lbalucos/Wi4B_WiSN_5.0/projectwisn_v5_0_0productbookpart1/WiSN_v5.0.0_JN5169_MoB - Product Book (from WiSN_v4.3.0) v20220928.pdf

## WiSN_v5.0.0 – Product Book (Part 1) (starting from WiSN_v4.3.0 project)

Description: WiSN with JN5169 Chip (Module-on-PCB)

Starting from WiSN v4.3.0, make the following changes:

- Assign new version v5.0.0 to project
- Change JN5168-M06 module with JN5169 Chip (use the JN5169 block of WiCL_v1.0)
- Maintain AC side components
- Maintain the same PCB position for the main components
- Maintain the same position for Prog Header and Debug Header (for existing JIG test)
- If necessary make some PCB placement optimization

The changes are detailed in the following pages

Wi4B Doc.rev.20220928

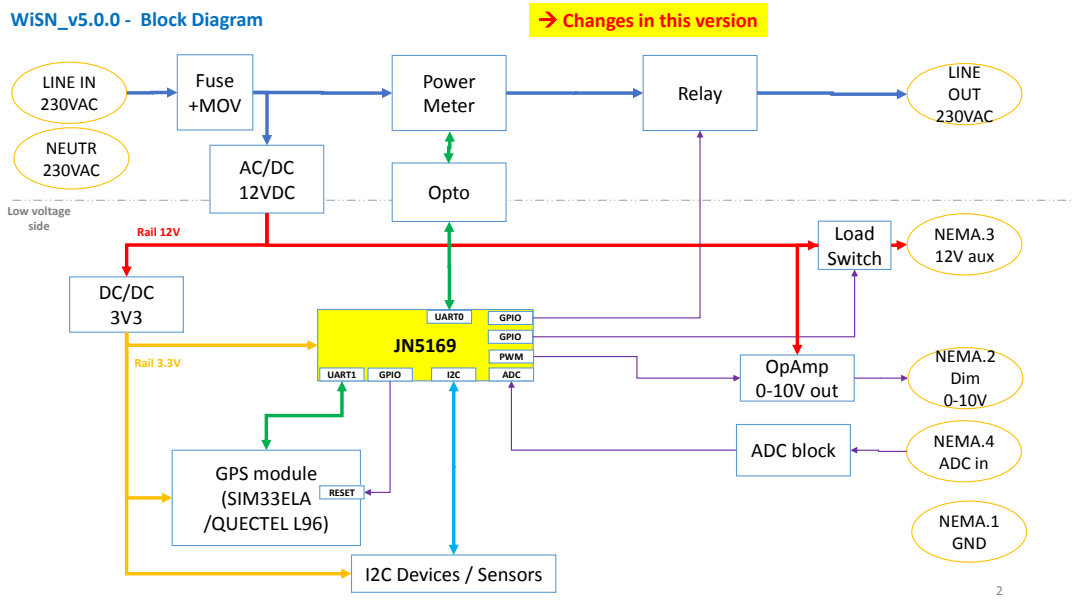
[picture p1: page 2]
Power Meter; AC/DC 12VDC; LINE OUT 230VAC; Opto; OpAmp 0-10V out; ADC block; NEMA.2; Dim 0-10V; NEMA.3 12V aux; NEMA.4; I2C Devices / Sensors; WiSN_v5.0.0 - Block Diagram; Fuse +MOV; UART1; UART0; ADC; PWM; GPIO; Load Switch; RESET; NEMA.1 GND; NEUTR 230VAC; Rail 12V; Rail 3.3V; Low voltage side

→ Changes in this version

Relay LINE IN
230VAC

ADC in GPS module
(SIM33ELA
/QUECTEL L96)

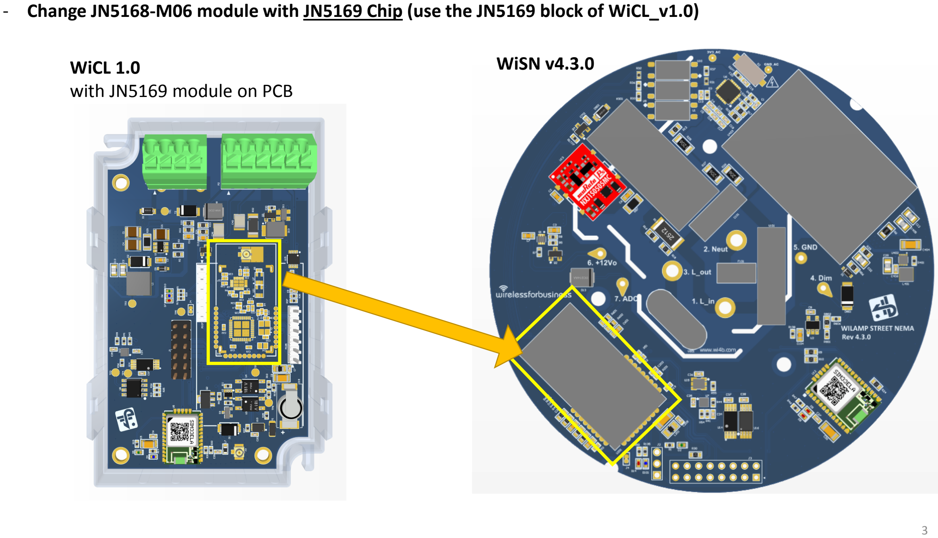
[picture p2: page 3]

WiCL 1.0 | WiSN v4.3.0
with JN5169 module on PCB
- Change JN5168-M06 module with JN5169 Chip (use the JN5169 block of WiCL_v1.0)

JN5169 – Pinout connections
See the ‘WiSN_v5.0.0 - JN5169-MoB Pin assignment.xlsx’ for Jennic connections

J2 – DEBUG Header Pinout

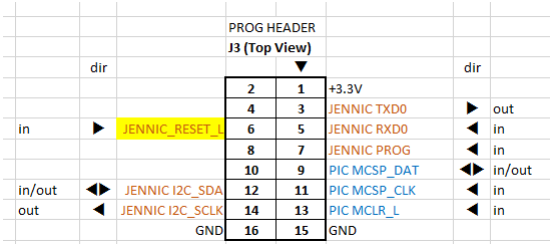
[picture p3: figure]

J3 – PROG Header Pinout

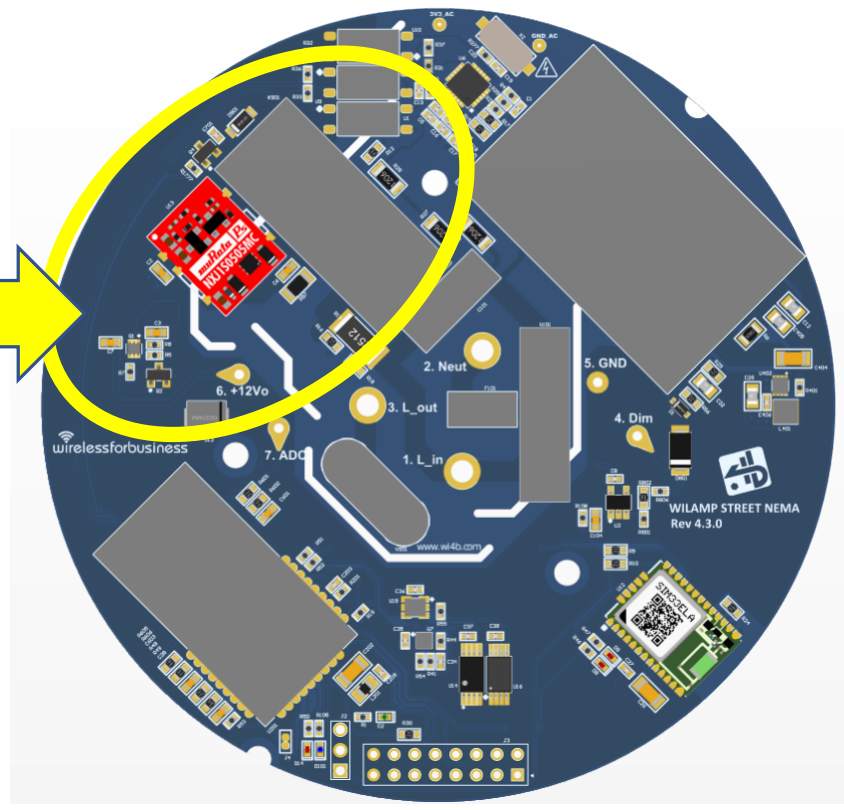
[picture p4: figure]

AC part / Isolation Slot - considerations

Some modifications to this part of the PCB will be required to increase the mechanical strength.

In current versions it occasionally happens that the welds of the Murata DC / DC break / crack.
We have noticed that as a result of external stresses, the two parts of the PCB, separated by the too long slot, undergo deformations at that point that cause the weld to break.

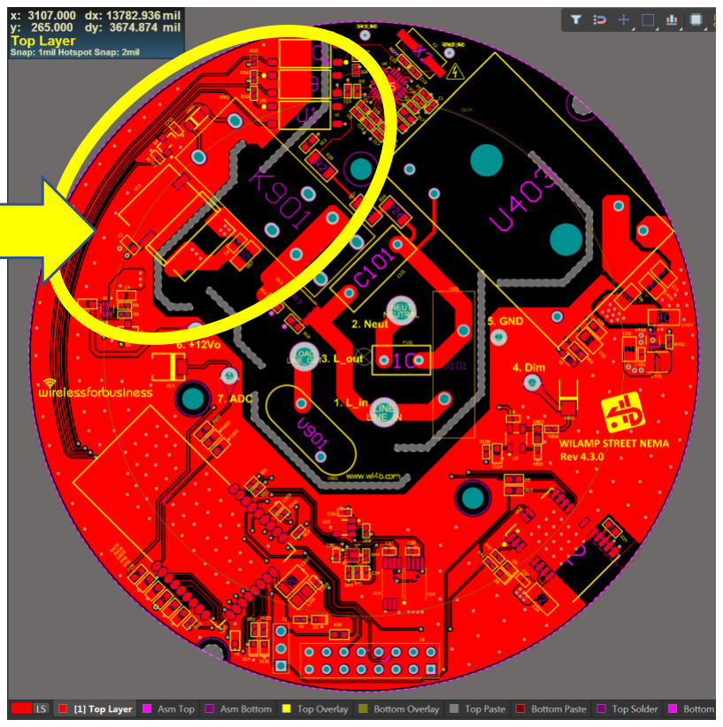
[picture p5: figure]

A solution could be to distance the Murata from the Relay in order to have more space in between and space for a slot with a different layout and possibly shorter under the Murata.

We are considering this point, we will give you more details later on how to proceed with the placement of the components
