lbalucos/Wi4B_WiSN_5.0/WiCL v1.0_rls_20201028/WiCL v1.0/mft/pcb/Impedance Control (50 ohms)/top_50.PNG

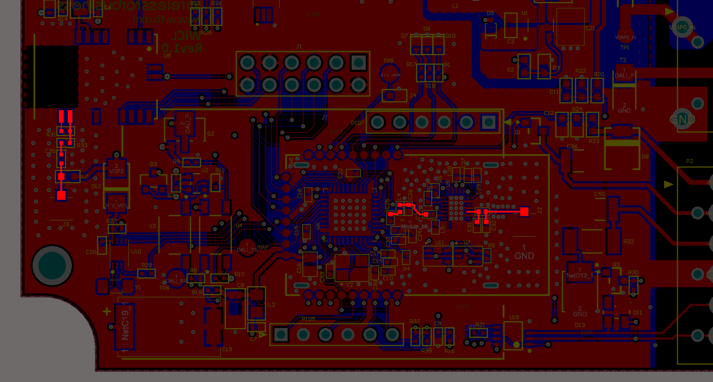
WiCL v1.0_rls_20201028/WiCL v1.0/mft/pcb/Impedance Control (50 ohms)/top_50.PNG
