lbalucos/Wi4B_WiSN_5.0/WiSN v5.0.0/docs/U13 DC-DC converter/Mornsun F0303XT-1WR2 footprint compared to MURATA NXE1S0303MC.png

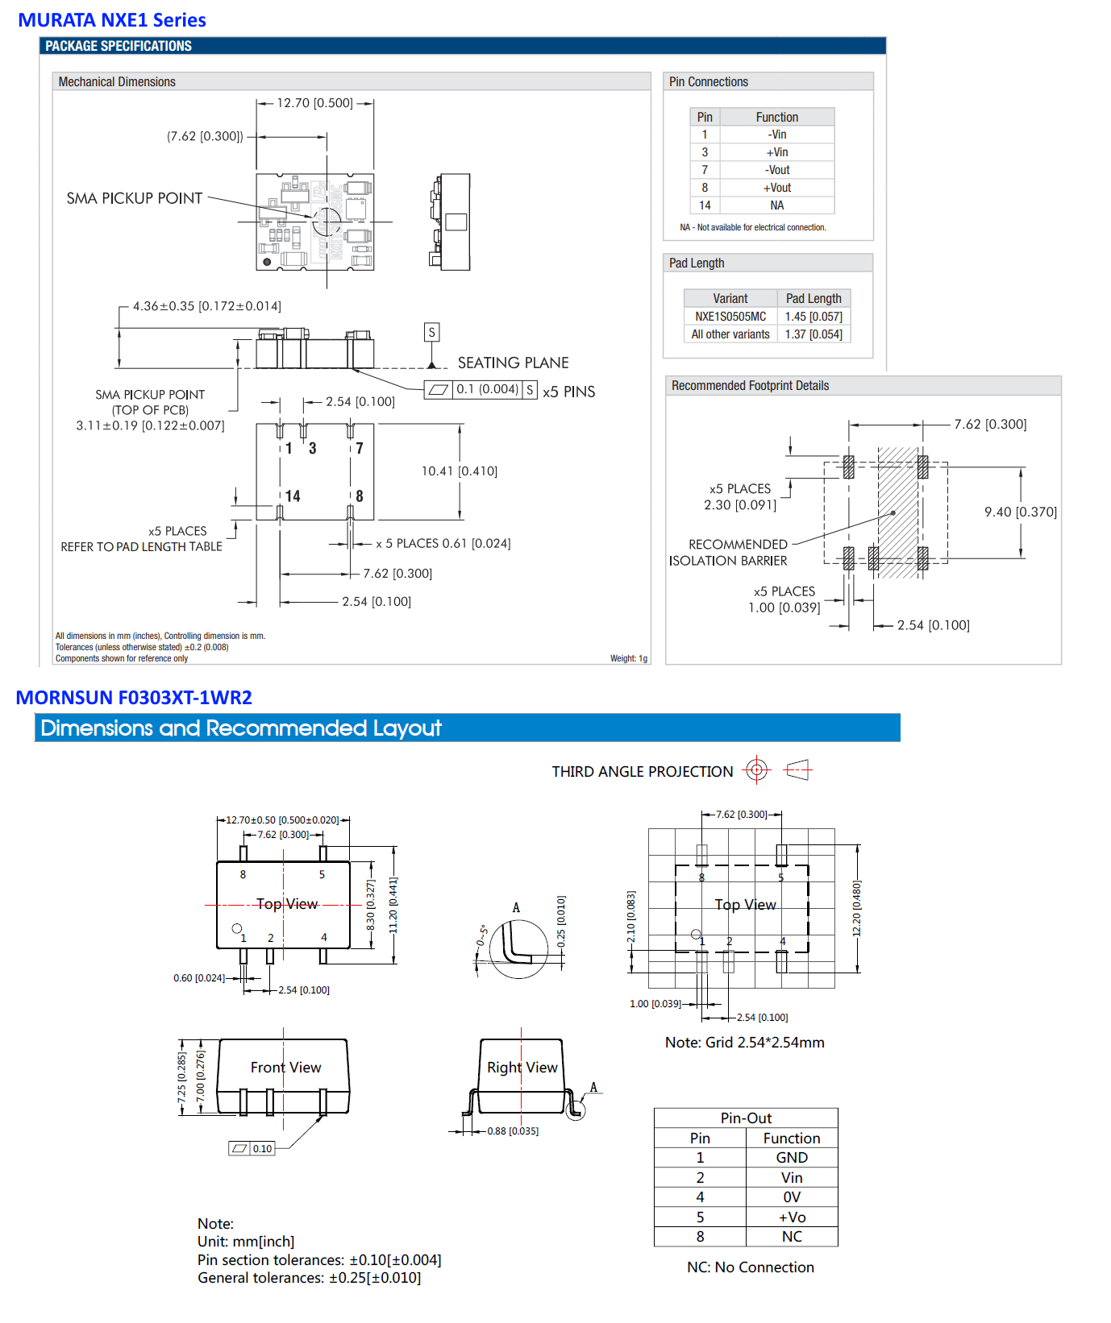
WiSN v5.0.0/docs/U13 DC-DC converter/Mornsun F0303XT-1WR2 footprint compared to MURATA NXE1S0303MC.png
