lbalucos/Wi4B_WiSN_5.0/WiCL v1.0_rls_20201028/WiCL v1.0/mft/pca/bom/wi4b_wicl_bom.xlsx

 |  |  | Project: WiCL
 |  |  | Document: BILL OF MATERIALS (BOM)
 |  |  | Revision: V1.0
 |  |  | Prepared By: AMTI
 |  |  | Release Date: 10/28/2020
 |  |  |  |  |  |  |  |  |  | PRICING
QTY | REFDES | DESC | VALUE | MFT | MPN | PACKAGE | RATING | TYPE | LOAD | Manufacturer 1 | Manufacturer Part Number 1 | Manufacturer Lifecycle 1 | Supplier 1 | Supplier Part Number 1 | Supplier Unit Price 1 | Supplier Subtotal 1
3 | C1, C4, C21 | CAP CER 4.7UF 50V X7R 1210 | 4.7µF | Taiyo Yuden | UMK325B7475KM-T | C1210 | 50V | SMD |  | KEMET | C1210C475K5RACTU | Volume Production | Newark | 29M4627 | 0.128 | 0.384
2 | C2, C13 | CAP CER 10UF 6.3V X7R 0805 | 10µF | Taiyo Yuden | JMK212B7106KG-T | C0805 | 6.3V | SMD |  | KEMET | C0805C106M9RACAUTO | Unknown | Newark | 33AC0561 | 0.065 | 0.325
1 | C3 | CAP CER 0.1UF 25V X7R 0603 | 0.1uF | Kyocera AVX | 06033C104JAT2A | C0603 | 25V | SMD |  | KEMET | C0603C104M3RACTU | Volume Production | Newark | 03M7460 | 0.005 | 0.005
2 | C5, C8 | CAP CER 10UF 16V X7R 1206 | 10µF | Murata Electronics North America | GRM31CR71C106KAC7L | C1206 | 16V | SMD |  | TDK | C3216X7R1C106M160AC | Volume Production | Newark | 87R4266 | 0.034 | 0.068
7 | C6, C7, C9, C20, C34, C35, C37 | CAP CER 0.1UF 50V X7R 0402 | 0.10µF | Murata Electronics North America | GRM155R71H104ME14D | C0402 | 50V | SMD |  | Murata | GCM155R71H104KE02D | Volume Production | Arrow Electronics | GCM155R71H104KE02D | 0.0533 | 0.3731
6 | C10, C15, C17, C18, C23, C27 | CAP CER 0.1UF 10V 10% X5R 0402 | 0.1µF | Murata Electronics North America | GRM155R61A104KA01D | C0402 | 10V | SMD |  | Kyocera AVX | 0402ZD104KAT2A | Volume Production | Newark | 34M9179 | 0.002 | 0.012
1 | C11 | CAP CER 0.22UF 50V X7R 0603 | 0.22µF | Murata Electronics North America | GCM188R71H224KA64D | C0603 | 50V | SMD |  | TDK | C1608X7R1H224K080AB | Volume Production | Newark | 87R3734 | 0.033 | 0.033
1 | C12 | CAP CER 0.22UF 50V X7R 0603 | 0.22µF | Murata Electronics North America | GCM188R71H224KA64D | C0603 | 50V | SMD |  | Murata | GCM188R71H224KA64D | Volume Production | Arrow Electronics | GCM188R71H224KA64D | 0.0269 | 0.0269
1 | C14 | CAP CER 10000PF 25V X7R 0402 | 10000pF | Murata Electronics North America | GRM155R71E103KA01D | C0402 | 25V | SMD |  | Vishay Vitramon | VJ0402Y103KXXCW1BC | Volume Production | Newark | 62AC8249 | 0.002 | 0.002
1 | C16 | CAP CER 10UF 10V X5R 0805 | 10µF | Murata | GRT21BR61A106KE01L | CAPC2012X135N | 10V | SMD |  | Samsung | CL21A106KPCLQNC | Volume Production | Newark | 82AC9392 | 0.011 | 0.011
1 | C19 | CAP 330MF -20% +80% 3.3V SMD | 330mF | Elna | DSK-3R3H334T-HL | ELNA_DSK-3R3H334T-HL | 3.3V | SMD |  | Elna | DSK-3R3H334T-HL | Volume Production | Digi-Key | 604-1160-6-ND | 2.09 | 2.09
1 | C22 | CAP CER 0.1UF 10V 10% X5R 0402 | 0.1µF | Murata Electronics North America | GRM155R61A104KA01D | C0402 | 10V | SMD | DNP | Kyocera AVX | 0402ZD104KAT2A | Volume Production | Newark | 34M9179 | 0.002 | 0.002
1 | C24 | CAP CER 47PF 50V C0G/NP0 0402 | 47pF | Murata | GRM1555C1H470JA01D | CAPC1005X55N | 50V | SMD |  | KEMET | C0402C470J5GACTU | Volume Production | Newark | 03C3054 | 0.002 | 0.002
1 | C25 | CAP CER 1.8PF 50V C0G/NP0 0402 | 1.8pF | Murata | GRM1555C1H1R8CA01D | CAPC1005X55N | 50V | SMD |  | KEMET | C0402C189C5GACTU | Volume Production | Newark | 11AC2872 | 0.011 | 0.011
1 | C26 | CAP CER 1PF 50V C0G/NP0 0402 | 1pF | Murata | GRM1555C1H1R0CA01D | CAPC1005X55N | 50V | SMD |  | TDK | C1005C0G1H010B050BA | Volume Production | Newark | 90R7555 | 0.003 | 0.003
2 | C28, C29 | CAP CER 10PF 50V 5% NP0 0402 | 10pF | Murata Electronics North America | GRM1555C1H100JA01D | C0402 | 50V | SMD |  | Yageo | CC0402JRNPO9BN100 | Volume Production | Newark | 65R7554 | 0.005 | 0.01
3 | C30, C31, C32 | CAP CER 1.2PF 50V C0G/NP0 0402 | 1.2pF | Murata | GRM1555C1H1R2CA01D | CAPC1005X55N | 50V | SMD |  | KEMET | C0402C129C5GACTU | Volume Production | Newark | 01J3923 | 0.003 | 0.009
2 | C33, C38 | CAP CER 12PF 50V C0G/NP0 0402 | 12pF | Murata | GRM1555C1H120JA01D | CAPC1005X55N | 50V | SMD |  | Kyocera AVX | 04025A120JAT2A | Volume Production | Newark | 34M9190 | 0.002 | 0.004
2 | C36, C40 | CAP 22nF 500V ±10% 1210 (3225 Metric) Thickness 1.9mm SMD | 22nF |  | 12107C223KAT2A | CAPC1210(3225)190_N |  | SMD |  | Kyocera AVX | 12107C223KAT2A | Volume Production | Newark | 30H1157 | 0.07 | 0.14
1 | C39 | CAP CER 22PF 50V NP0 0402 | 22pF | Murata Electronics North America | GRM1555C1H220JA01J | C0402 | 50V | SMD |  | KEMET | C0402C220K5GACTU | Volume Production | Newark | 07X0698 | 0.002 | 0.002
1 | D1 | DIODE SCHOTTKY 20V 0.5A SOD123 |  |  | MBR0520L | SOD123 |  | SMD |  | Vishay | MBR0520L | Unknown | Digi-Key | MBR0520LCT-ND | 0.34 | 0.34
2 | D2, D12 | DIODE SCHOTTKY 40V 1A SMA | B140-13-F | Diodes | B140-13-F | DO-214AC, SMA | 40V | SMD |  | Diodes | B140-13-F | Volume Production | Digi-Key | B140-FDICT-ND | 0.37 | 0.74
1 | D3 | DIODE ZENER 3V 250MW TO236AB |  |  | BZX84-C3V0,215 | SOT-23(TO-236AB) |  | SMD |  | Nexperia | BZX84-C3V0,215 | Unknown | Digi-Key | 1727-5032-6-ND | 0.13 | 0.13
1 | D4 | LED BLUE 0402 SMD | Blue | Vishay Semiconductor Opto Division | VLMB1500-GS08 | LED0402(BLUE) |  | SMD | DNP | Vishay | VLMB1500-GS08 | Not Recommended for New Design | Future Electronics | 4101061 | 0.188 | 0.188
1 | D5 | LED GREEN CLEAR CHIP SMD | green | SunLED | XZVG68W-2 | LED0402(GREEN) |  | SMD | DNP | SunLED | XZVG68W-2 | Volume Production | Digi-Key | 1497-1219-1-ND | 0.5 | 0.5
1 | D6 | LED BLUE 0402 SMD | Blue | Vishay Semiconductor Opto Division | VLMB1500-GS08 | LED0402(BLUE) |  | SMD |  | Vishay | VLMB1500-GS08 | Not Recommended for New Design | Future Electronics | 4101061 | 0.188 | 0.188
1 | D7 | LED RED 0402 SMD | Red | Vishay Semiconductor Opto Division | VLMS1500-GS08 | LED0402(RED) |  | SMD |  | Vishay | VLMS1500-GS08 | Volume Production | Arrow Electronics | VLMS1500-GS08 | 0.2977 | 0.2977
1 | D8 | TVS DIODE 33VWM 53.3VC SMB | SMBJ33A-TP | Micro Commercial Co | SMBJ33A-TP | DO-214AA, SMB | 33V | SMD |  | MCC | SMBJ33A-TP | Volume Production | Digi-Key | SMBJ33A-TPMSDKR-ND | 0.45 | 0.45
1 | D9 | DIODE GEN PURP 75V 250MA SOD323 | 1N4448WS-7-F | Diodes | 1N4448WS-7-F | SOD-323 | 75V | SMD |  | Diodes | 1N4448WS-7-F | Volume Production | Newark | 96AC5303 | 0.02 | 0.02
1 | D10 | LED GREEN CLEAR CHIP SMD | green | SunLED | XZVG68W-2 | LED0402(GREEN) |  | SMD |  | SunLED | XZVG68W-2 | Volume Production | Digi-Key | 1497-1219-6-ND | 0.5 | 0.5
1 | D11 | TVS Diode Array, 30 pF, 30 KV, -40 to 85 degC, 4-Pin SOT143, RoHS, Tape and Reel |  |  | SP0503BAHTG | LFUS-SOT143-4_V |  | SMD |  | Littelfuse | SP0503BAHTG | Volume Production | Newark | 06X3961 | 0.373 | 0.373
1 | D13 | 3 W Zener Voltage Regulator, 2-Pin SMB, Pb-Free, Tape and Reel |  |  | SZ1SMB5925BT3G | ONSC-SMB-2-403A-03_H_V |  | SMD |  | ON Semiconductor | SZ1SMB5925BT3G | Volume Production | Mouser | 863-SZ1SMB5925BT3G | 0.62 | 0.62
1 | J1 | CONN HEADER VERT 12POS 2.54MM | 61301221121 | Wurth Electronics | 61301221121 | 61301221121 |  | TH |  | Wurth Electronics | 61301221121 | Volume Production | Digi-Key | 732-5297-ND | 0.78 | 0.78
1 | J2 | RF Connectors / Coaxial Connectors SMT MALE RECEPT AU | U.FL-R-SMT-1(80) | Hirose | U.FL-R-SMT-1(80) | HIROSE_U.FL-R-SMT |  | SMD |  | Hirose | U.FL-R-SMT-1(80) | Volume Production | Future Electronics | 7097379 | 1.12 | 1.12
1 | J3 | CONN UMC JACK STR 50 OHM SMD | U.FL-R-SMT-1(10) | Hirose Electric Co Ltd | U.FL-R-SMT-1(10) | U.FL-R-SMT-1(10) |  | SMD |  | Hirose | U.FL-R-SMT-1(10) | Volume Production | Mouser | 798-U.FL-R-SMT-110 | 1.22 | 1.22
1 | J4 |  |  |  |  | 0603 Jumper
1 | Jennic pinout |  |  |  |  | JN516X PINOUT
1 | L1 | Fixed Inductors MSS6132 AEC-Q200 15 uH 20 % 2.2 A | 15uH | Coilcraft | MSS6132-153MLC | MSS6132-153MLC |  | SMD |  | Coilcraft | MSS6132-153MLC | Volume Production | Mouser | 994-MSS6132-153MLC | 1.38 | 1.38
1 | L2 | FERRITE CHIP 120 OHM 0805 | 120 Ohm | Murata Electronics North America | BLM21PG121SN1D | 0805 INDUCTOR | 3A | SMD |  | Murata | BLM21PG121SN1D | Volume Production | Arrow Electronics | BLM21PG121SN1D | 0.0918 | 0.0918
1 | L3 | FIXED IND 3NH 190MA 400 MOHM SMD | 3nH | Murata | LQP15MN3N0B02D | INDC1005X45N |  | SMD |  | Murata | LQP15MN3N0B02D | Volume Production | Arrow Electronics | LQP15MN3N0B02D | 0.079 | 0.079
1 | L4 | FIXED IND 4.3NH 160MA 600 MOHM | 4.3nH | Murata | LQP15MN4N3B02D | INDC1005X45N |  | SMD |  | Murata | LQP15MN4N3B02D | Volume Production | Arrow Electronics | LQP15MN4N3B02D | 0.0876 | 0.0876
1 | L5 | Inductor RF Chip ThFIXED IND 5.1NH 140MA 700 MOHM | 5.1nH | Murata | LQP15MN5N1B02D | INDC1005X45N |  | SMD |  | Murata | LQP15MN5N1B02D | Volume Production | Arrow Electronics | LQP15MN5N1B02D | 0.1271 | 0.1271
1 | L6 | FIXED IND 2.7NH 220MA 300 MOHM | 2.7nH | Murata | LQP15MN2N7B02D | INDC1005X45N |  | SMD |  | Murata | LQP15MN2N7B02D | Volume Production | Arrow Electronics | LQP15MN2N7B02D | 0.1516 | 0.1516
1 | L7 | FIXED IND 33NH 100MA 2.8 OHM SMD | 33nH | Murata Electronics North America | LQP18MN33NG02D | 0603 INDUCTOR | 100MA 2.8 OHM | SMD |  | Murata | LQP18MN33NG02D | Volume Production | Arrow Electronics | LQP18MN33NG02D | 0.167 | 0.167
1 | P1 | Fixed Terminal Blocks PTSA 1.5/4-3.5-Z | 1985218 | Phoenix Contact | 1985218 | 1985218 (4pin) |  | TH |  | Phoenix Contact | 1985218 | Volume Production | Allied Electronics | 70055071 | 0.51 | 0.51
1 | P2 | TERM BLOCK PCB 6POS 3.5MM GREEN | 1985234 | Phoenix Contact | 1985234 | 1985234 (6 PIN) |  | TH |  | Phoenix Contact | 1985234 | Volume Production | Farnell | 1792773 | 0.79955 | 0.79955
2 | P105, P107 | CONN HEADER 6POS .100 VERT TIN | 22284060 | Molex Inc | 22284060 | HDR1X6 |  | TH |  | Molex | 22-28-4060 | Volume Production | Newark | 94C4038 | 0.105 | 0.21
2 | Q1, Q3 | IC INDCT LOAD DRVR AUTO SOT23 | NUD3124LT1G | ON Semiconductor | NUD3124LT1G | SOT-23-3 |  | SMD |  | ON Semiconductor | NUD3124LT1G | Volume Production | Newark | 04R7856 | 0.134 | 0.268
1 | Q2 | TRANS NPN MED 1A 80V SOT89 |  |  | BCX56-16,115 | SOT 89-3 |  | SMD |  | Nexperia | BCX56-16,115 | Unknown | Digi-Key | 1727-2930-6-ND | 0.39 | 0.39
9 | R1, R11, R17, R18, R30, R36, R37, R38, R39 | RES SMD 1K OHM 1% 1/10W 0402 | 1k | Vishay Beyschlag | MCS04020C1001FE000 | R0402 | 1/10W | SMD |  | Vishay Beyschlag | MCS04020C1001FE000 | Volume Production | Newark | 65AC3521 | 0.234 | 2.11
1 | R2 | RES SMD 31.6K OHM 1% 1/10W 0603 | 31.6k | Panasonic | ERJ-3EKF3162V | R0603 | 1/10W | SMD |  | KOA Speer | RK73H1JTTDD3162F | Volume Production | Arrow Electronics | RK73H1JTTDD3162F | 0.002 | 0.002
1 | R3 | RES SMD 10K OHM 1% 1/10W 0603 | 10k | Panasonic Electronic Components | ERJ-3EKF1002V | R0603 | 0.1W, 1/10W | SMD |  | Vishay | CRCW0603-10K0FKEA | Volume Production | Newark | 61M5335 | 0.003 | 0.003
1 | R4 | RES SMD 43K OHM 1% 1/16W 0402 | 43k | Yageo | RC0402FR-0743KL | RESC1005X40N | 1/16W | SMD |  | Vishay | CRCW040243K0FKED | Volume Production | Newark | 26W9119 | 0.003 | 0.03
2 | R5, R19 | RES SMD 47K OHM 1% 1/16W 0402 | 47k | Yageo | RC0402FR-0747KL | R0402 | 1/16W | SMD |  | Bourns | CR0402-FX-4702GLF | Volume Production | Newark | 87W5956 | 0.003 | 0.006
1 | R6 | RES SMD 1.5K OHM 1% 1/16W 0402 | 1.5k | Yageo | RC0402FR-071K5L | RESC1005X40N | 1% 1/16W | SMD |  | Vishay | CRCW0402-1K50FKED | Volume Production | Newark | 42K3374 | 0.003 | 0.003
1 | R7 | RES SMD 422 OHM 1% 1/10W 0402 | 422 | Panasonic Electronic Components | ERJ-2RKF4220X | R0402 | 1/10W | SMD |  | Samsung | RC1005F4220CS | Volume Production | Arrow Electronics | RC1005F4220CS | 0.036 | 0.036
1 | R8 | RES SMD 4.7K OHM 1% 1/16W 0402 | 4.7k | Yageo | RT0402FRE074K7L | R0402 | 1/16W | SMD |  | Yageo | RC0402FR-074K7L | Volume Production | Newark | 75X0133 | 0.004 | 0.004
5 | R9, R10, R28, R40, R41 | RES SMD 330 OHM 1% 1/16W 0402 | 330 | Vishay Dale | CRCW0402330RFKED | R0402 | 1/16W | SMD |  | TE Connectivity | CRG0402F330R | Volume Production | Arrow Electronics | CRG0402F330R | 0.0019 | 0.0095
1 | R12 | RES SMD 1.2K OHM 1% 1/16W 0402 | 1.2k | Yageo | RC0402FR-071K2L | RESC1005X40N | 1/16W | SMD |  | Vishay | CRCW04021K20FKED | Volume Production | Newark | 89M6589 | 0.005 | 0.005
3 | R13, R25, R26 | RES SMD 1K OHM 1% 1/10W 0402 | 1k | Vishay Beyschlag | MCS04020C1001FE000 | R0402 | 1/10W | SMD | DNP | Panasonic | ERJ-2RKF1001X | Volume Production | Newark | 38AH8221 | 0.006 | 0.018
2 | R14, R15 | RES SMD 330 OHM 1% 1/16W 0402 | 330 | Vishay Dale | CRCW0402330RFKED | R0402 | 1/16W | SMD | DNP | TE Connectivity | CRG0402F330R | Volume Production | Arrow Electronics | CRG0402F330R | 0.0019 | 0.0038
1 | R16 | RES SMD 4.7K OHM 1% 1/10W 0402 | 4.7k | Vishay Beyschlag | MCS04020C4701FE000 | R0402 | 1/10W | SMD |  | Panasonic | ERJ-2RKF4701X | Volume Production | Newark | 64R5288 | 0.003 | 0.003
2 | R20, R23 | RES SMD 68K OHM 0.1% 1/10W 0603 | 68k | Panasonic Electronic Components | ERA-3AEB683V | R0603 | 1/10W | SMD |  | Susumu | RG1608P-683-B-T5 | Volume Production | Arrow Electronics | RG1608P-683-B-T5 | 0.0939 | 0.1878
2 | R21, R27 | RES SMD 0.0OHM JUMPER 1/16W 0402 | 0 | Vishay Dale | CRCW04020000Z0ED | R0402 | 63mW | SMD |  | Vishay | CRCW04020000Z0ED | Volume Production | Newark | 24W1849 | 0.004 | 0.008
2 | R22, R24 | RES SMD 5.6K OHM 0.1% 1/10W 0603 | 5.6k | Panasonic Electronic Components | ERA-3AEB562V | R0603 | 1/10W | SMD |  | Panasonic | ERA-3AEB562V | Volume Production | Newark | 01X1328 | 0.015 | 0.03
1 | R29 | RES 1K OHM 1% 1/2W 1206 | 1k | Stackpole Electronics | RNCP1206FTD1K00 | R1206 | 1/2W | SMD |  | Vishay Dale | CRCW12061K00FKEAHP | Volume Production | Newark | 68R3002 | 0.039 | 0.039
1 | R31 | RES SMD 0.0OHM JUMPER 1/10W 0402 | 0 | Vishay Beyschlag | MCS04020Z0000ZE000 | R0402 | 0.1W | SMD | DNP
1 | R32 | RES Thick Film, 470O, 5%, 0.75W, 200ppm/°C, 2010 | 470 |  |  | FP-CRCW2010-e3-MFG |  | SMD |  | Panasonic | ERJ-12ZYJ471U | Volume Production | Newark | 53W4089 | 0.027 | 0.027
1 | R33 | RES SMD 0.0OHM JUMPER 1/10W 0402 | 0 | Vishay Beyschlag | MCS04020Z0000ZE000 | R0402 | 0.1W | SMD
1 | SH1 | Shield | 42-100017-01 | TSC | 42-100017-01 | 42-100017-01(Shield) |  | SMD
1 | T2 | TVS Diodes - Transient Voltage Suppressors 22Vr 400W 11.3A 5% BiDirectional | SMAJ22CA | Littelfuse | SMAJ22CA | DO-214AC | 22 V | SMD |  | Littelfuse | SMAJ22CA | Volume Production | Newark | 71J1991 | 0.086 | 0.086
7 | TP1, TP2, TP3, TP4, TP5, TP6, TP7 | Test Point 2mm |  |  |  | Test Point 2mm |  | SMD
7 | TP8, TP9, TP10, TP11, TP12, TP13, TP14 | Test Point 3mm |  |  |  | Test Point 3mm |  | SMD
1 | U1 | IC REG BUCK ADJ 0.6A SOT23-6 | MCP16301T-I/CHY | Microchip | MCP16301T-I/CHY | SOT-23-6 | 0.6A | SMD |  | Microchip | MCP16301T-I/CHY | Volume Production | Newark | 58T3650 | 0.847 | 0.847
1 | U2 | NXP - PSSI2021SAY,115 - IC, CURRENT REGULATOR, 75V, 50MA, 5-SOT-353, FULL REEL | PSSI2021SAY,115 |  | PSSI2021SAY,115 | SOT353 |  | SMD |  | Nexperia | PSSI2021SAY,115 | Unknown | Newark | 70R7980 | 0.084 | 0.084
2 | U3, U4 | OPTOISOLATOR 3.75KV TRANS 4-SOP | LTV-357T | Lite-On Inc. | LTV-357T | 4SMD(gull wing) | 3.75KV | SMD |  | Vishay Lite-On | LTV-356T | Volume Production | Mouser | 859-LTV-356T | 0.25 | 0.5
1 | U5 | A-GPS receiver, with built-in Antenna | SIM33ELA | SIMCom | SIM33ELA | SIM33ELA |  | SMD
1 | U6 | IC RF TXRX+MCU 802.15.4 40-VFQFN | JN5169/001Z | NXP Semiconductors | JN5169/001Z | QFN50P600X600X100-41N |  | SMD |  | NXP Semiconductors | JN5169/001Z | Volume Production | Mouser | 771-JN5169/001Z | 5.62 | 5.62
2 | U7, U11 | IC GATE OR 1CH 2-INP 5TSSOP | 74AHC1G32GW,125 | Nexperia | 74AHC1G32GW,125 | SOT65P210X110-5N |  | SMD |  | Nexperia | 74AHC1G32GW,125 | Unknown | Digi-Key | 1727-3150-1-ND | 0.27 | 0.54
1 | U8 | IC EEPROM 32KBIT 400KHZ 8SO | M24C32-RMN6TP | STMicroelectronics | M24C32-RMN6TP | 8-SOIC |  | SMD |  | STMicroelectronics | M24C32-RMN6TP | Volume Production | Newark | 51AC9289 | 0.09 | 0.09
1 | U9 | IC RF FRONT END MOD 2.4GHZ 24QFN | SE2431L-R | Skyworks | SE2431L-R | QFN40P300X400X90-25N-D |  | SMD |  | Skyworks Solutions | SE2431L-R | Volume Production | Digi-Key | 863-1347-6-ND | 3.28 | 3.28
1 | U10 | Real Time Clock Serial 8-Pin HWSON EP | PCF85063TP/1Z | NXP Semiconductors | PCF85063TP/1Z | SON9P50_200X300X80L40X24T150N |  | SMD |  | NXP Semiconductors | PCF85063TP/1Z | Volume Production | Newark | 68X3135 | 0.405 | 0.405
1 | U12 | ACCELEROMETER 2-8G I2C/SPI 12LGA | KX122-1037 | Kionix Inc. | KX122-1037 | KX122-1037 |  | SMD |  | Kionix Inc. | KX122-1037 | Manual Solution
1 | U14 | IC CRYPTO 4.5KB I2C | ATSHA204A-XHDA-T | Microchip Technology | ATSHA204A-XHDA-T | TSSOP-8 (wide Body) |  | SMD |  | Microchip / Atmel | ATSHA204A-XHDA-T | Volume Production | Digi-Key | ATSHA204A-XHDA-TDKR-ND | 0.66 | 0.66
1 | U15 | Dual Buffer/Driver With 3-State Outputs, DCT0008A, LARGE T&R | SN74LVC2G241DCTR |  | SN74LVC2G241DCTR | DCT0008A_L |  | SMD |  | Texas Instruments | SN74LVC2G241DCTR | Volume Production | Newark | 76C4209 | 0.145 | 0.145
1 | Y1 | CRYSTAL 32.7680 KHZ 7.0PF SMD | 32.768kHz | Epson | FC-13532.7680KA-AG5 | XTAL320X150X80L75X150N |  | SMD |  | Epson | FC-135 32.7680KA-AG5 | Not Recommended for New Design | Digi-Key | SER4271DKR-ND | 0.38 | 0.38
1 | Y2 | CRYSTAL 32.0000MHZ 9PF SMD | 32MHz | Abracon | ABM8-32.000MHZ-9-D1G-T | OSCCC320X250X80L75X100N |  | SMD |  | Abracon | ABM8-32.000MHZ-9-D1G-T | Unknown | Newark | 01AH9081 | 0.236 | 0.236
