lbalucos/Wi4B_WiSN_5.0/projectwisn_v5_0_0productbookpart1/_DCDC_12V_3V3 - PN List.xlsx

Line #74: Main DC/DC converter
 | MFT | PN | DESCRIPTION | NOTE | ORDER PN | PRICE EUR @1000pcs | MOUSER STOCK | DIGIKEY STOCK | SETM supplier Stock
 | TEXAS INST | TPS62172 | IC REG BUCK 3.3V 500MA | CURRENT PN in BOM | TPS62172DSGT | 0.911 | OUT OF STOCK | OUT OF STOCK | LT 63 weeks
 | MPS | MP2459GJ-Z | Buck Switching Regulator IC Positive Adjustable 0.81V 1 Output 500mA SOT-23-6 Thin, TSOT-23-6 |  | MP2459GJ-Z | 0.652 | 69036 | 3000
 | MPS | MP2459GJ-P | IC REG BUCK ADJ 500MA TSOT23-6. Buck Switching Regulator IC Positive Adjustable 0.81V 1 Output 500mA SOT-23-6 Thin, TSOT-23-6 |  | MP2459GJ-P | 0.861 | 175385 | 10992
 | RENESAS | RAA2116054GP3#JA0 | 60V 0.5A DC/DC STEP-DOWN REGULAT. Buck Switching Regulator IC Positive Adjustable 0.8V 1 Output 500mA SOT-23-6 Thin, TSOT-23-6 |  | RAA2116054GP3#JA0 | 0.752 | 17951 | 0
 | ROHM | BD9G101G-TR | Buck Switching Regulator IC Positive Adjustable 1V 1 Output 500mA SOT-23-6 |  | BD9G101G-TR | 0.831 | 138009 | 22600
IGNORE --> | TOREX | XC9263B755MR-G | Buck Switching Regulator IC Positive Adjustable 1V 1 Output 500mA SC-74A, SOT-753 | XC9263/XC9264 Series is Not Recommended for New Designs. |  | 0.538
IGNORE --> | TOREX | XC9264B755MR-G |  | XC9263/XC9264 Series is Not Recommended for New Designs. |  | 0.538
