lbalucos/Wi4B_WiSN_5.0/projectwisn_v5_0_0productbookpart1/_DCDC_Isolated - PN List.xlsx

Line #70: DC/DC 3V3 isolated
 | MFT | PN | DESCRIPTION | NOTE | ORDER PN | PRICE EUR @1000pcs | MOUSER STOCK | DIGIKEY STOCK | SETM supplier Stock
Current PN --> | Murata Power Solutions | NXJ1S0303MC-R7 | Isolated DC/DC 3V3, 4.2KV | Chip on CERAMIC package. pay attention to the soldering of the pins |  | 3065 | 75 | 1011 | LT 42 WEEKS
Current PN --> | Murata Power Solutions | NXE1S0303MC-R7 | Isolated DC/DC 3V3, 3.0KV | Chip on CERAMIC package. pay attention to the soldering of the pins |  | 2562 | 0 | 0
 | Mornsun | F0303XT-1WR2 | Isolated DC/DC 3V3, 3.0KV | pin-to-pin compatible, plastic package with gull-wing lead, probably it support better the transverse stresses due to PCB deformation compared to Murata ceramic package |  |  | NOT AVAILABLE | NOT AVAILABLE
 | Recom | R1SX-3.33.3 | Isolated DC/DC 3V3, 3.0KV | pin-to-pin compatible, require to slightly widen the pads on the PCB. The package seem plastic |  | 3337 | 5200 | 710
IGNORE -->
