lbalucos/Wi4B_WiSN_5.0/projectwisn_v5_0_0productbookpart1/_EnergyMeter - PN List.xlsx

Line #67: Internal Energy Meter
 | MFT | PN | DESCRIPTION | NOTE | ORDER PN | PRICE EUR @1000pcs | MOUSER STOCK | DIGIKEY STOCK | SETM supplier Stock
 | MAXIM / SILERGY | 78M6610+PSU | Energy Measurement Processor (UART) | CURRENT PN in BOM | OBSOLETE |  | NOT PRESENT | DISCONTINUED | NO QUOTATION
 | SILERGY | SY7T609+S1 | Energy Measurement Processor with Integrated Oscillator & Relay Control | SPI, UART |  |  | NOT PRESENT | NOT PRESENT
 | Analog | ADE7953 | Single Phase Multifunction Metering IC with Neutral Current Measurement | SPI, I2C, or UART communication | ADE7953ACPZ-RL | 2.93 | 50083 | 12961
 | Microchip | MCP39F511 | Power-Monitoring IC with Calculation and Energy Accumulation | UART | MCP39F511-E/MQ | 2.81 | 3000 on order | 1188
 | Cirrus Logic | CS5490 | Two Channel Energy Measurement IC, On-chip measurements / calculations | UART | CS5490-ISZR | 3.22 | 7900 | 0
 | Cirrus Logic | CS5480 | Three Channel Energy Measurement IC, On-chip measurements / calculations | UART, SPI | CS5480-INZ | 2.95 | 500 on order | 0 | AVAILABLE
IGNORE --> | Microchip | MCP3918A1T-E/ML | IC ENERGY METER FRONT END 1CH | SPI, 1CH (non suitable for us: only 1 channel for current masure and SPI interface) | MCP3918A1T-E/ML |  |  |  | AVAILABLE
IGNORE --> | Analog | ADE7763 | Single-Phase Active and Apparent Energy Metering IC | SPI
IGNORE --> | Analog | ADE7761B | Energy Metering IC with On-Chip Fault and Missing Neutral Detection | FREQUENCY out |  | 1.91
IGNORE --> | Analog | ADE7755 | Energy Metering IC with Pulse Output | FREQUENCY out |  | 3.11
