lbalucos/Wi4B_WiSN_5.0/projectwisn_v5_0_0productbookpart1/_Varistor_output - PN List.xlsx

Line #77: Varistor output
 | MFT | PN | DESCRIPTION | NOTE | ORDER PN | PRICE EUR @1000pcs | MOUSER STOCK | DIGIKEY STOCK | SETM supplier Stock
Current PN --> | EPCOS (TDK) | S14K300E2K1 | VARISTOR 470V 6KA DISC 14MM |  | B72214P2301K101 |  | 0 |  | NO QUOTATION
Current PN --> | EPCOS (TDK) | B72214P2301K101 | VARISTOR 470V 6KA DISC 14MM |  | S14K300E2K1 | 0.279 | 3905 | 29735 | LT 20 WEEKS
 | EPCOS (TDK) | B72314P2301K101 | 14MM, 300VAC, 10%, ADVANCED MP C |  |  | 0.389 | 0 | 60359
 | Fenghua HiTech | SVR14D471KA78BH |  |  |  |  | NOT AVAILABLE | NOT AVAILABLE
 | Panasonic | ERZ-V14D471 |  |  |  | 0.281 | 43116 | 1468
IGNORE -->
 |  | VARISTOR SPECS
 |  |  | ELEMENT SIZE NOMINAL: | 14mm
 |  |  | Maximum allowable voltage: | 300 VAC rms
 |  |  | VARISTOR VOLTAGE @ 1mA: | 470 V (tollerance 10% = 423 to 517)
 |  |  | Clamping voltage max @ Ic: | 775 V
 |  |  | Clamping Current Ic: | 50 A
 |  |  | Wmax (2 mS): | 140 J
