lbalucos/Wi4B_WiSN_5.0/(threads)

Thread 7 (2022-10-17):

[HW CR07] AC part / Isolation Slot considerations

lbalucos, 2022-10-17:
From Customer:
Some modifications to this part of the PCB will be required to increase the mechanical strength.

In current versions it occasionally happens that the welds of
the Murata DC / DC break / crack.

We have noticed that as a result of external stresses, the two
parts of the PCB, separated by the too long slot, undergo deformations at that point that cause the weld to break.

A solution could be to distance the Murata from the Relay in
order to have more space in between and space for a slot with
a different layout and possibly shorter under the Murata.

We are considering this point, we will give you more details later
on how to proceed with the placement of the components

lbalucos, 2022-10-24:
**FROM**
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

board cut-outs modified to improve board strength
**TO**
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
