lbalucos/Wi4B_WiSN_5.0/WiCL v1.0_rls_20201028/WiCL v1.0/sch/schematic wicl v1.0.pdf

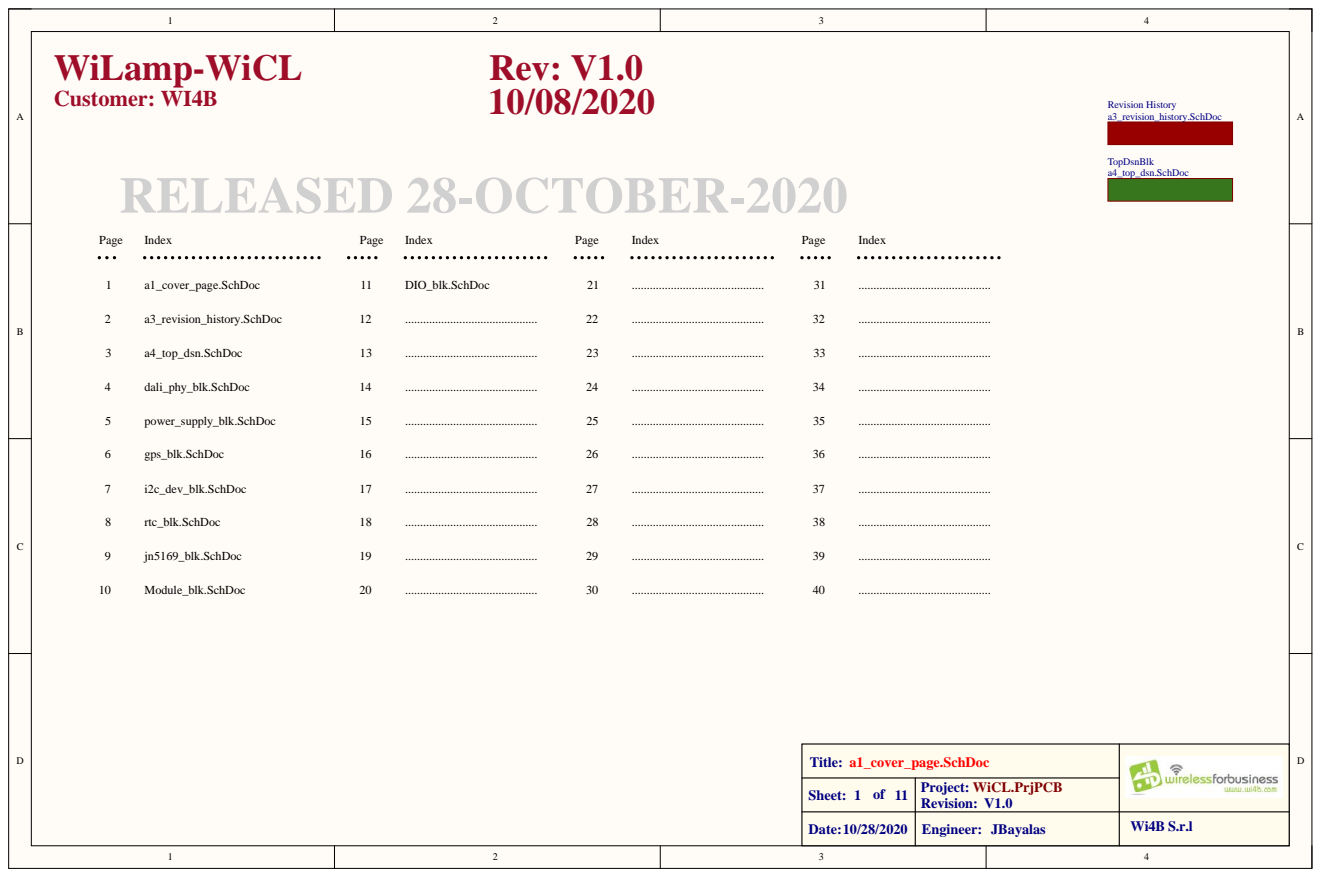
[picture p8: page 1]

Title: a1_cover_page.SchDoc

Sheet: 1 of 11 | Project: WiCL.PrjPCB Revision: V1.0

Date:10/28/2020 | Engineer: JBayalas | Wi4B S.r.l

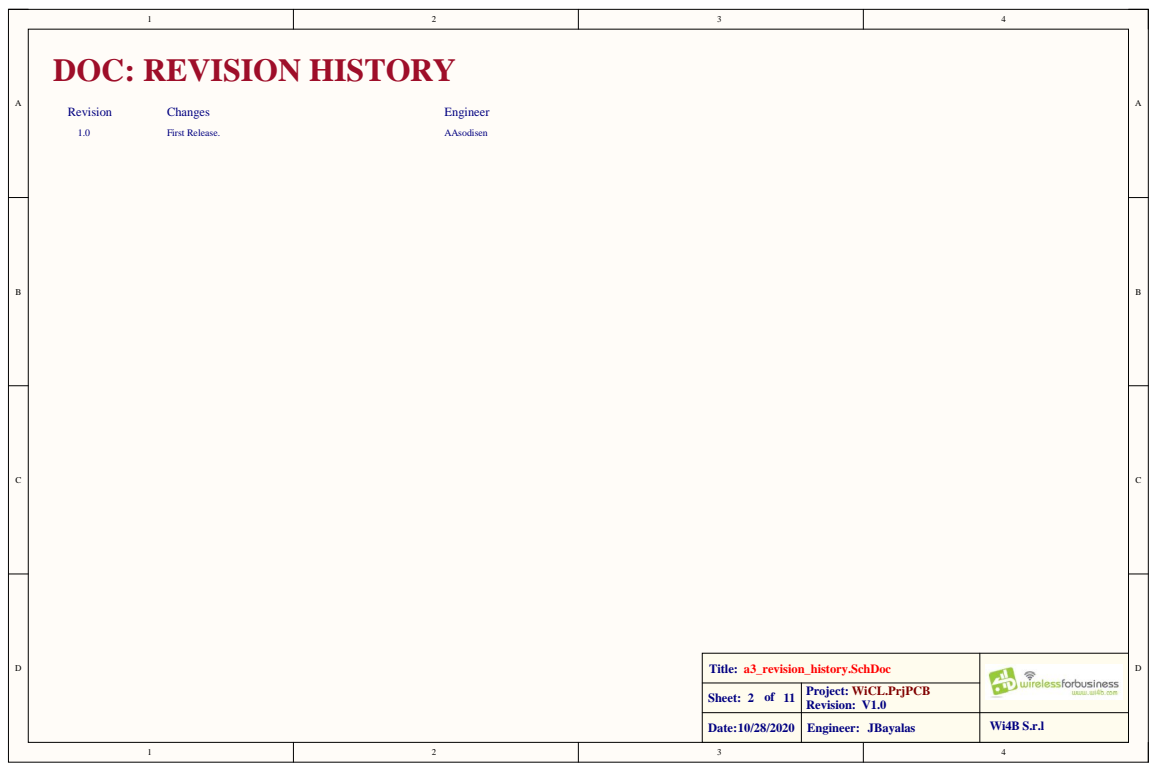
[picture p9: page 2]

Title: a3_revision_history.SchDoc

Sheet: 2 of 11 | Project: WiCL.PrjPCB Revision: V1.0

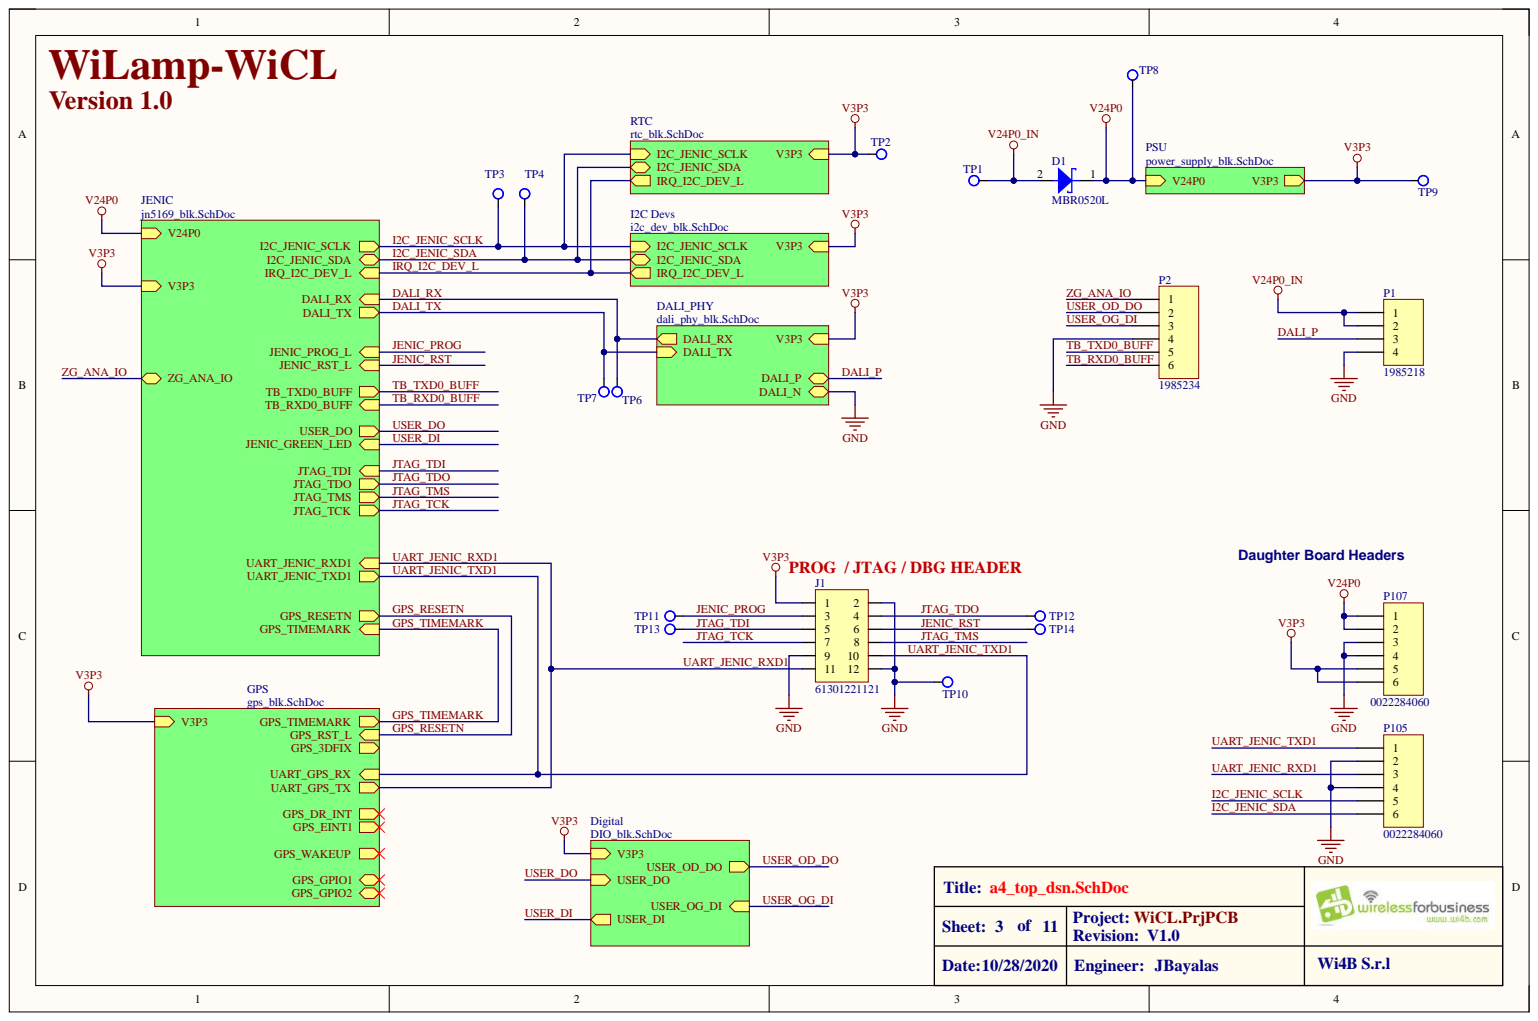
[picture p10: page 3]

I2C_JENIC_SDA
IRQ_I2C_DEV_L

UART_JENIC_TXD1

UART_JENIC_RXD1 | | 11 12

Sheet: 3 of 11 | Project: WiCL.PrjPCB Revision: V1.0

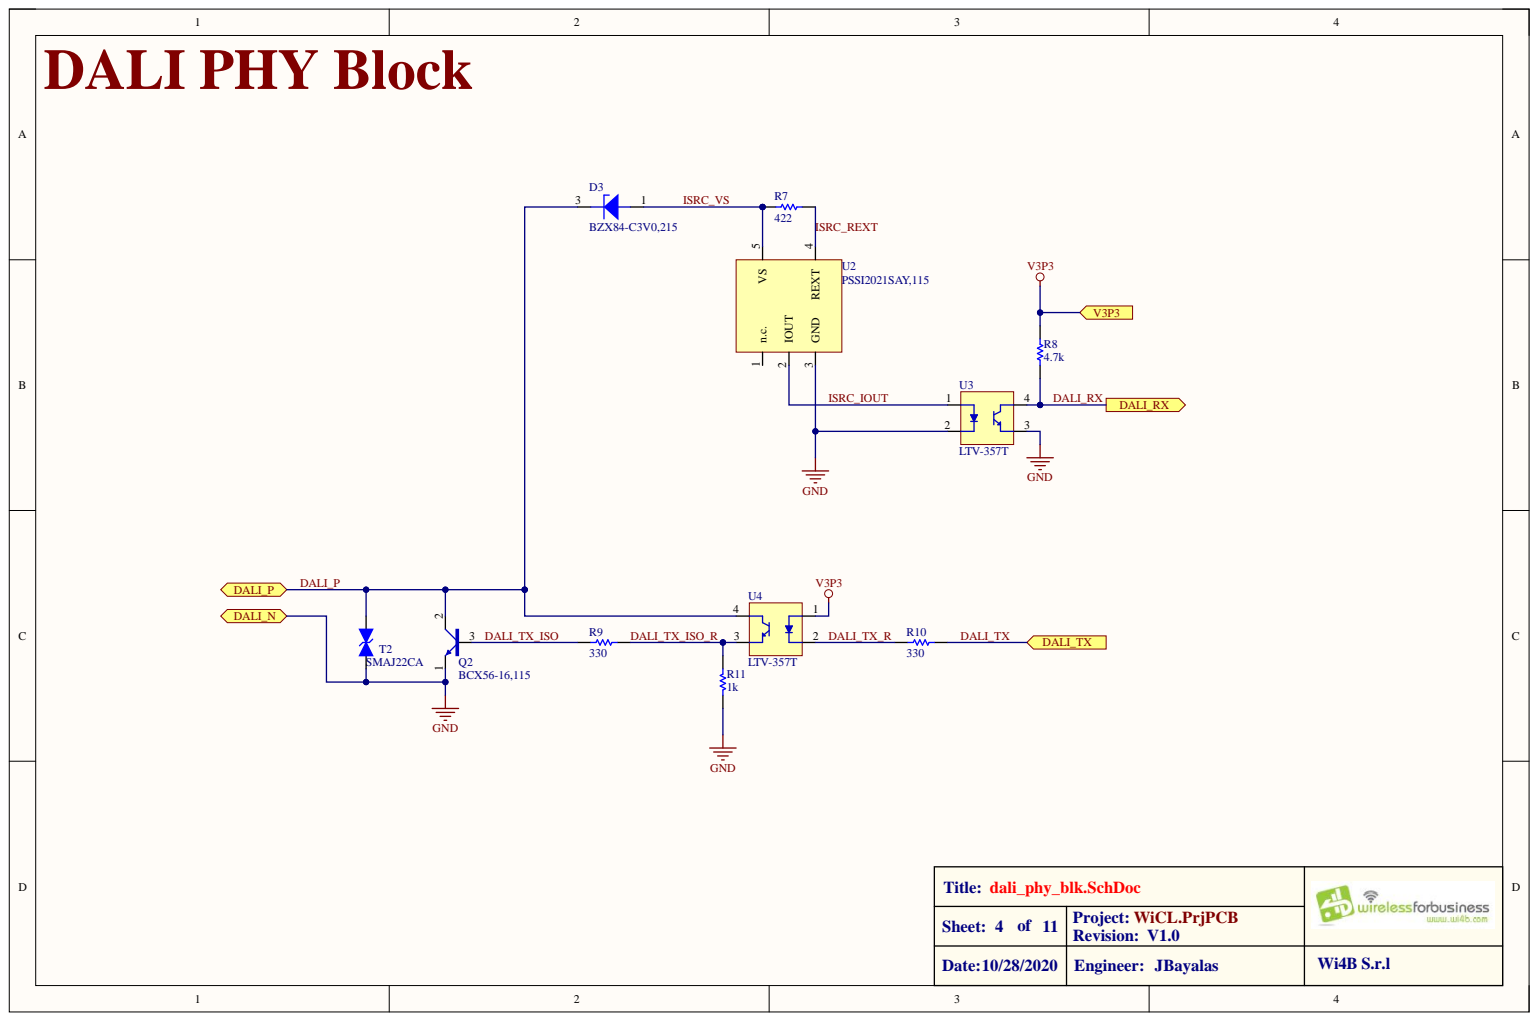
[picture p11: page 4]

Title: dali_phy_blk.SchDoc

Sheet: 4 of 11 | Project: WiCL.PrjPCB Revision: V1.0

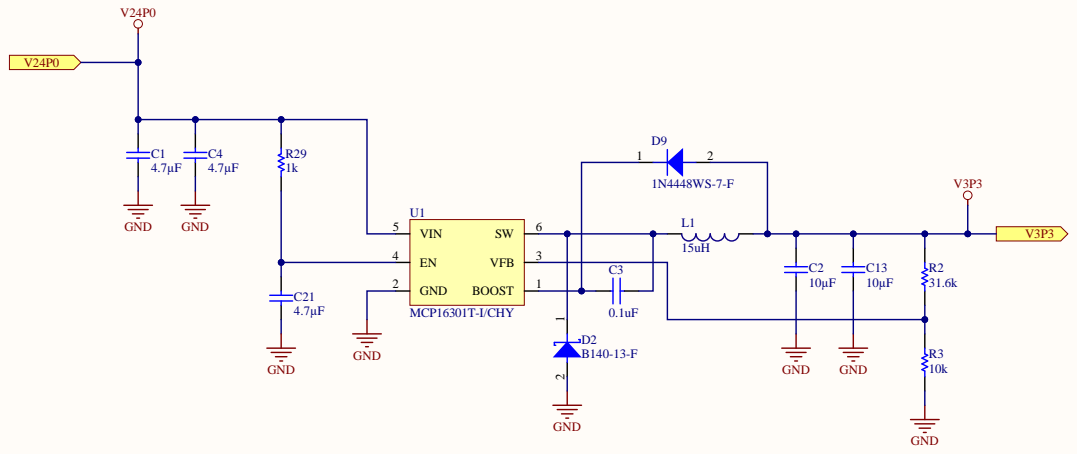
[picture p12: page 5]

Title: power_supply_blk.SchDo c

Sheet: 5 o f 1 1 | Project: WiCL.PrjPCB Revision: V1.0

JBayal a s | Wi4B S.r.l

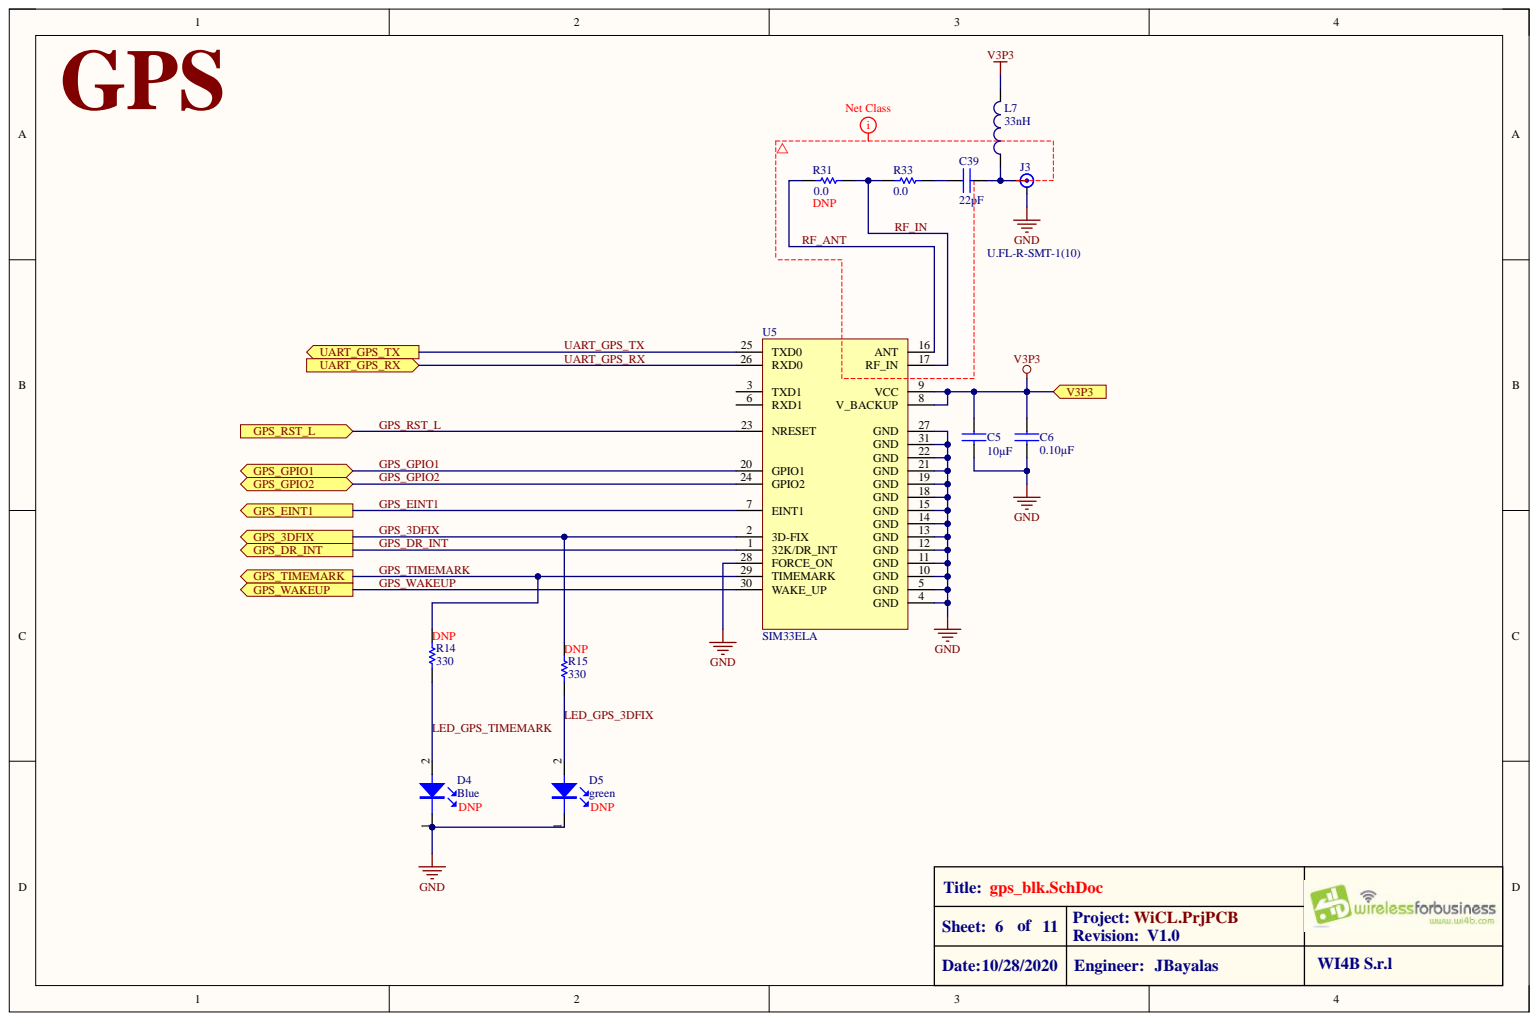
[picture p13: page 6]

Title: gps_blk.SchDoc

Sheet: 6 of 11 | Project: WiCL.PrjPCB Revision: V1.0

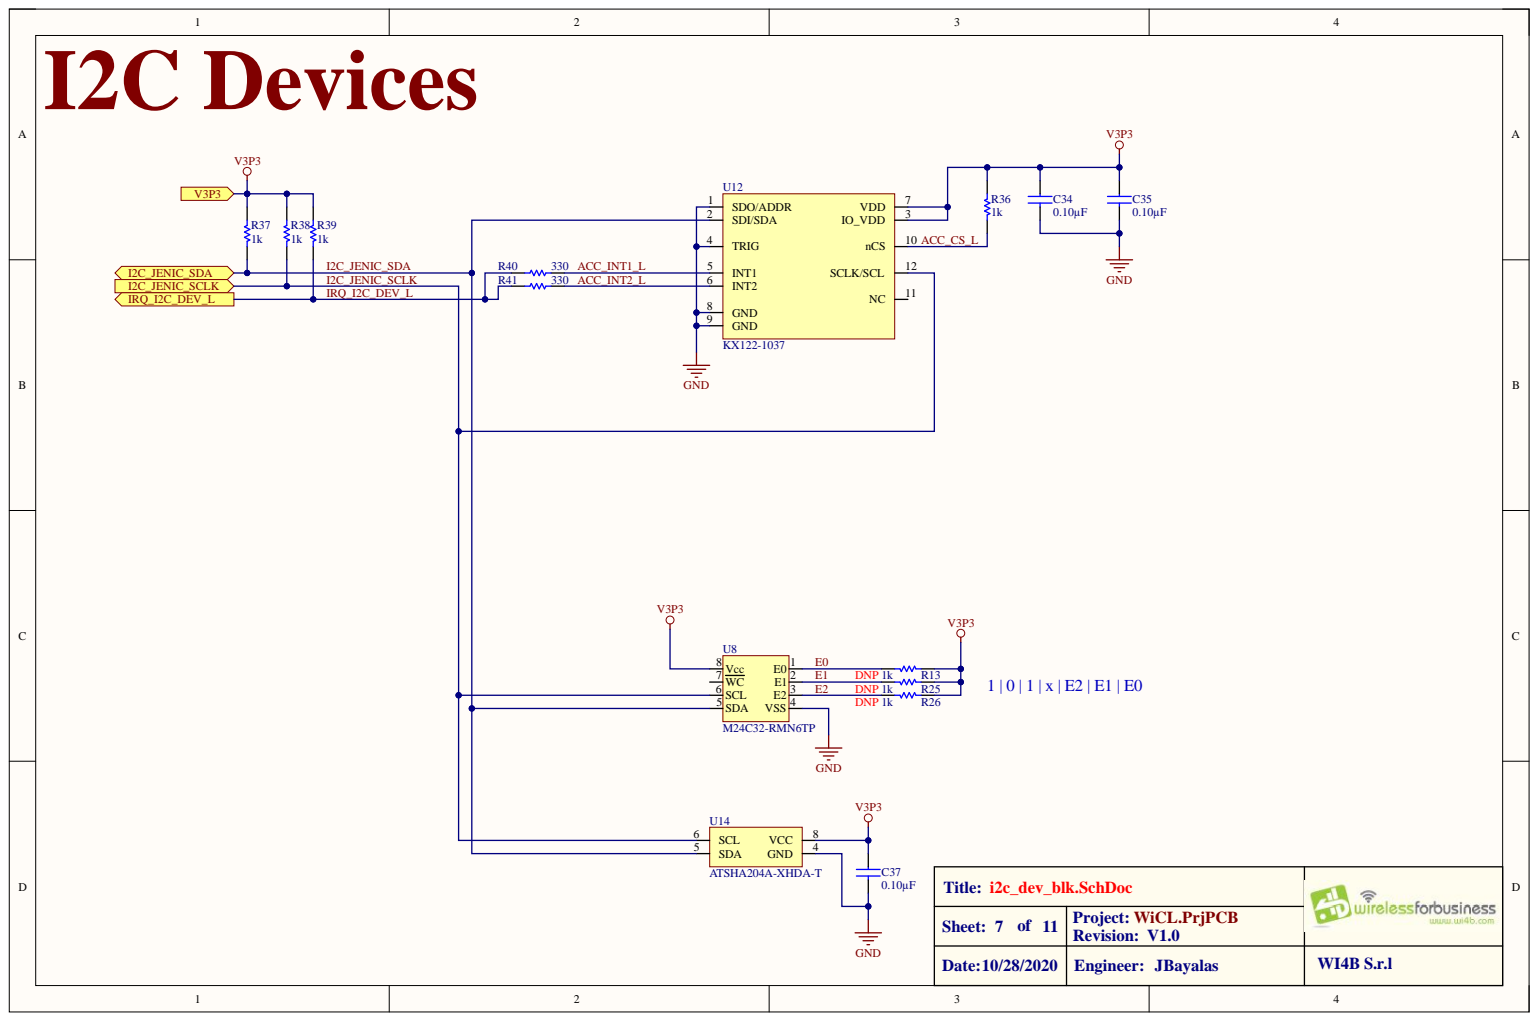
[picture p14: page 7]

R40 330 ACC_INT1_L | | TRIG 4

INT1 5

I2C_JENIC_SCLK | | INT2 6 GND 8

GND 9

Title: i2c_dev_blk.SchDoc

Sheet: 7 of 11 | Project: WiCL.PrjPCB Revision: V1.0

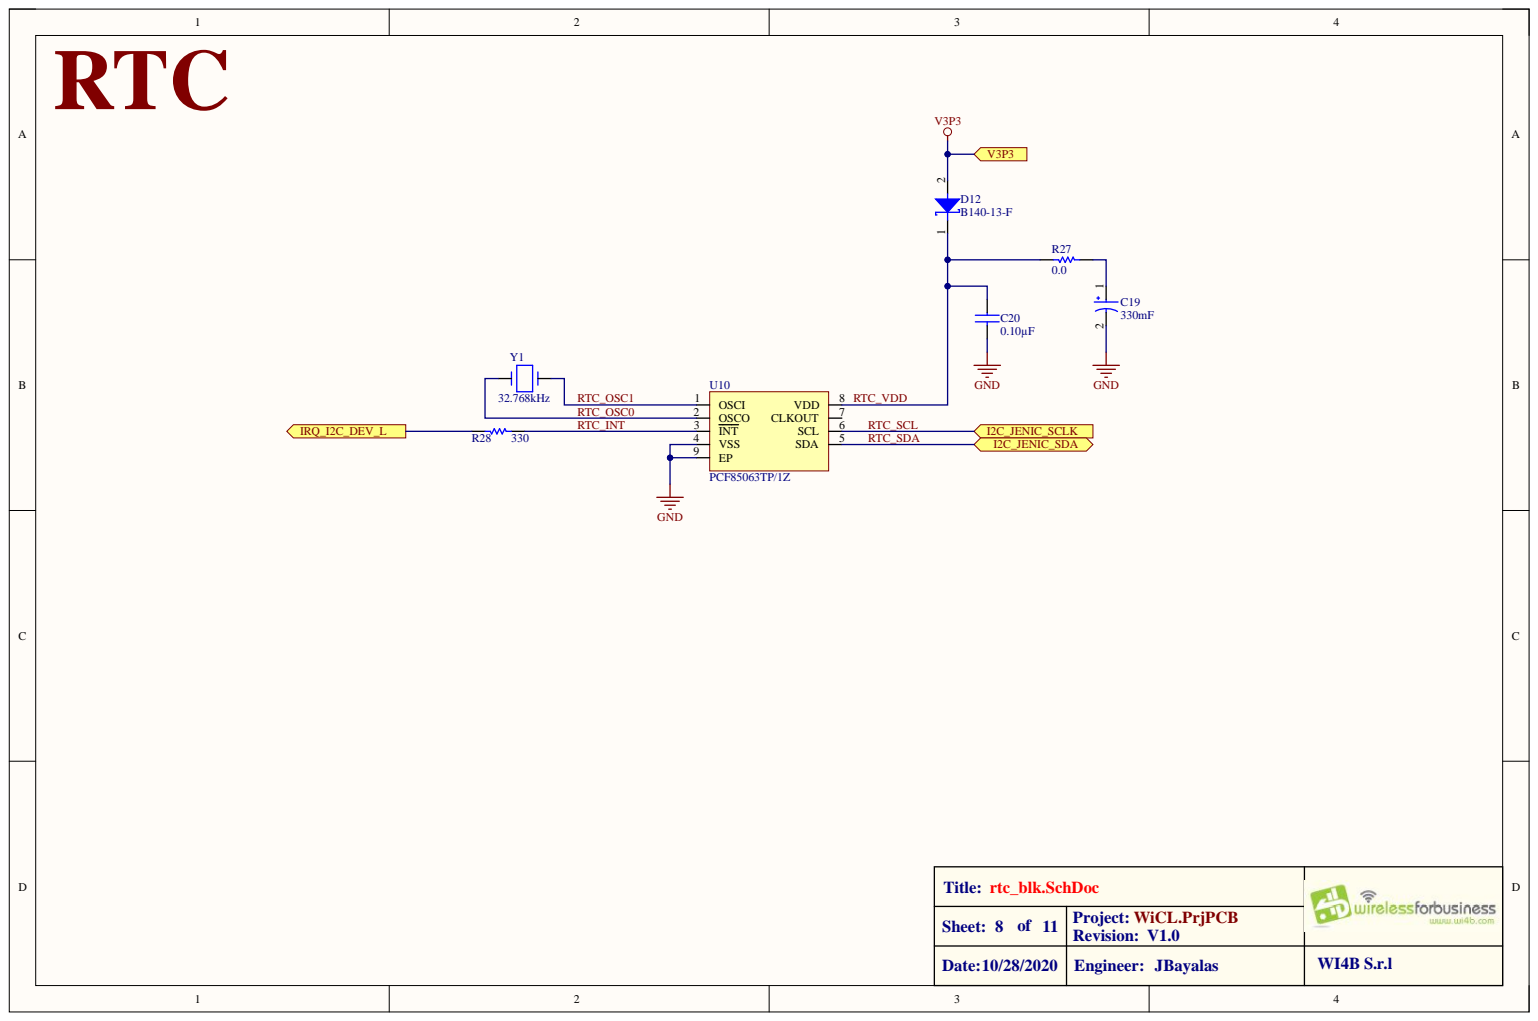
[picture p15: page 8]

Title: rtc_blk.SchDoc

Sheet: 8 o f 1 1 | Project: WiCL.PrjPCB Revision: V1.0

JBayal a s | WI4B S.r.l

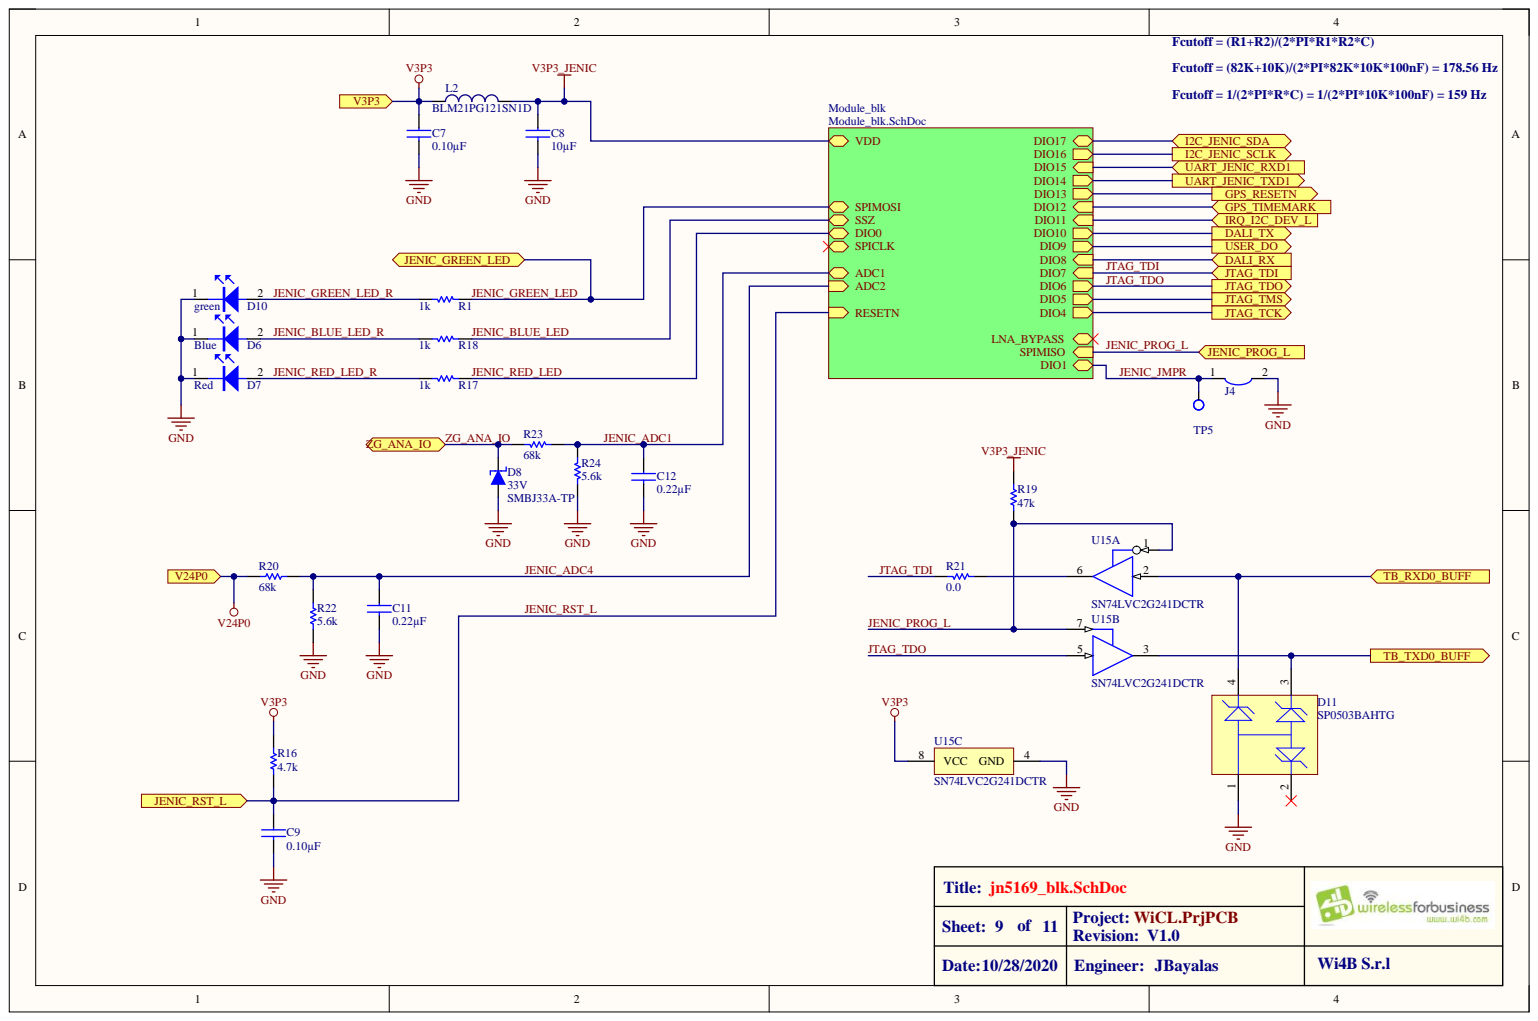
[picture p16: page 9]

Fcutoff = 1/(2*PI*R*C) = 1/(2*PI*10K*100nF) = 159 Hz

Title: jn5169_blk.SchDoc

Sheet: 9 of 11 | Project: WiCL.PrjPCB Revision: V1.0

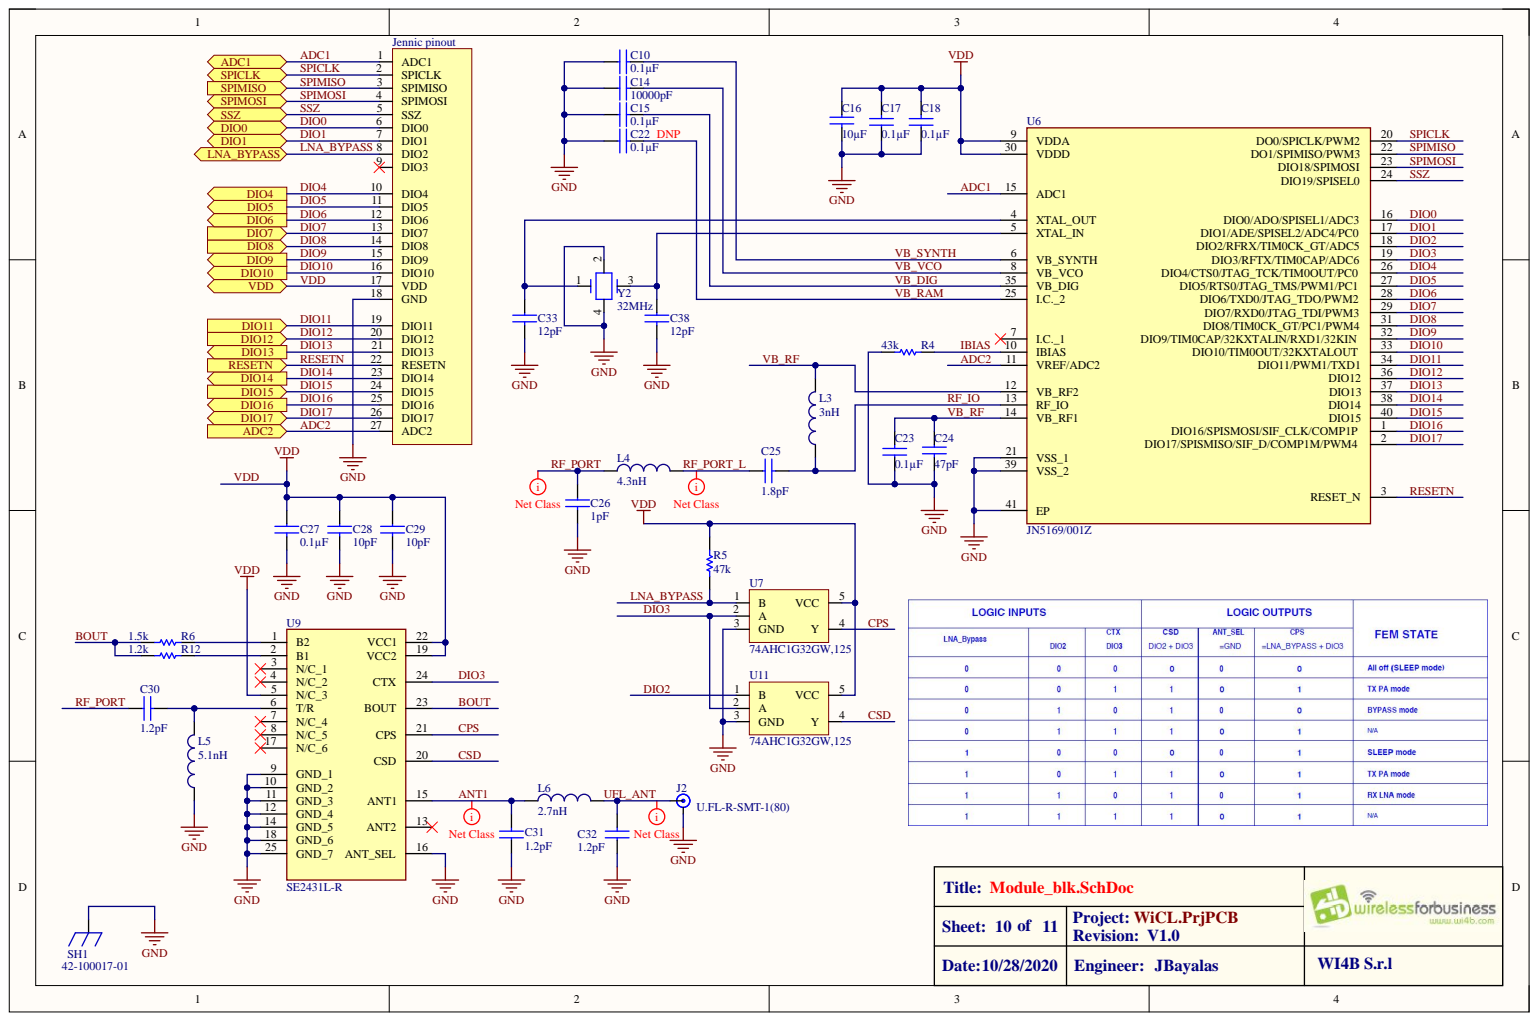
[picture p17: page 10]

10000pF C15 | | C16 | C17 | VDDADC1 C18
0.1 C14 | µ F

RESETN SPICLK SPIMISO SPIMOSI SSZ

DIO12 20
DIO13 21

DIO15 24

DIO17 26 ADC2 27

Module_blk.SchDoc Title:

Sheet: 10 o f 1 1 | Project: WiCL.PrjPCB Revision: V1.0

JBayal a s | WI4B S.r.l

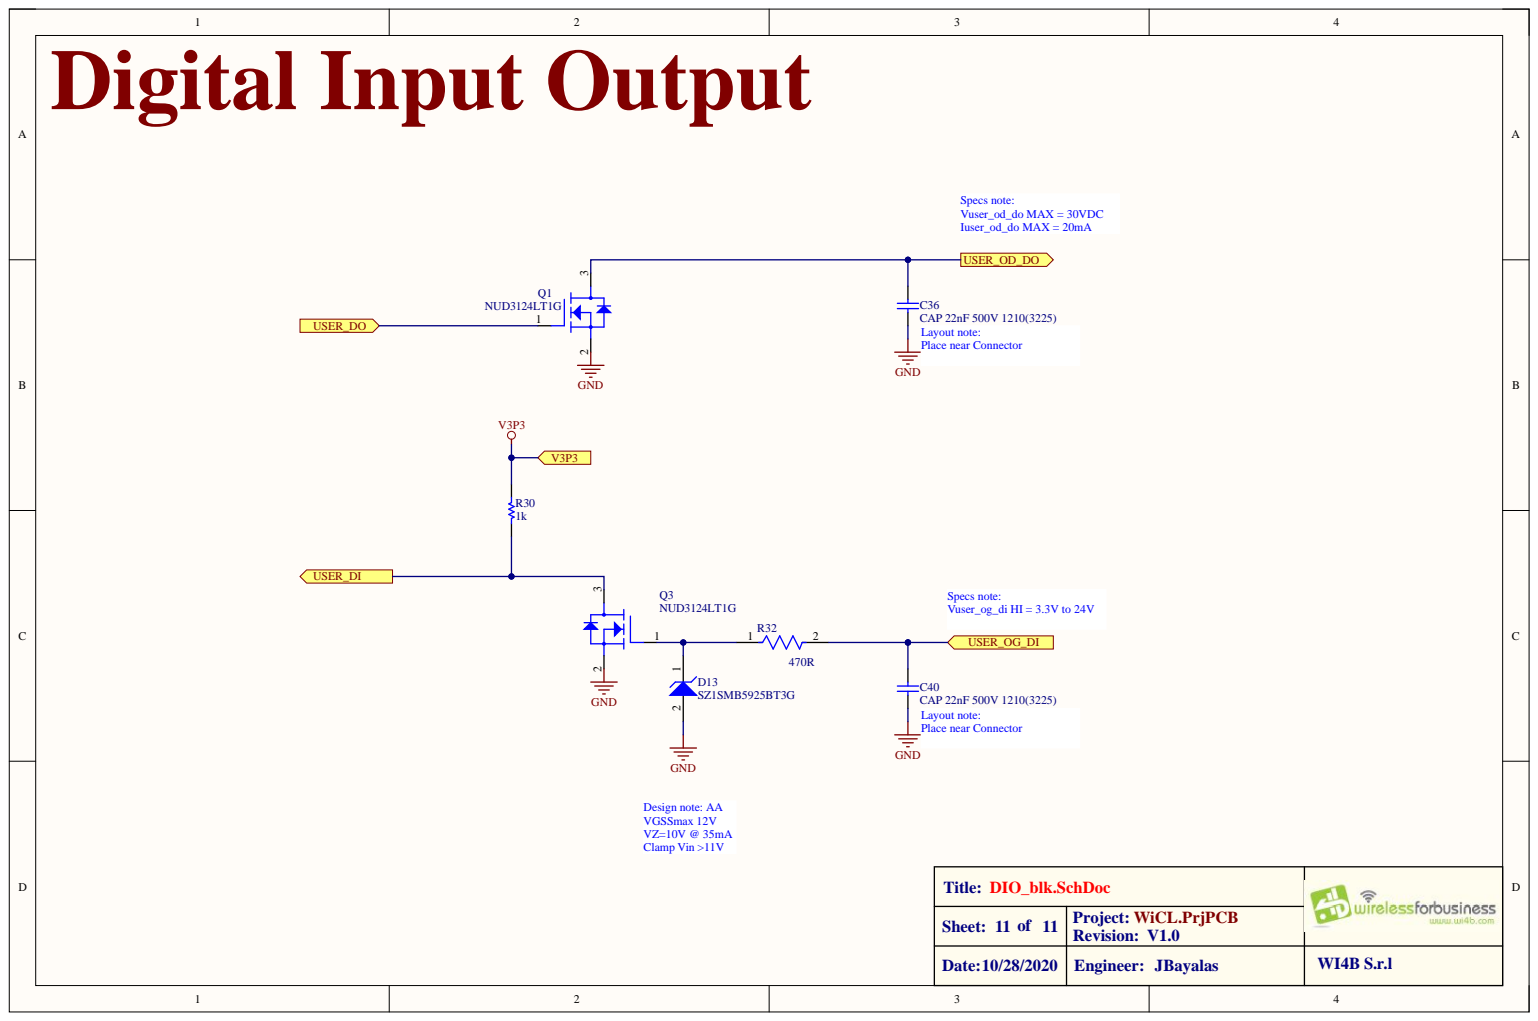
[picture p18: page 11]

Title: DIO_blk.SchDoc

Sheet: 11 of 11 | Project: WiCL.PrjPCB Revision: V1.0
