lbalucos/Wi4B_WiSN_5.0/WiSN v5.0.0/pdf/wisn_v4.3.0.pdf

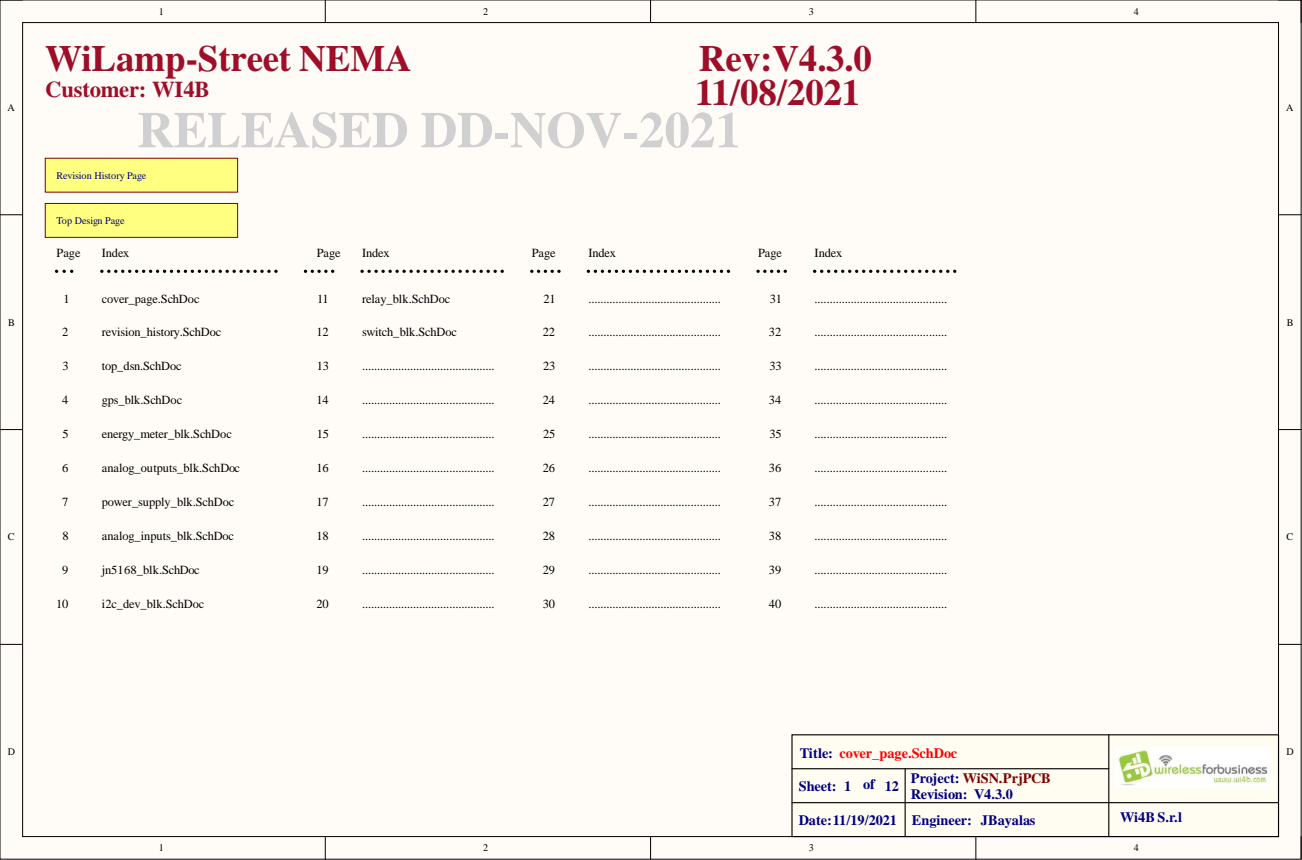
[picture p19: page 1]

Title: cover_page.SchDoc

Sheet: 1 of 12 | Project: WiSN.PrjPCB Revision: V4.3.0

Date:11/19/2021 | Engineer: JBayalas | Wi4BS.r.l

D | D
C | C
B | B
A | A

## Title: revision_history.SchDoc

Sheet: 2 of 12 | Project: WiSN.PrjPCB

## Date:11/15/2021

# DOC: REVISION HISTORY

Revision | Changes | Engineer
1.0 | First Release. | JBayalas
2.0 | added 3 holes on pcb | JBayalas
2.1 | BOM updated | JBayalas
3.0 | Power Supply Schematic updated | JBayalas
4.0 | Fix short circuit on U4 | JBayalas add DNP properties on GPS external antenna.
4.1 | J2, J3 Marked as DNP | JBayalas
4.01 | Added FUNCTION Parameter on C12,C32,D1, | JBayalas D402,D901,R29,R56,R802
| Partitioned DNP compnents in exporting Bom
4.1 | U15 pin 1 reference mark added | JBayalas equivalent parts for K901(relay) added
| R13 FUNCTION parameter changed J4 moved to top side added 0ohm resistor on JN5168 blk
4.1_1 | MFT requirements applied | JBayalas
4.1_1B | 0603 component pad expansion undo | JBayalas 0402 component pad expansion applied
4.3.0 | Remove PIC16LF1947 | JBayalas
| Remove all DALI components (LPC1343 and DALI PHY)

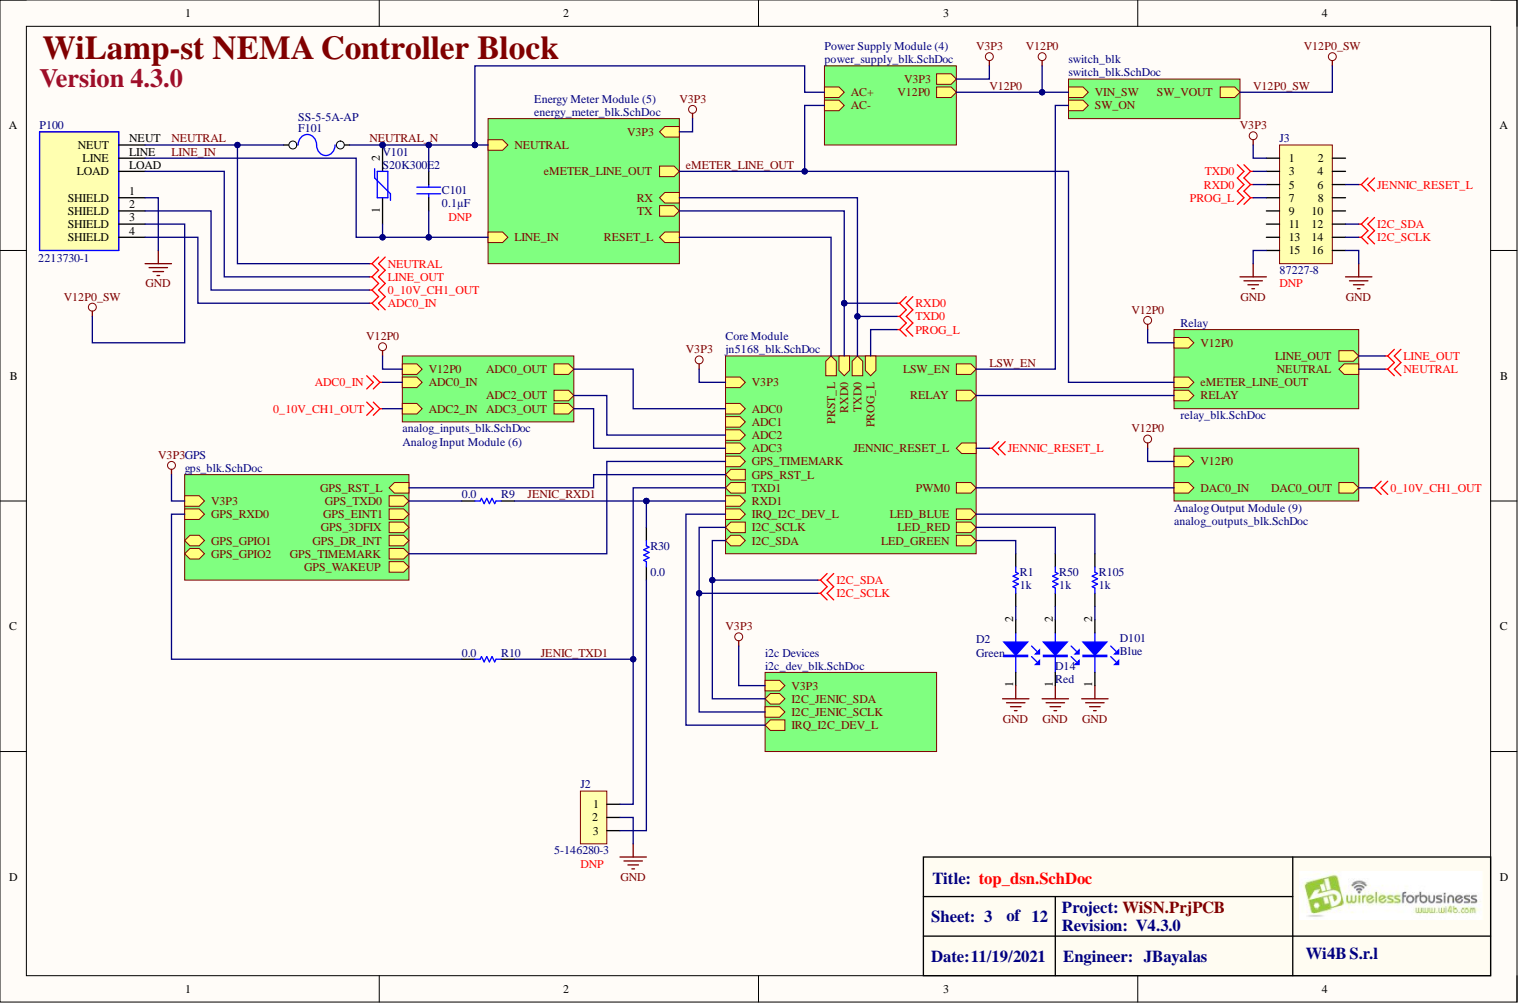
[picture p20: page 3]

RE L AY A DC0 A DC1 A DC2 A DC3 J E N N IC_RESE T_ L GPS_ T IMEMARK GPS_RST _ L T X D 1 PWM0 RX D 1

GPS_RST _ L V 3P3 GPS_ T X D 0

T itl e : top_dsn.SchD o c

o f 12 Sheet : 3 | P r oject : W iSN . PrjPC B Rev isi on: V4.3. 0

Date : 11/19/202 1 | Engineer JBayal a s | W i4BS. r. l

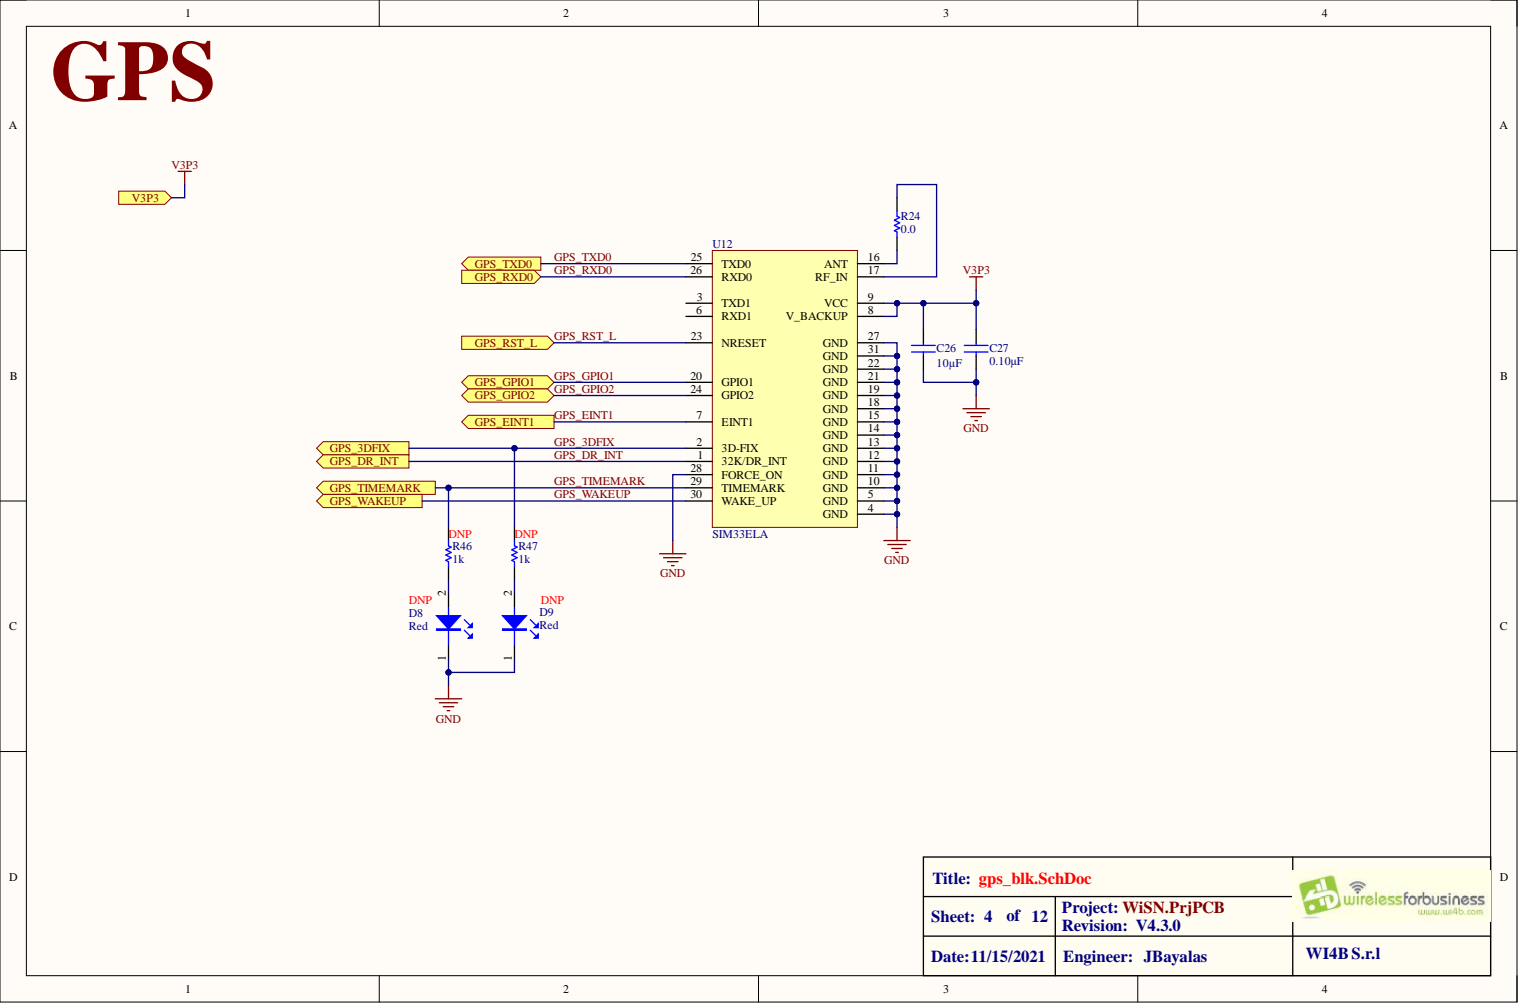
[picture p21: page 4]

T itl e : gps_bl k .SchD o c

o f 12 Sheet : 4 | P r oject : W iSN . PrjPC B V4.3. 0

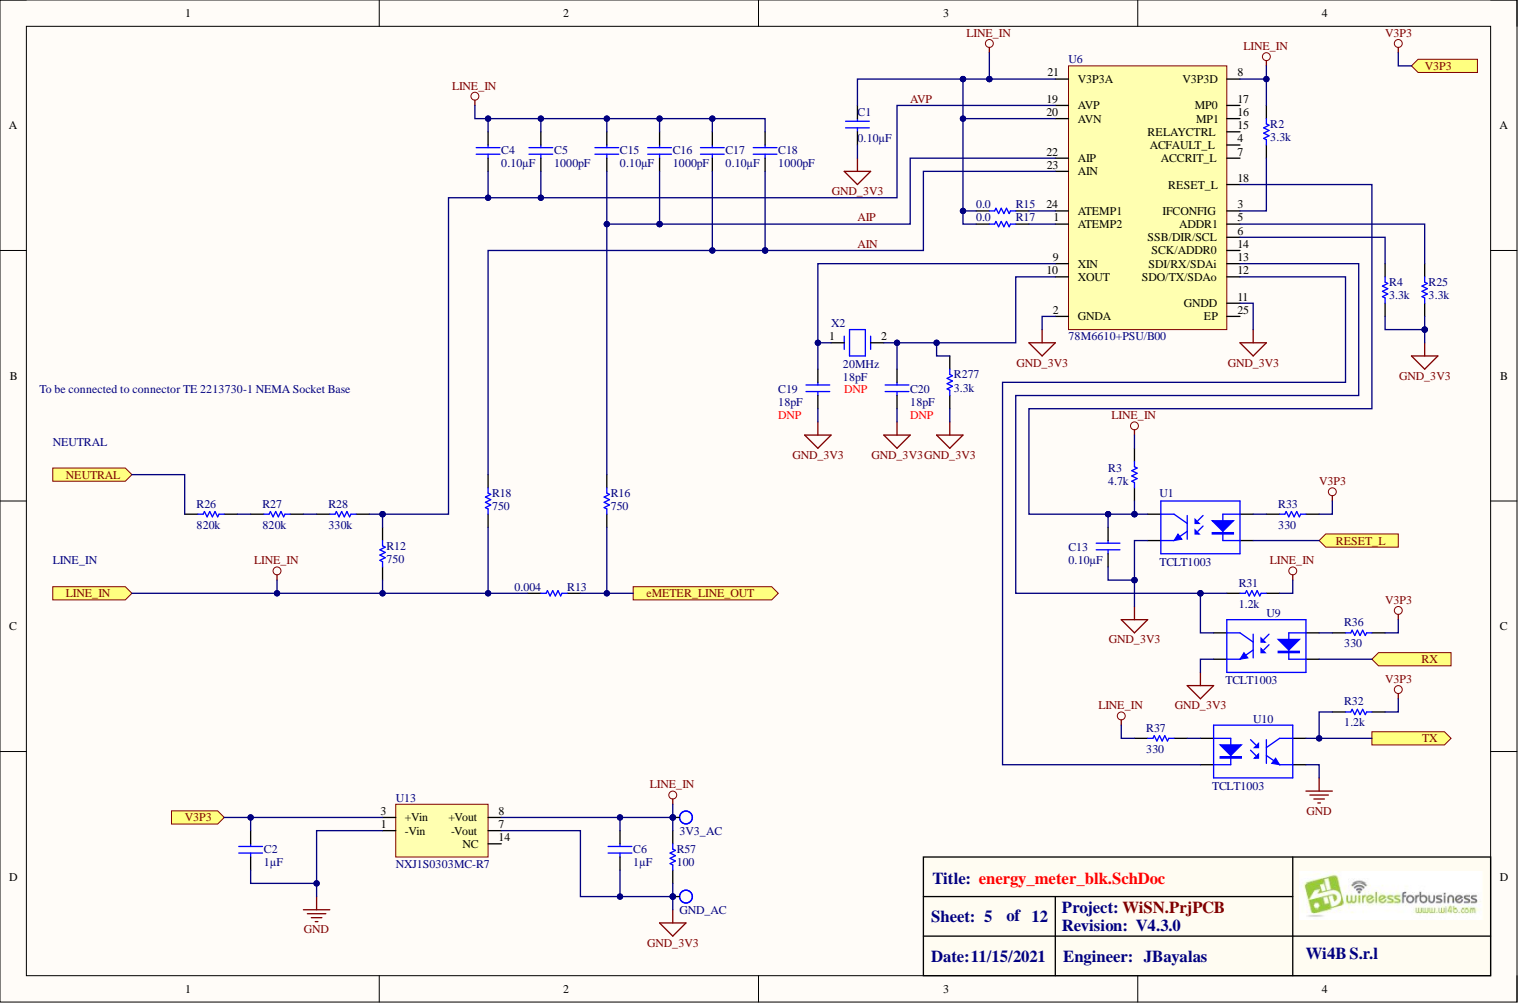
[picture p22: page 5]

AVP | | AVP 19

C1 | | | AVN 20

AIP 22

GND_3V3 | | 0.0 R15 | ATEMP1 24

AIP

To be connected to connector TE 2213730-1 NEMA Socket Base

Title: energy_meter_blk.SchDoc

Sheet: 5 of 12 | Project: WiSN.PrjPCB

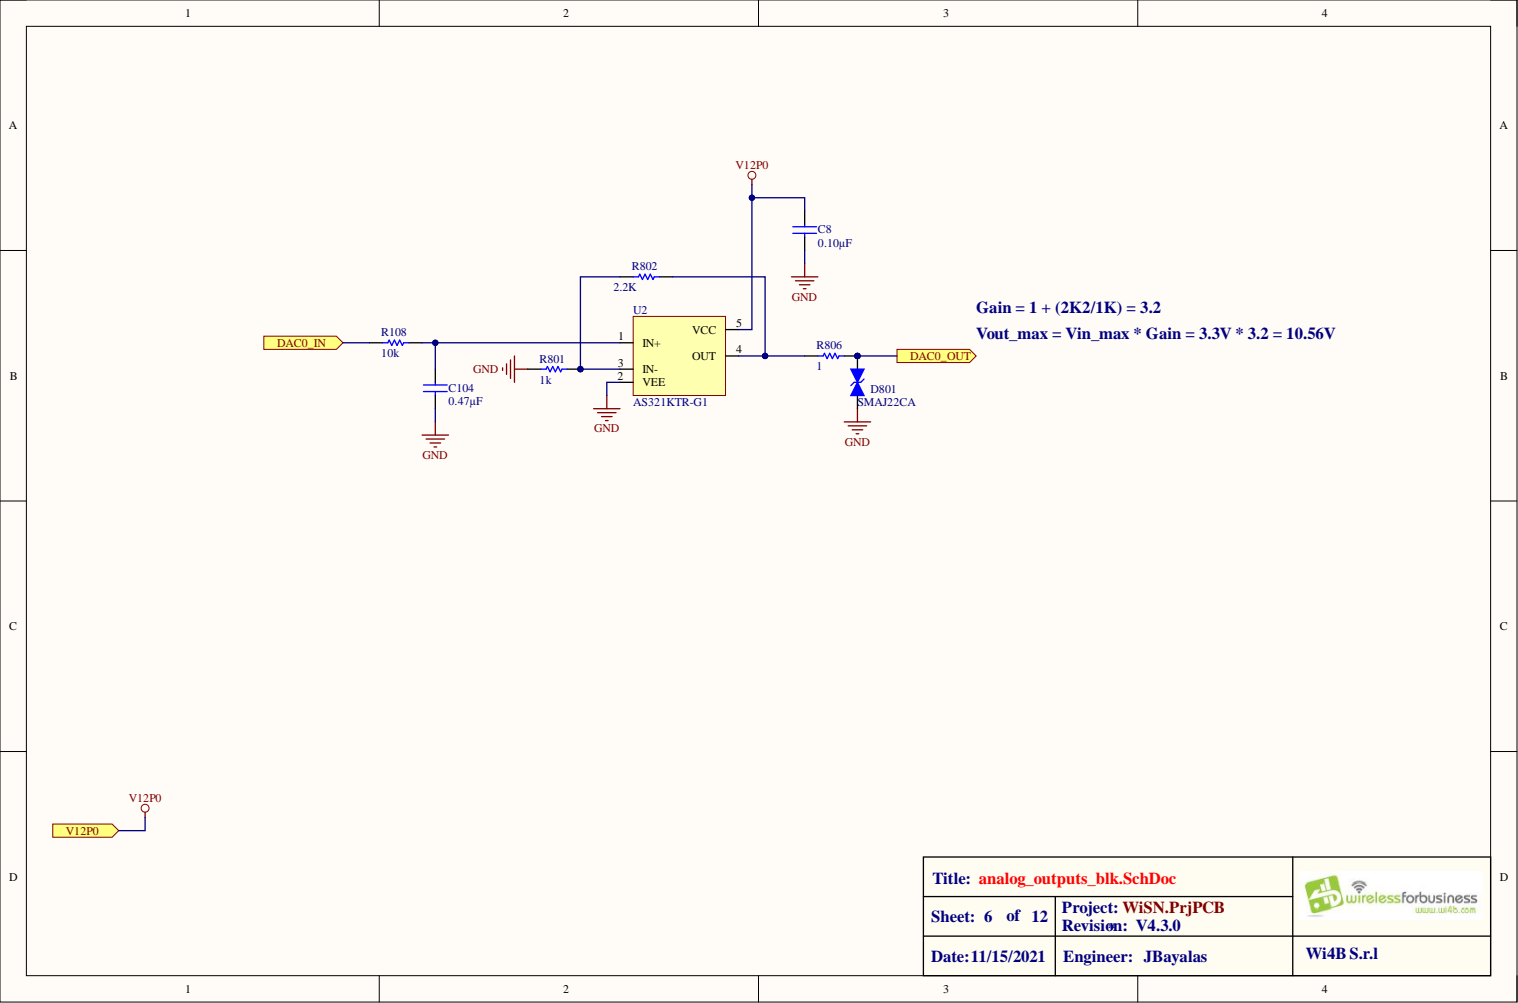
[picture p23: page 6]

Title: analog_outputs_blk.SchDoc

Sheet: 6 of 12 | Project: WiSN.PrjPCB *

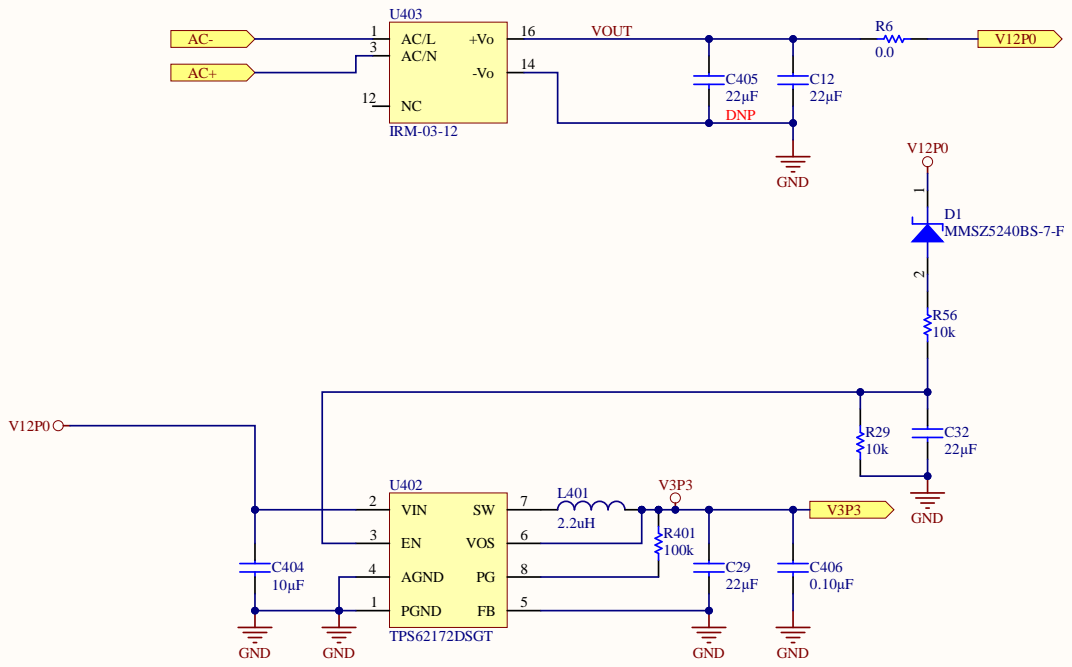
[picture p24: page 7]

AGND 4

PGND 1

Title: power_supply_blk.SchDoc

Sheet: 7 of 12 | Project: WiSN.PrjPCB

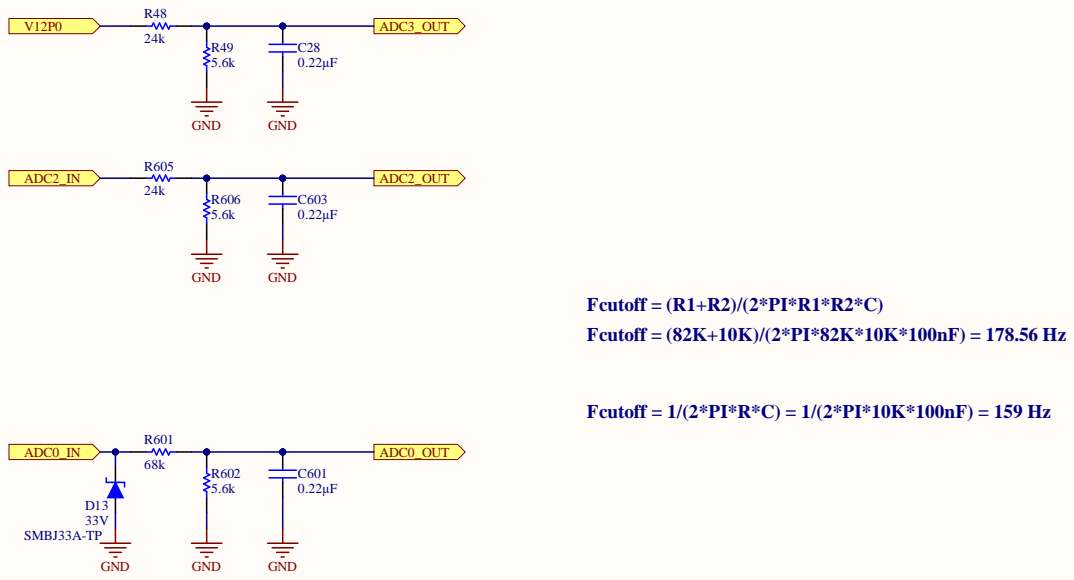
[picture p25: page 8]

Fcutoff = 1/(2*PI*R*C) = 1/(2*PI*10K*100nF) = 159 Hz

Title: analog_inputs_blk.SchDoc

Sheet: 8 of 12 | Project: WiSN.PrjPCB

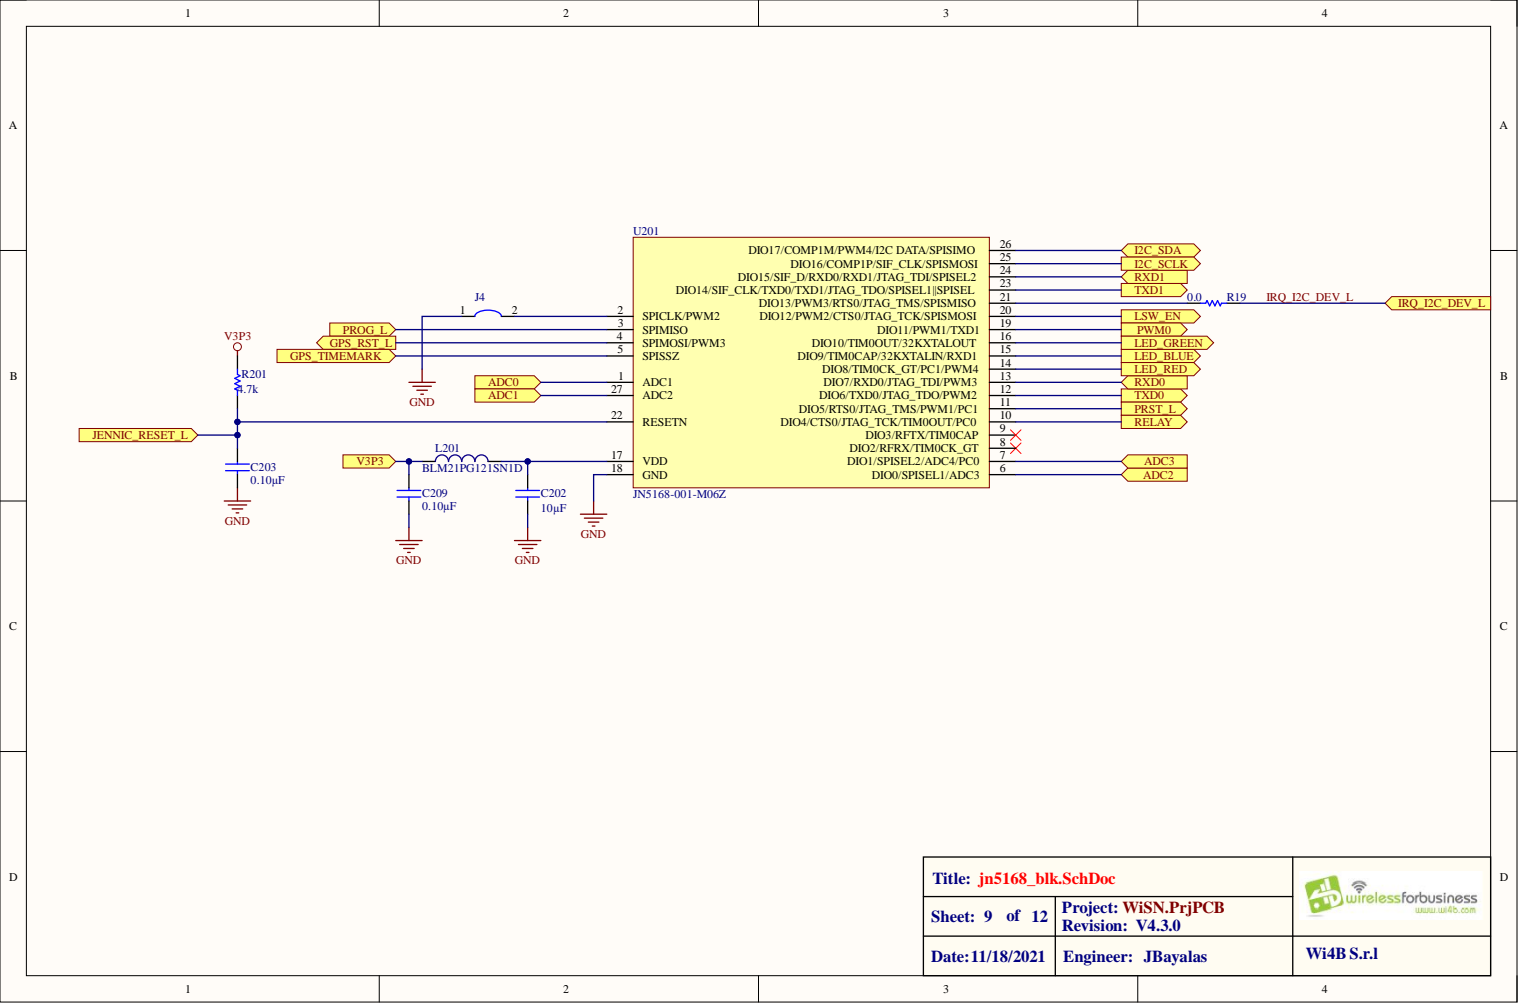
[picture p26: page 9]

T itl e : jn5168_bl k .SchD o c

o f 12 Sheet : 9 | P r oject : W iSN . PrjPC B V4.3. 0

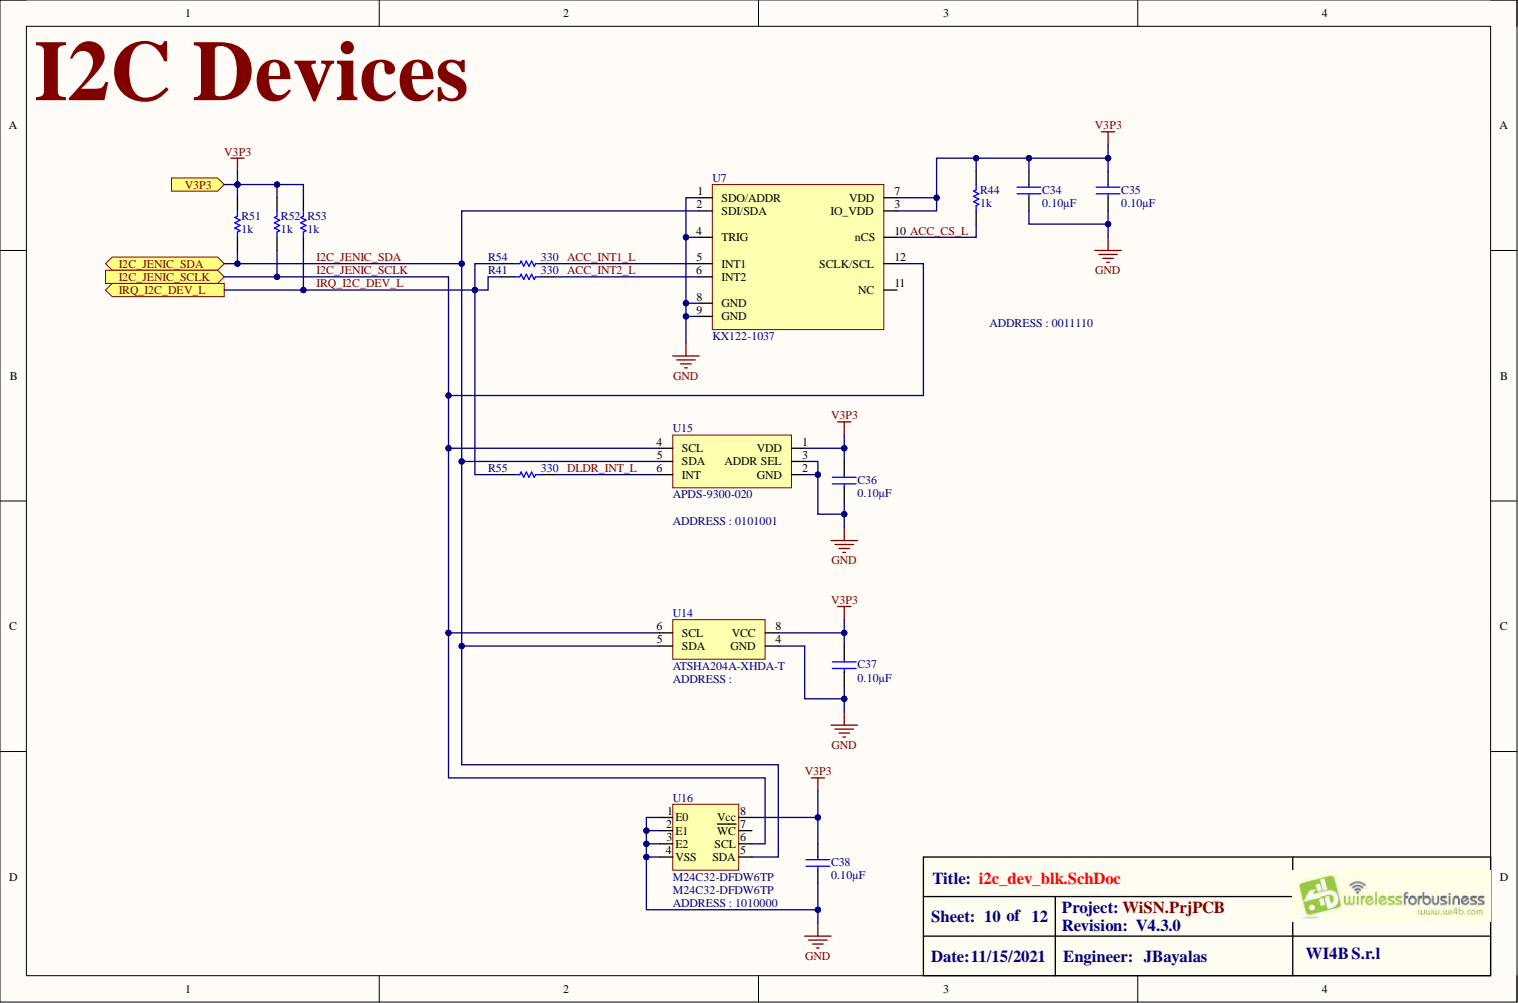
[picture p27: page 10]

R54 330 ACC_INT1_L | | TRIG 4

INT1 5

I2C_JENIC_SCLK R41 | 330 ACC_INT2_L | GND I2C_JENIC_SDA INT2 6 GND 8

GND 9

SDA 5
INT 6

Title: i2c_dev_blk.SchDoc

Sheet: 10 of 12 | Project: WiSN.PrjPCB

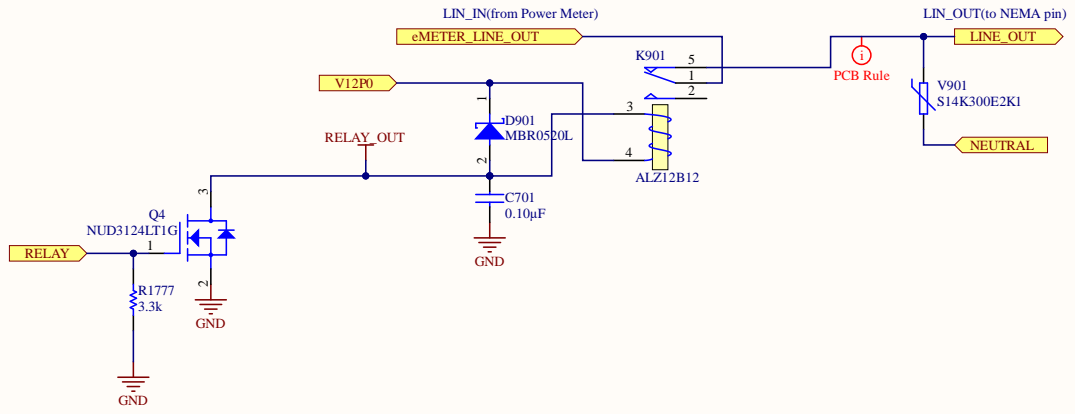
[picture p28: page 11]

T itl e : relay_bl k .SchD o c

o f 12 Sheet : 1 1 | P r oject : W iSN . PrjPC B V4.3. 0

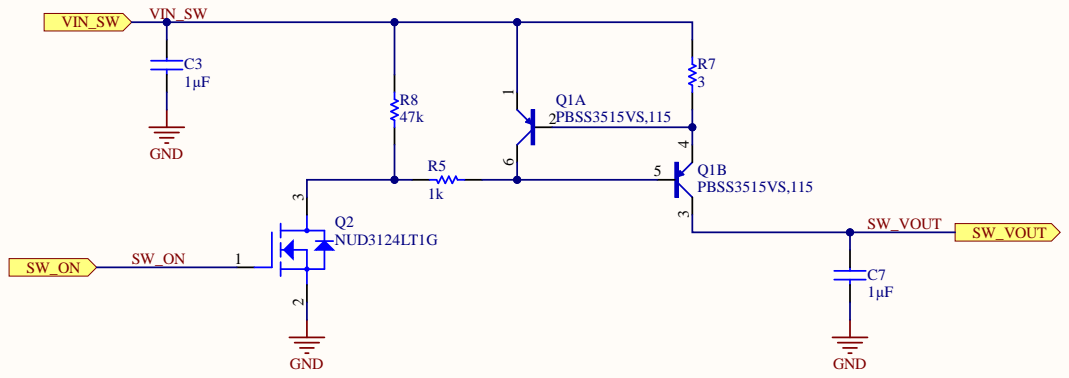
[picture p29: page 12]

T itl e : sw itch_bl k .SchD o c

o f 12 Sheet : 12 | P r oject : W iSN . PrjPC B V1.
