lbalucos/Wi4B_WiSN_5.0/WiSN v5.0.0/mech/3D wisn_v4.3.0.pdf

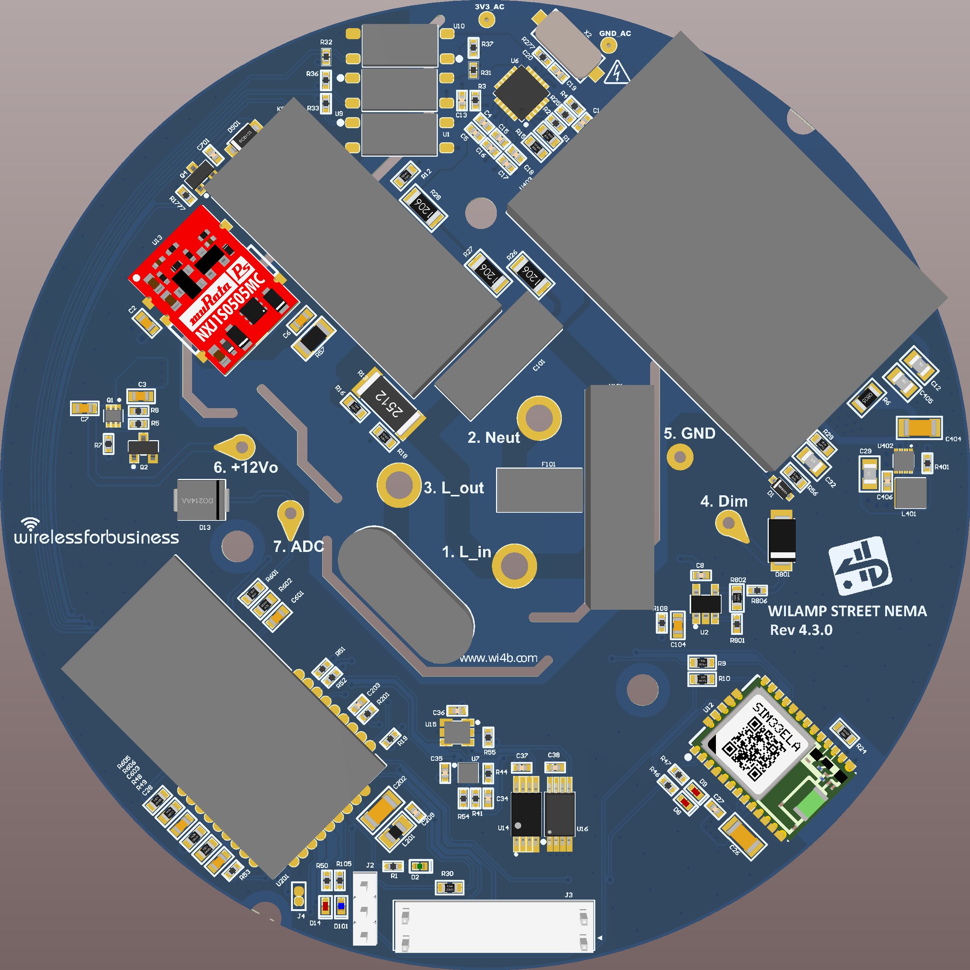
[picture p30: page 1]

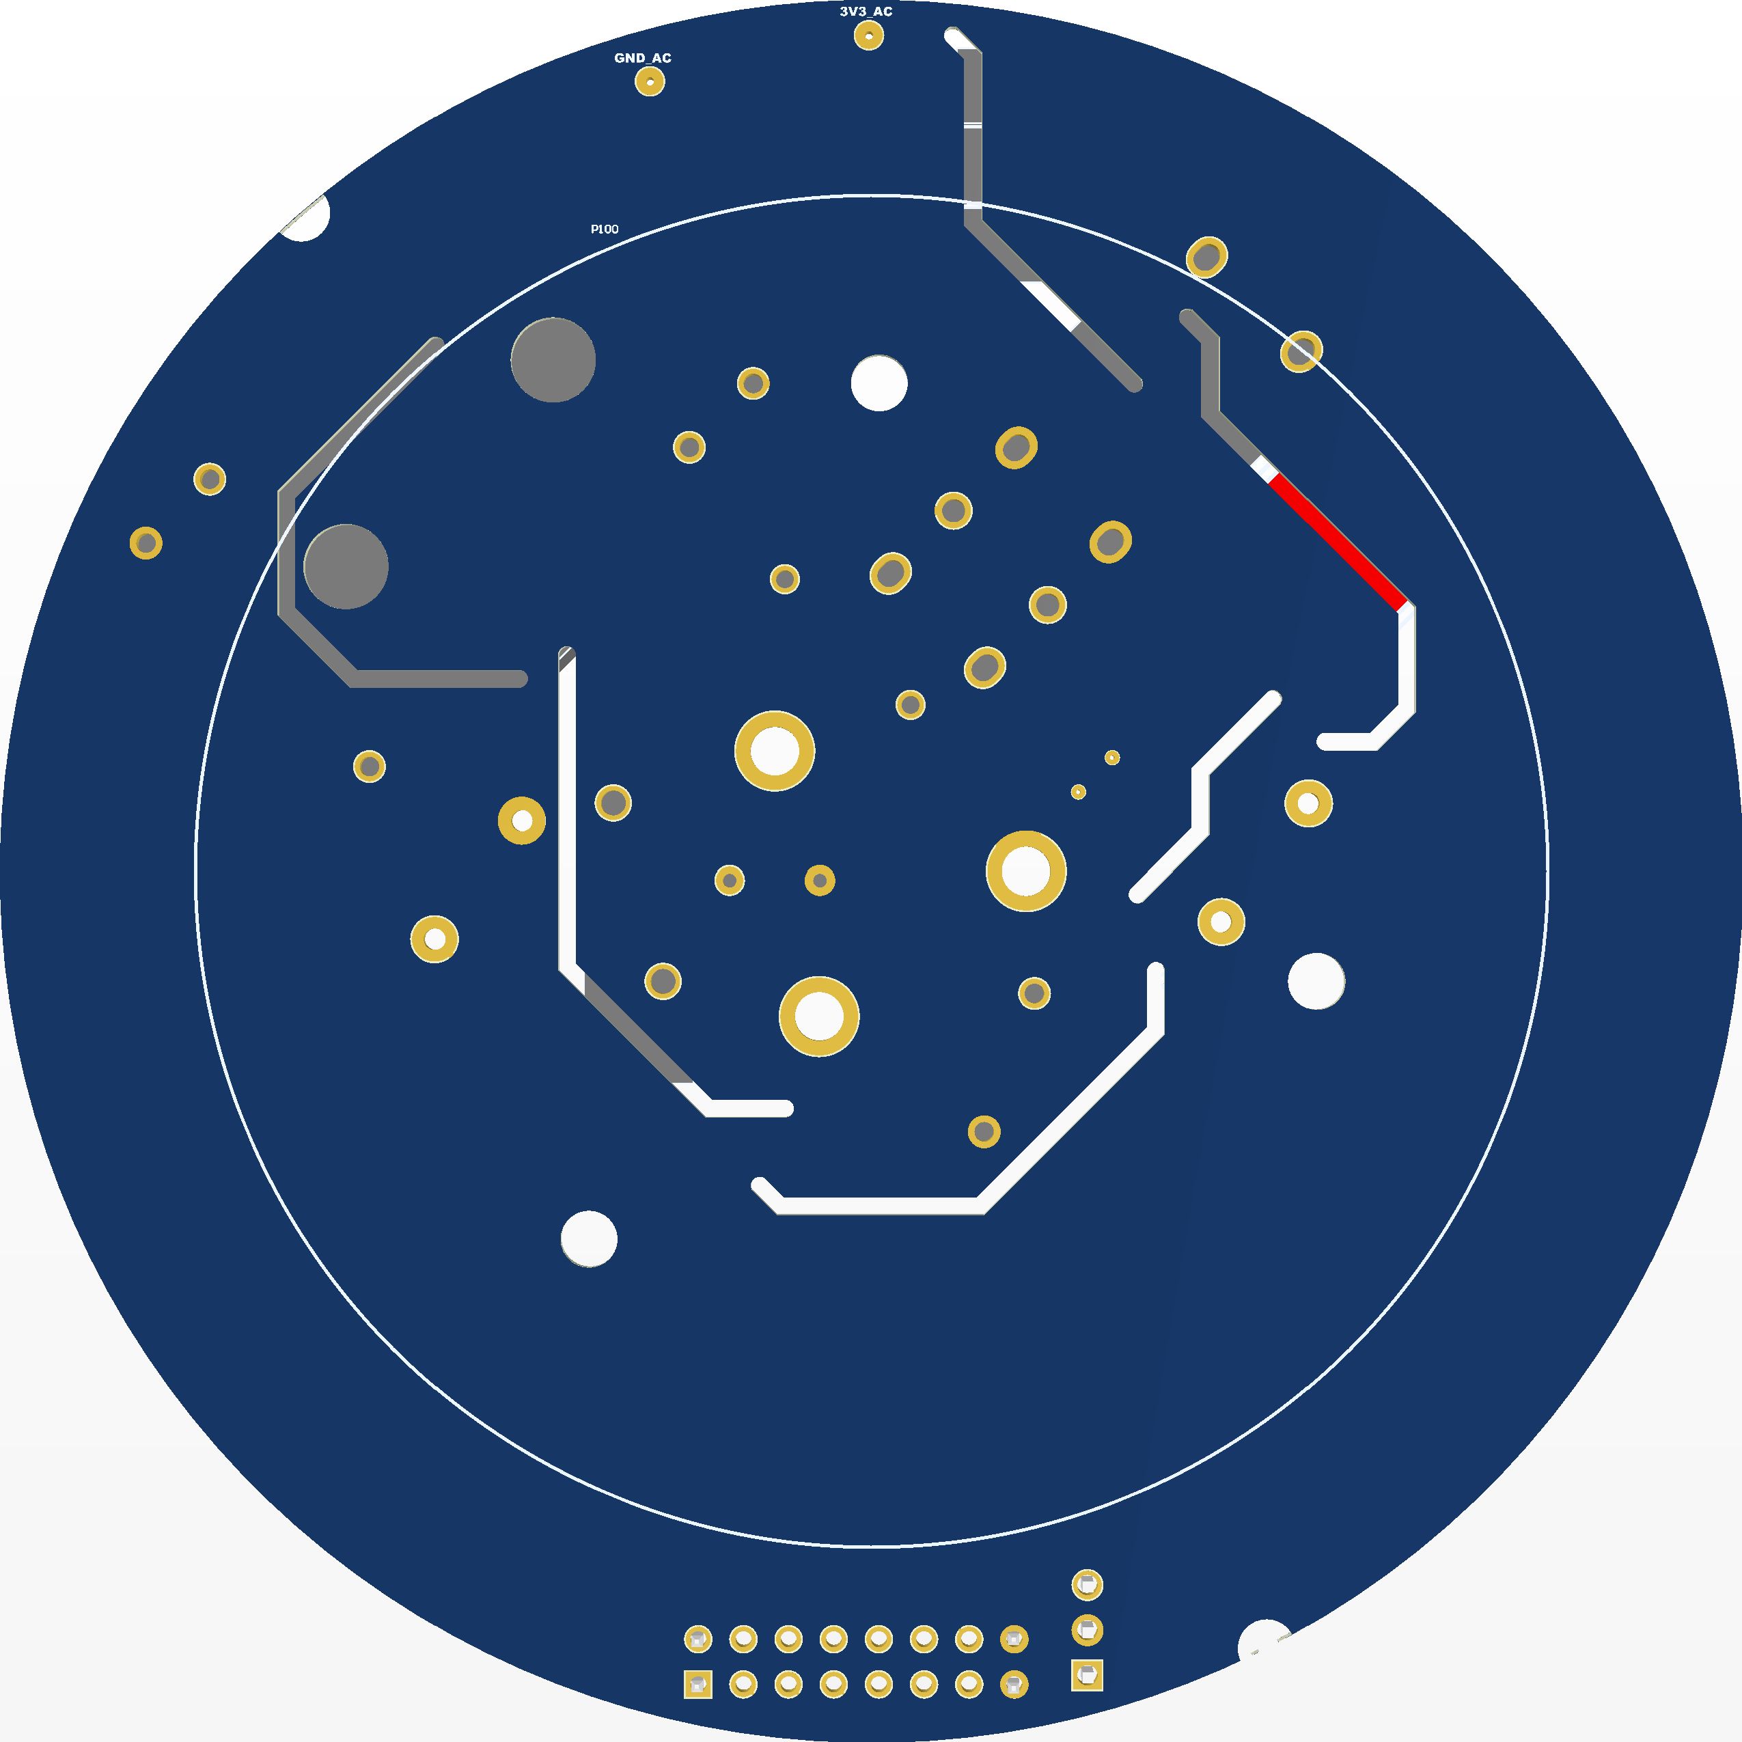
[picture p31: page 2]
