lbalucos/Wi4B_WiSN_5.0/WiSN v5.0.0/mech/Mech wisn_v4.3.0.pdf

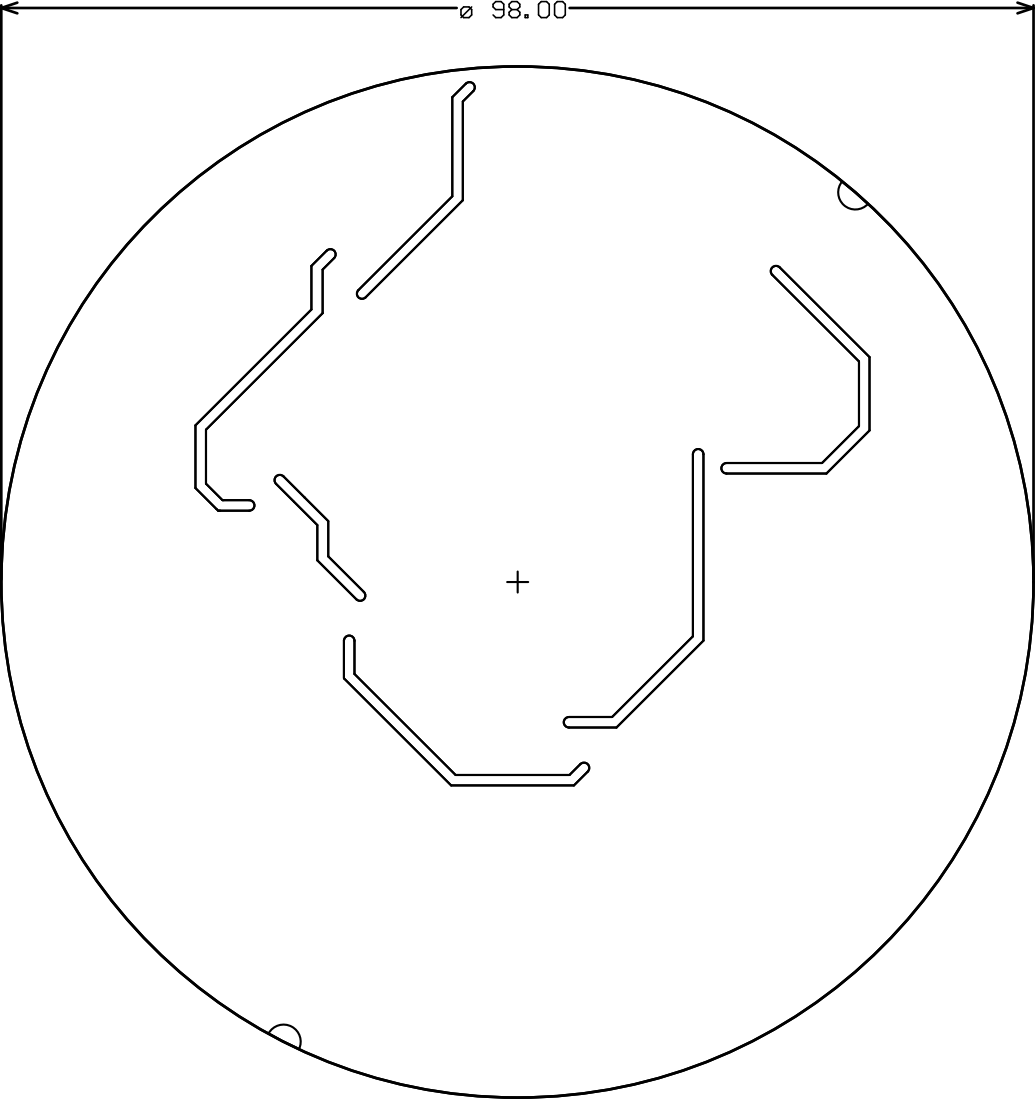
[picture p32: page 1]
