lbalucos/Wi4B_WiSN_5.0/WiSN v5.0.0/mft/Gerber.pdf

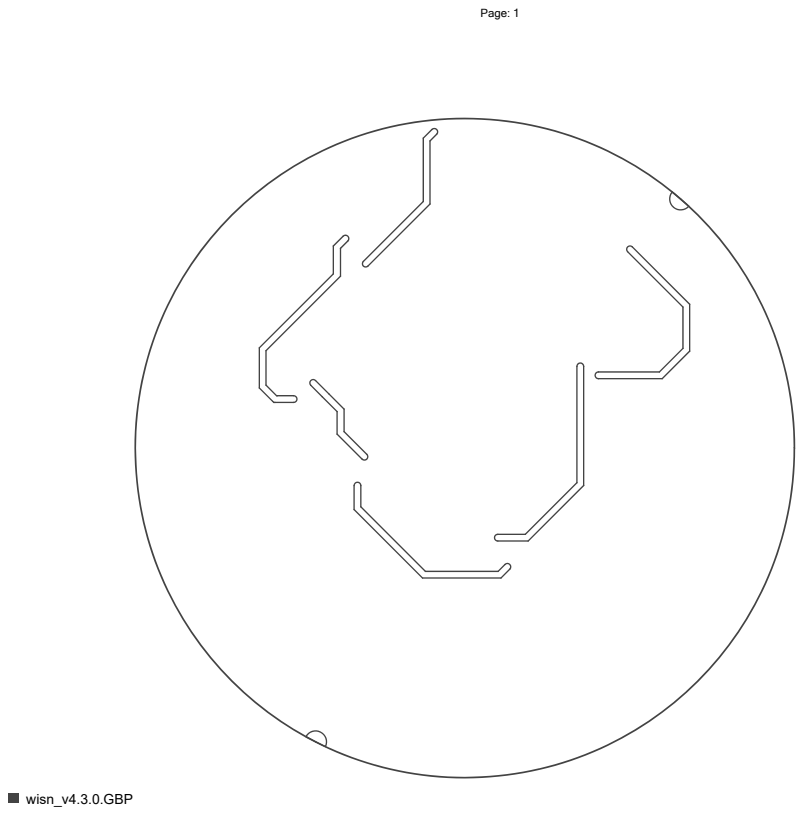
[picture p33: page 1]
wisn_v4.3.0.GBP

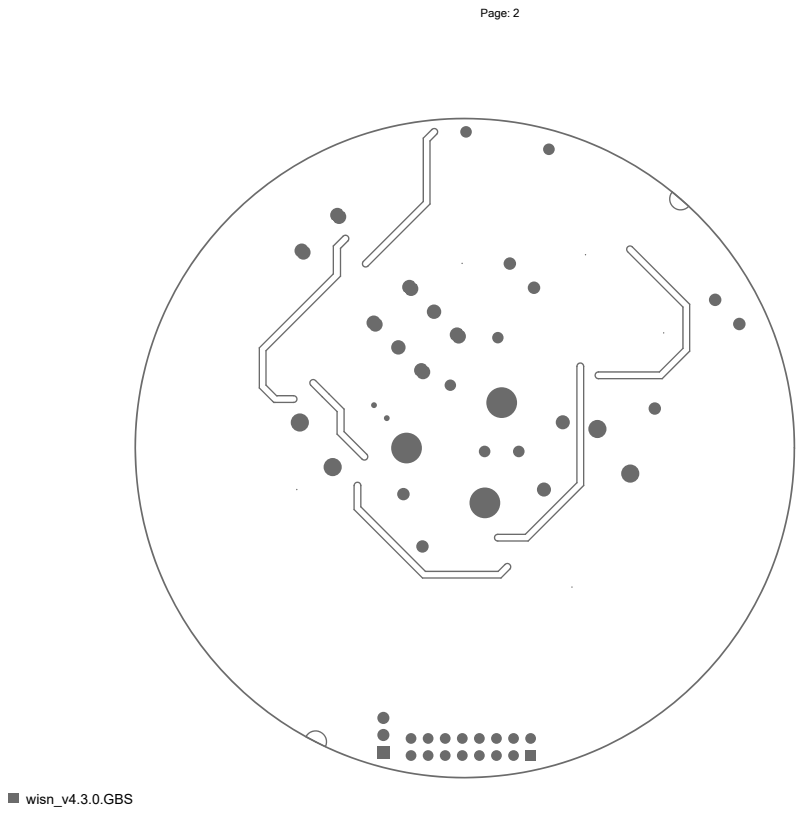
[picture p34: page 2]
wisn_v4.3.0.GBS

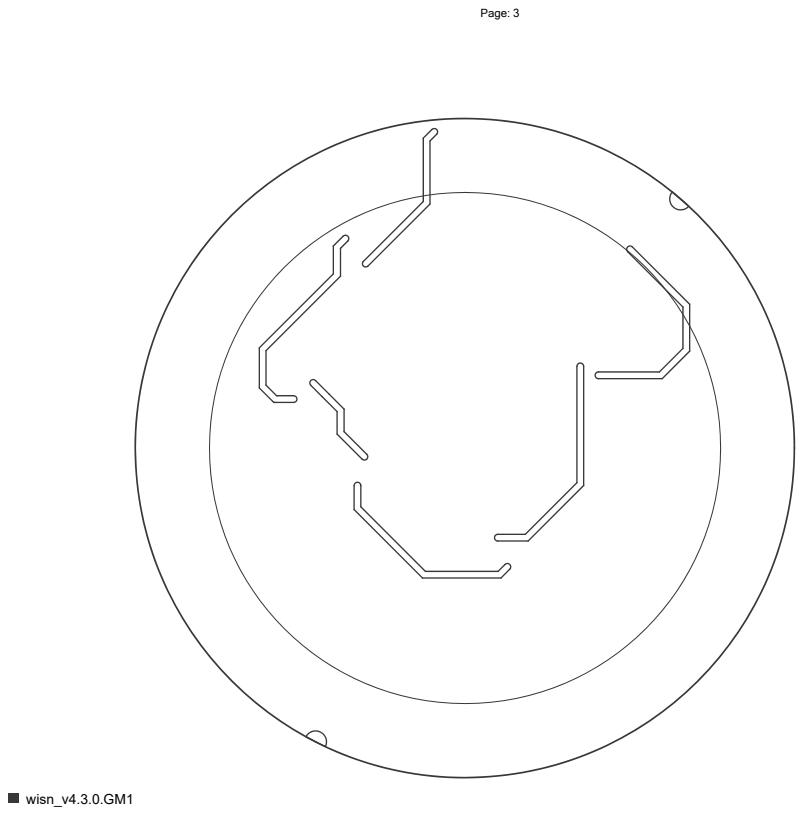
[picture p35: page 3]
wisn_v4.3.0.GM1

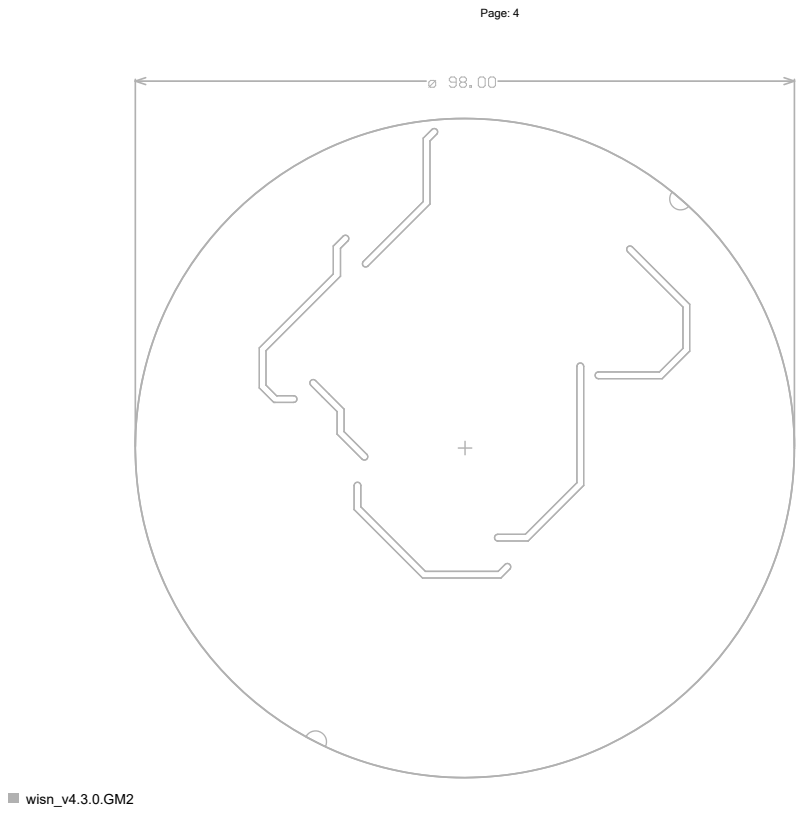
[picture p36: page 4]
wisn_v4.3.0.GM2

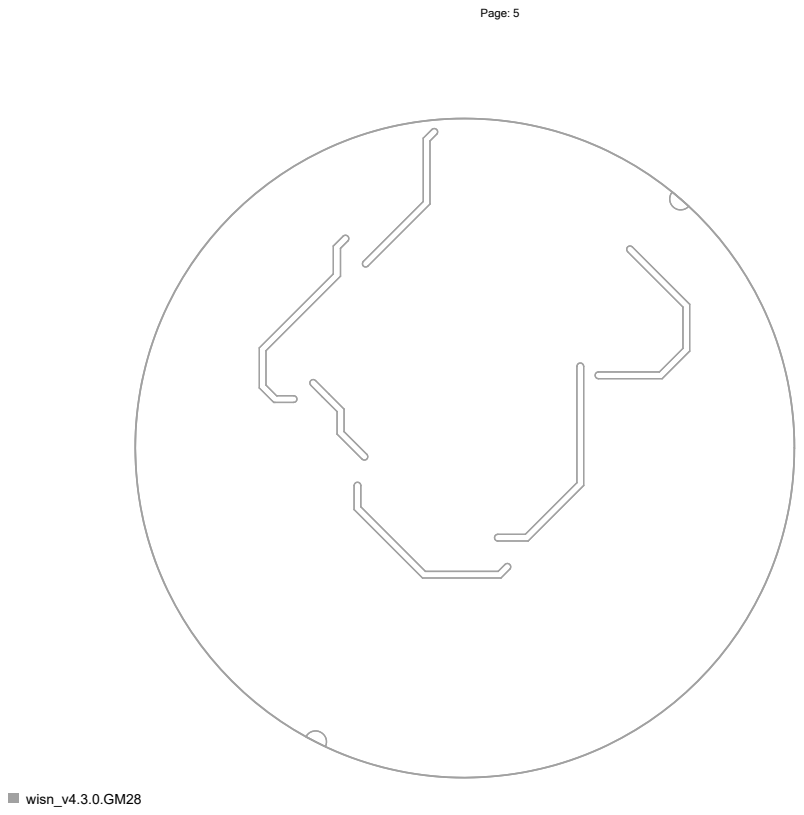
[picture p37: page 5]
wisn_v4.3.0.GM28

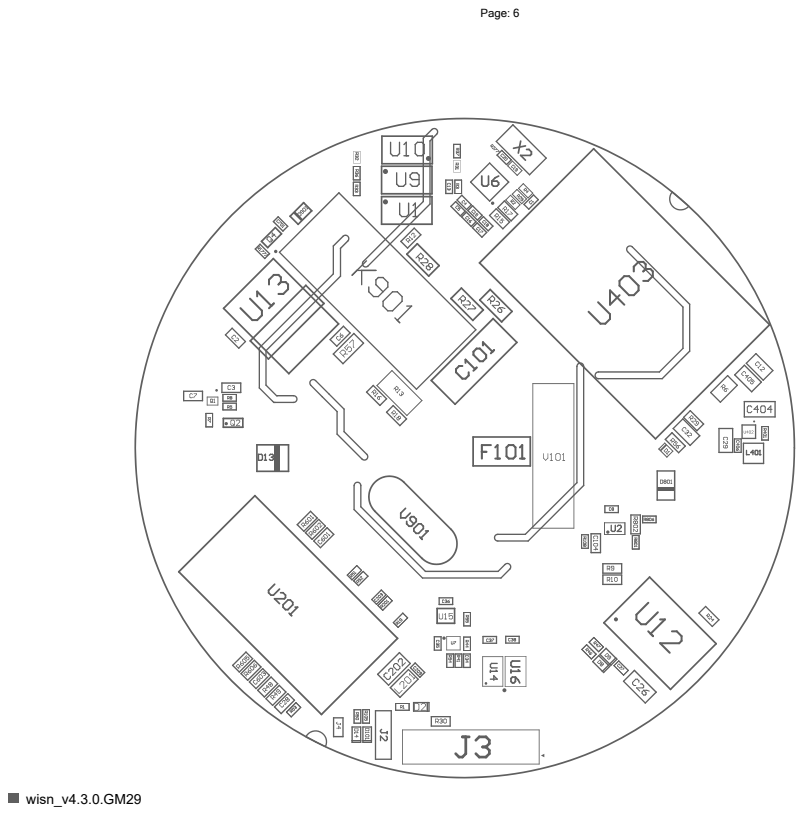
[picture p38: page 6]
wisn_v4.3.0.GM29

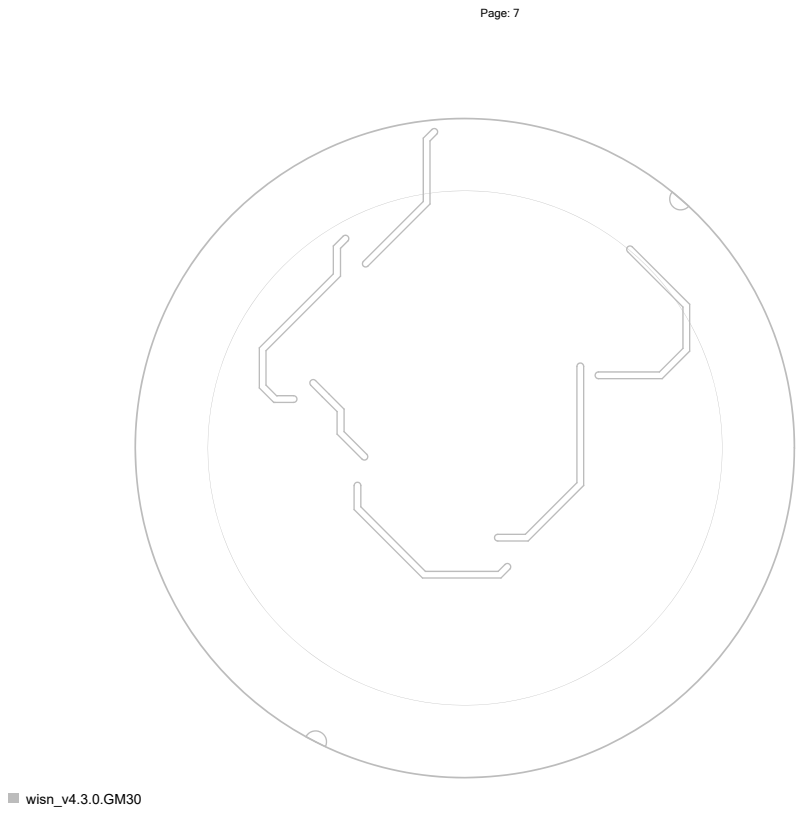
[picture p39: page 7]
wisn_v4.3.0.GM30

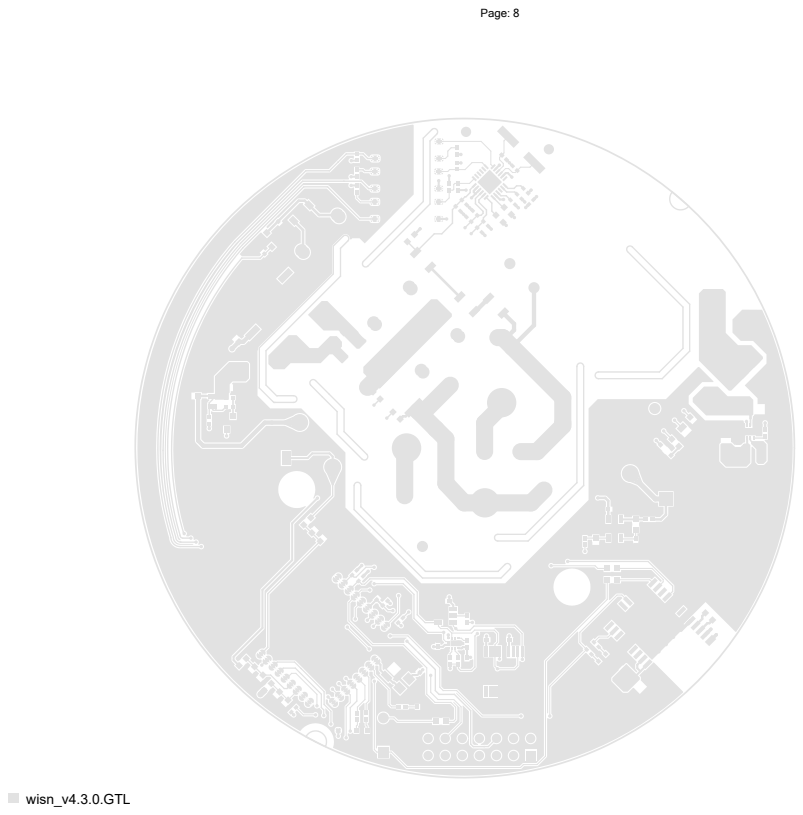
[picture p40: page 8]
wisn_v4.3.0.GTL

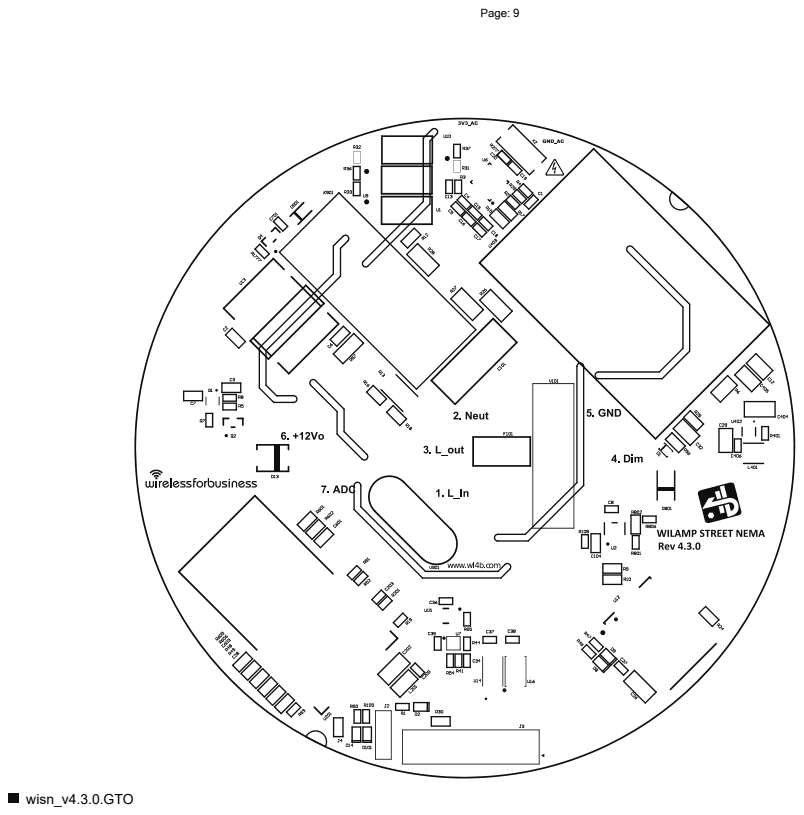
[picture p41: page 9]
wisn_v4.3.0.GTO

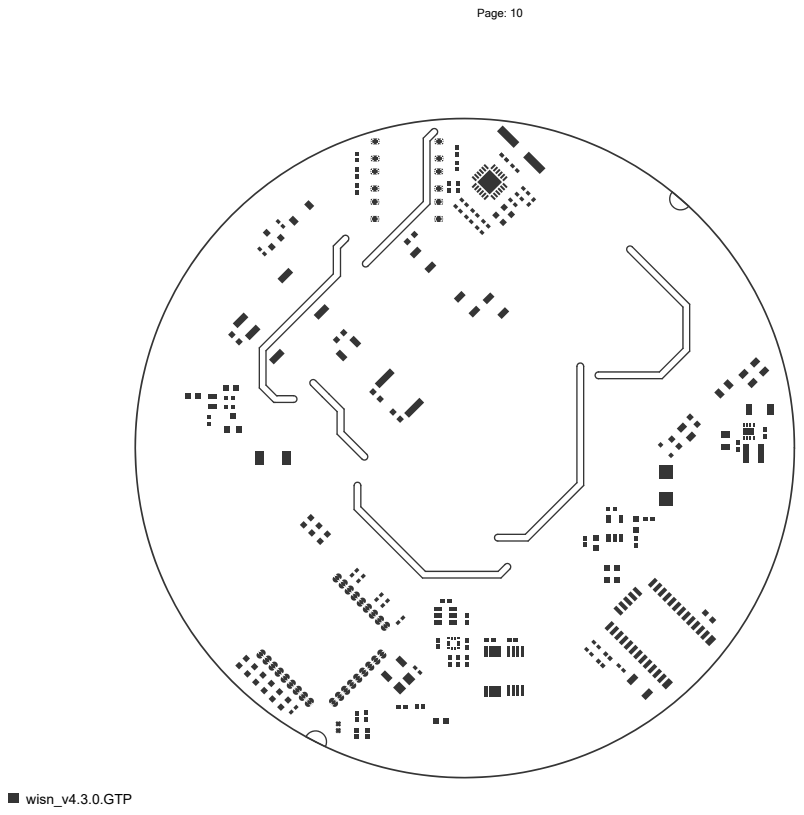
[picture p42: page 10]
wisn_v4.3.0.GTP

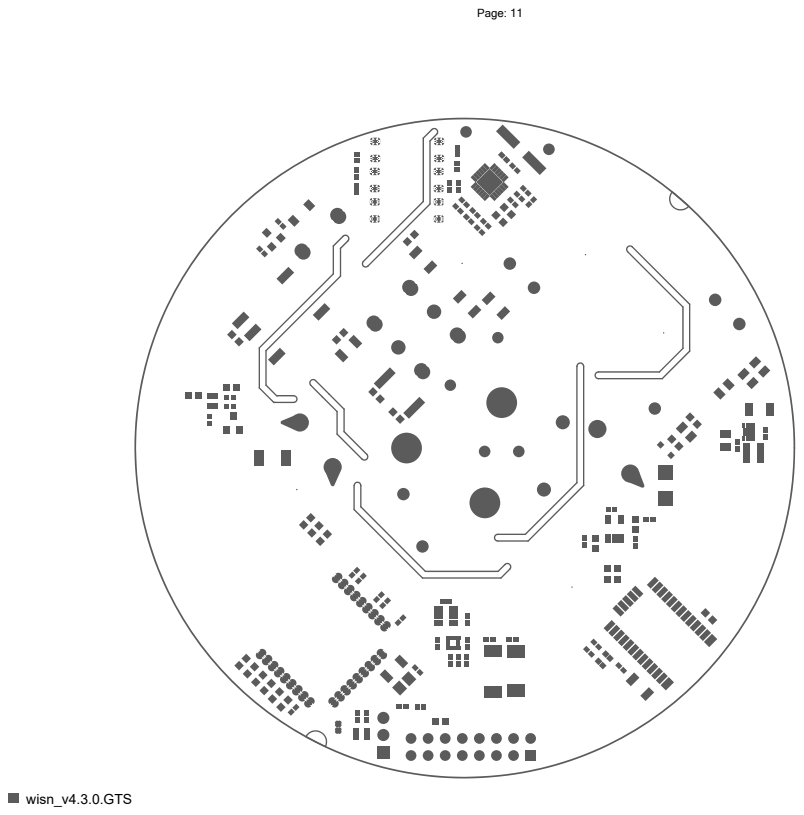
[picture p43: page 11]
wisn_v4.3.0.GTS

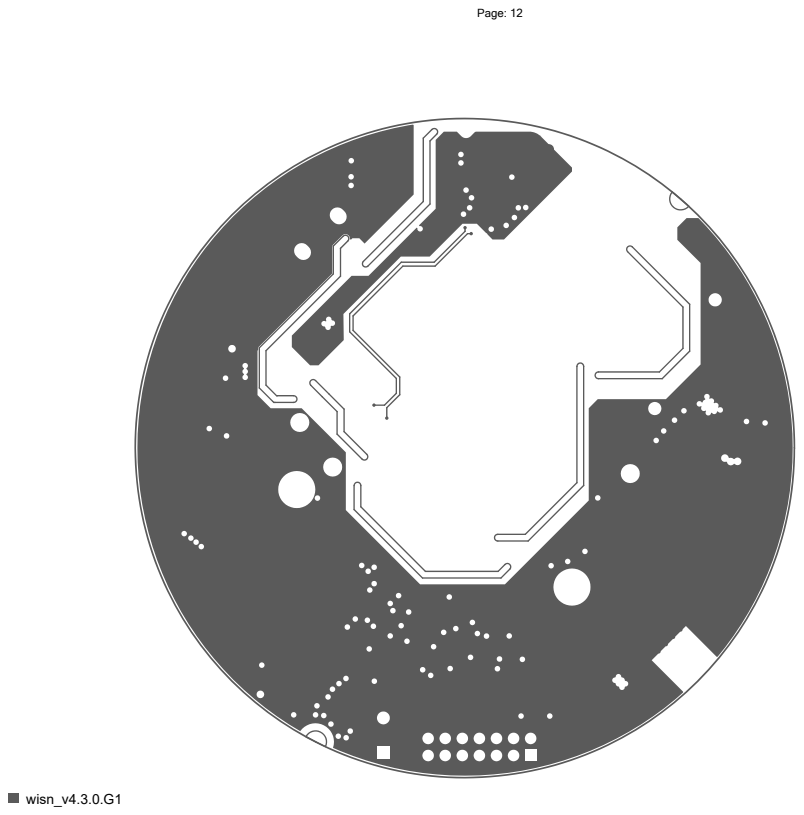
[picture p44: page 12]
wisn_v4.3.0.G1

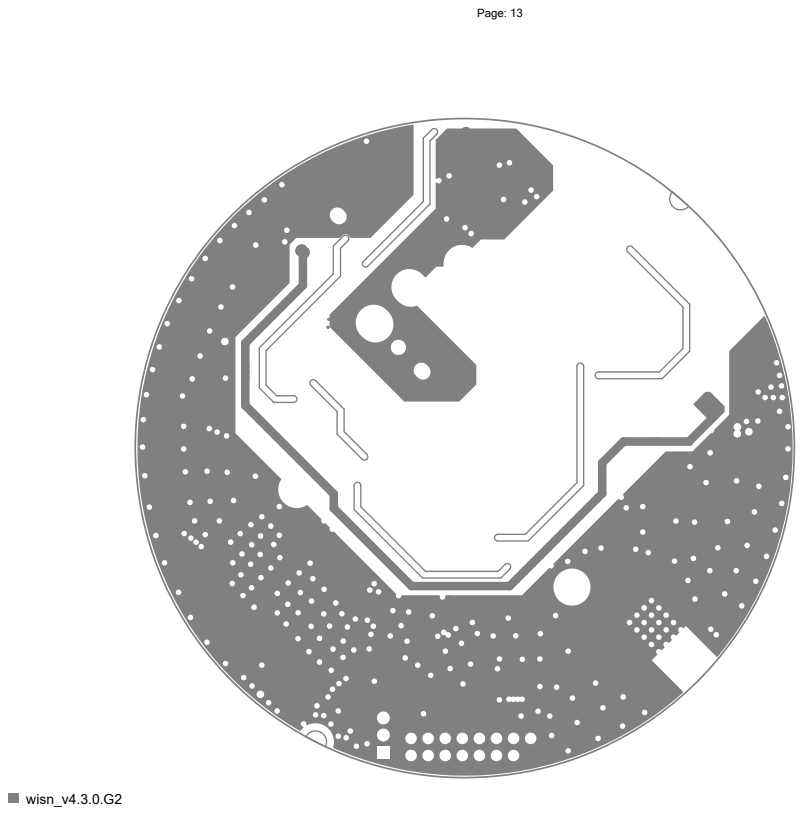
[picture p45: page 13]
wisn_v4.3.0.G2

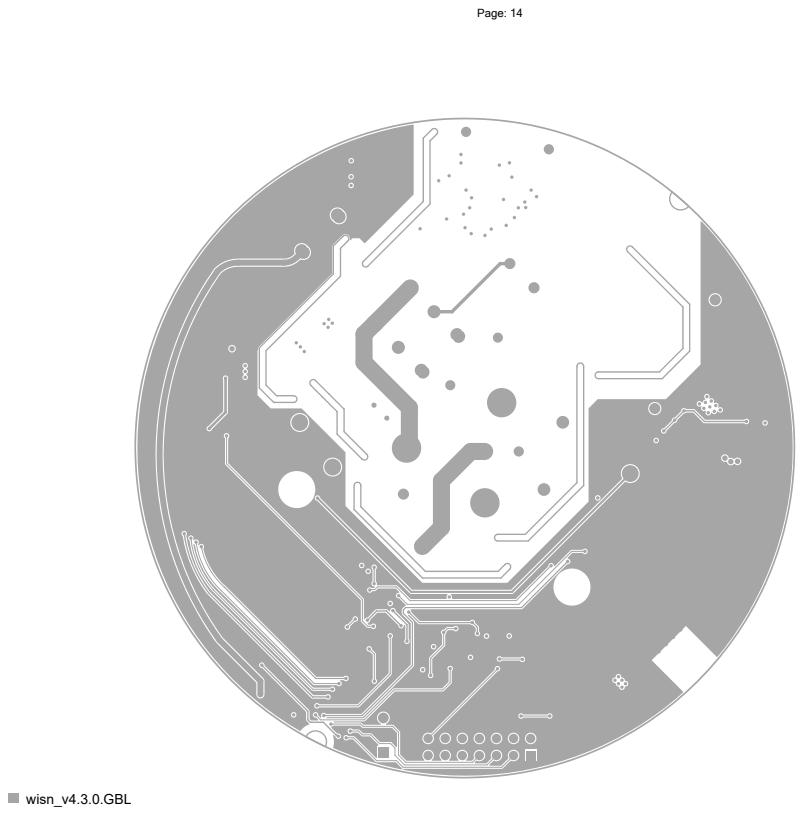
[picture p46: page 14]
wisn_v4.3.0.GBL

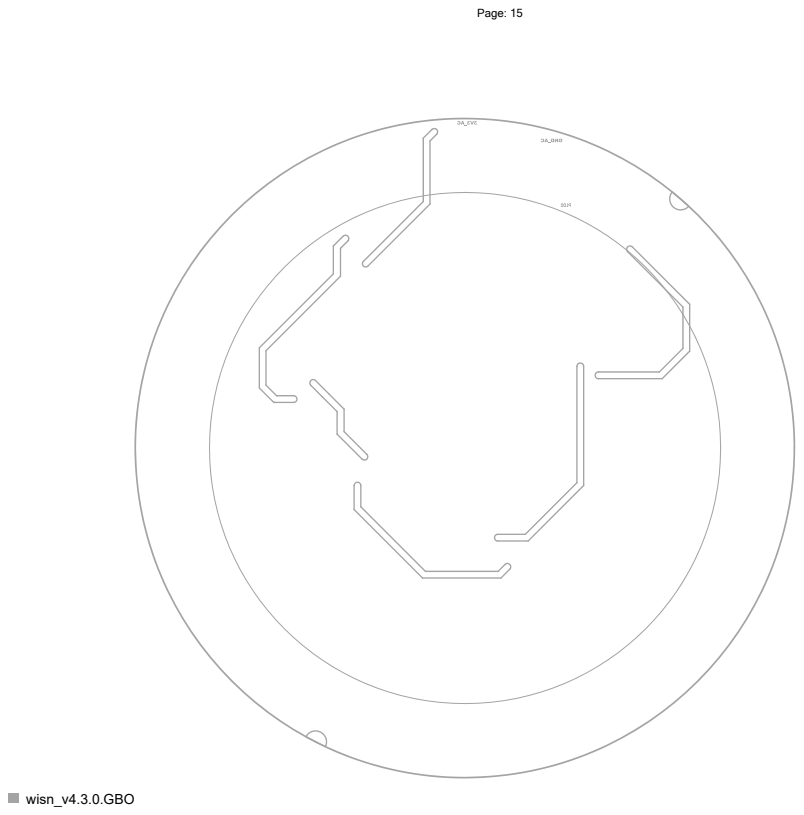
[picture p47: page 15]
wisn_v4.3.0.GBO

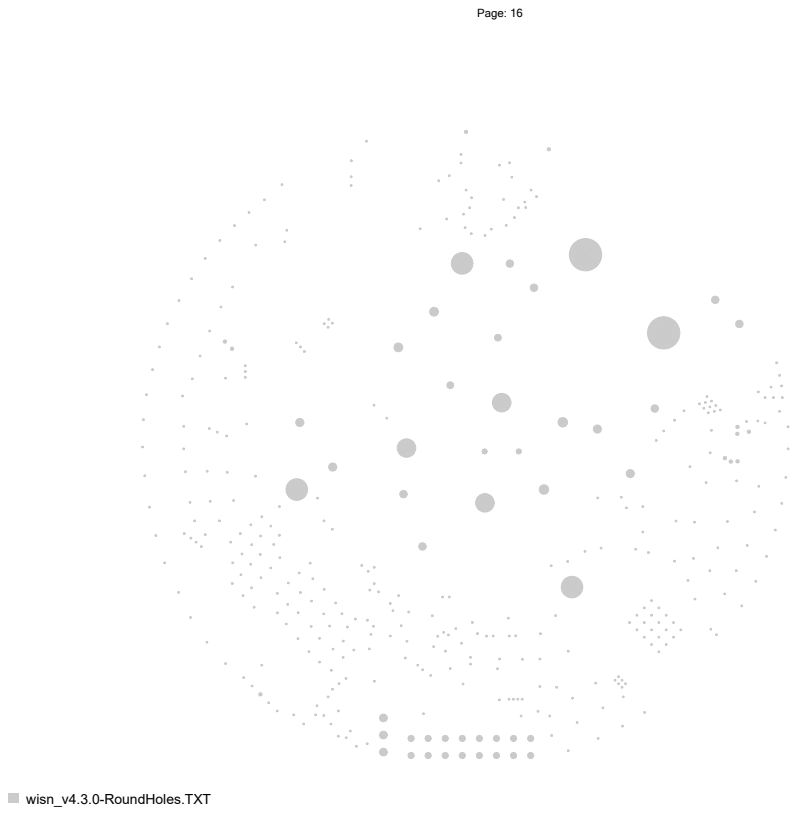
[picture p48: page 16]
wisn_v4.3.0-RoundHoles.TXT
