lbalucos/Wi4B_WiSN_5.0/WiCL v1.0_rls_20201028/WiCL v1.0/mech/3D wicl_v1.0.pdf

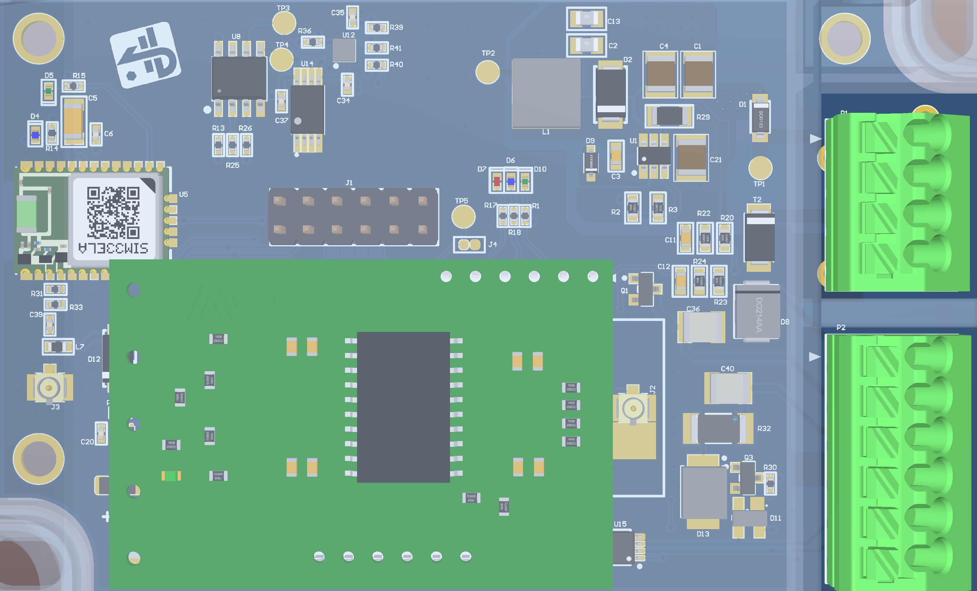
[picture p49: page 1]

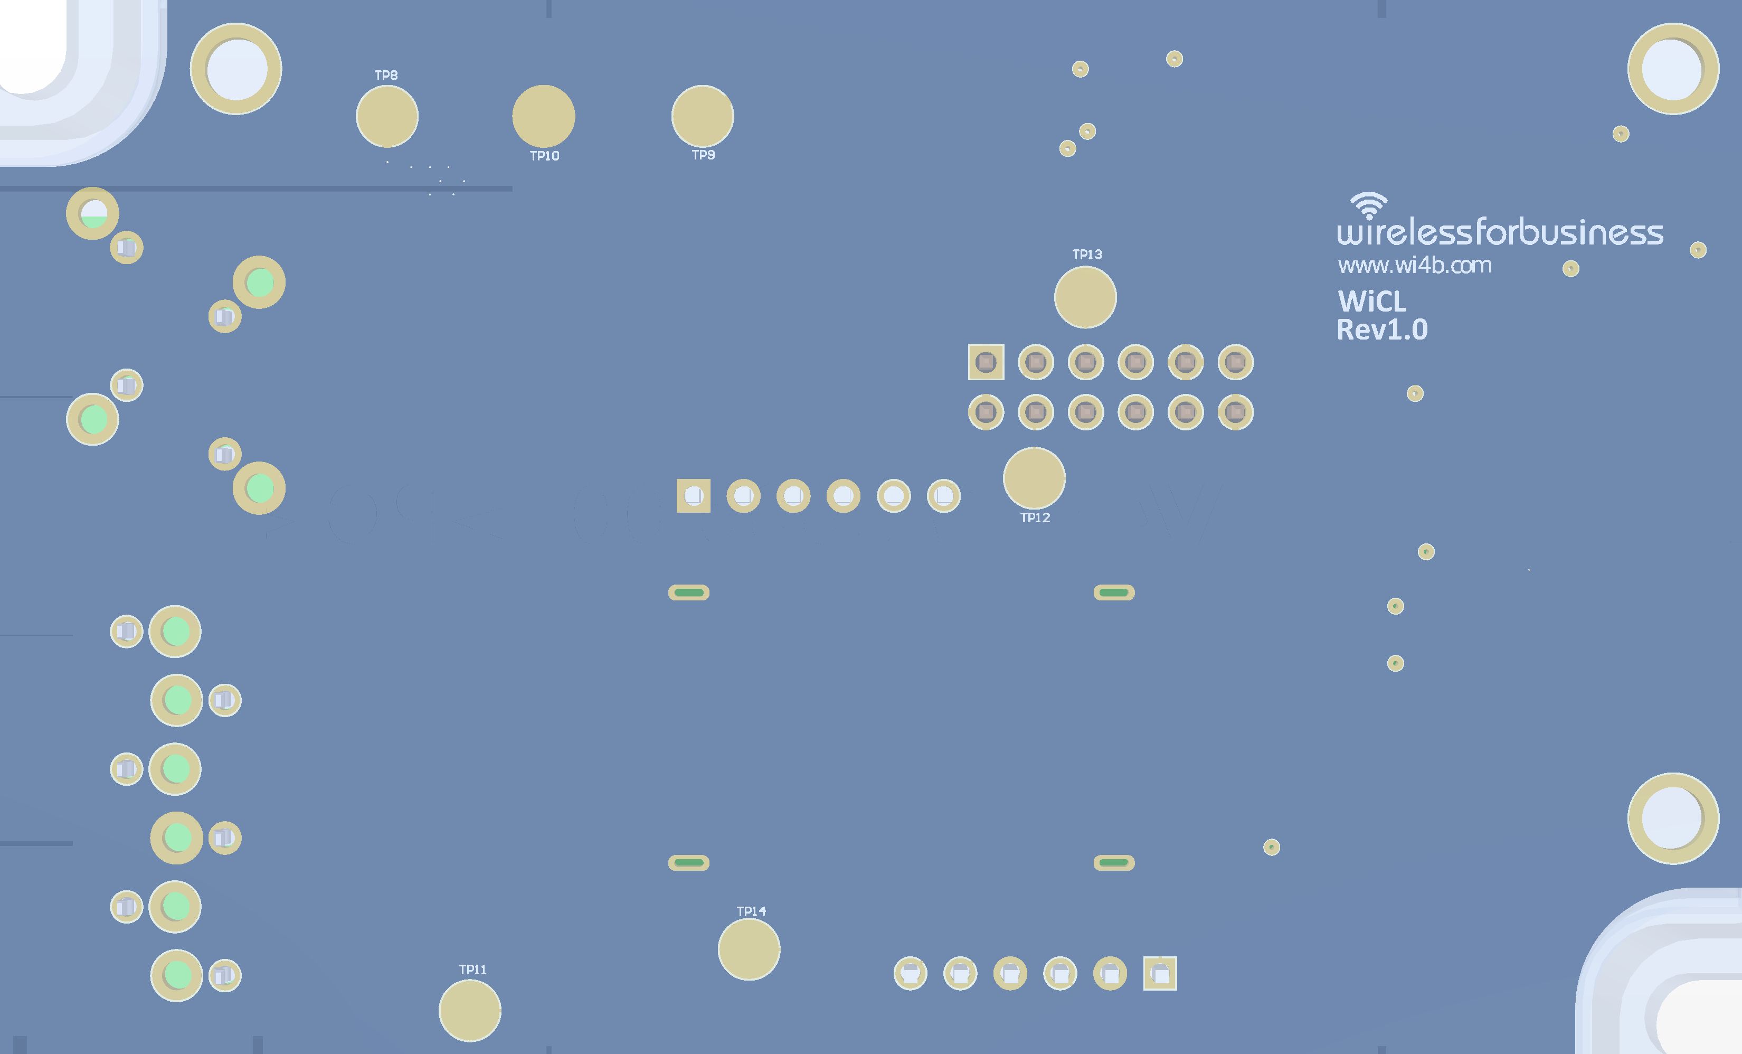
[picture p50: page 2]
