lbalucos/Wi4B_WiSN_5.0/WiCL v1.0_rls_20201028/WiCL v1.0/mech/Mech wicl_v1.0.pdf

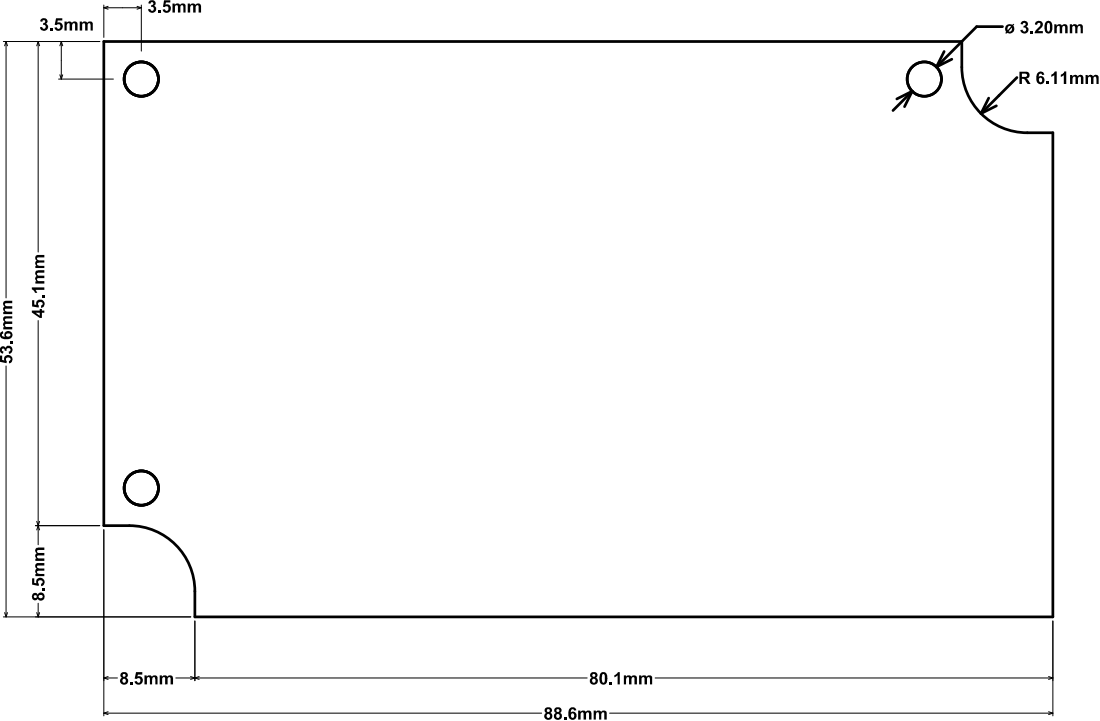
[picture p51: page 1]
