lbalucos/Wi4B_WiSN_5.0/WiSN v5.0.0/mft/pca/Assm wisn_v4.3.0.pdf

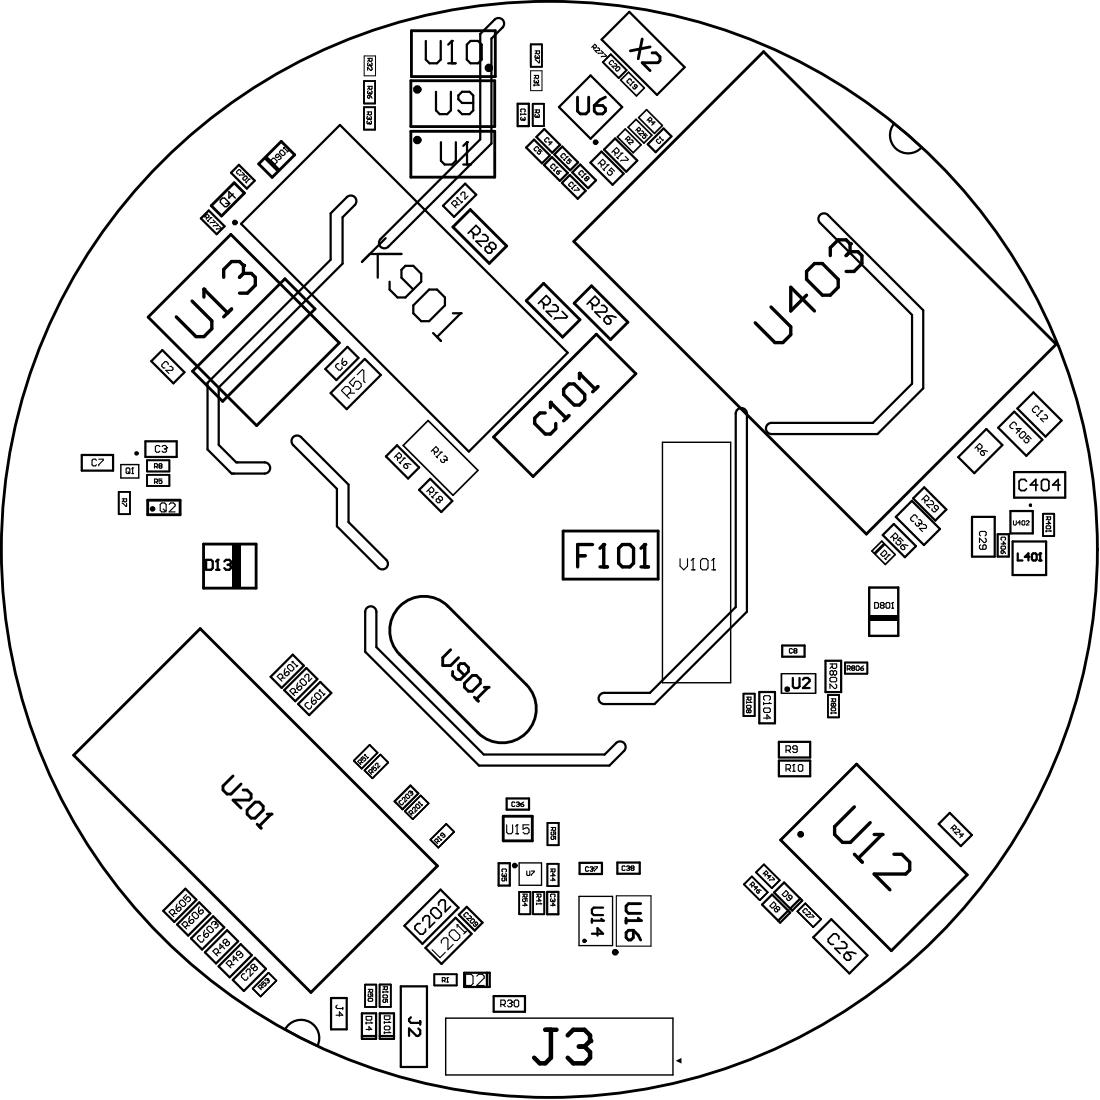
[picture p52: page 1]

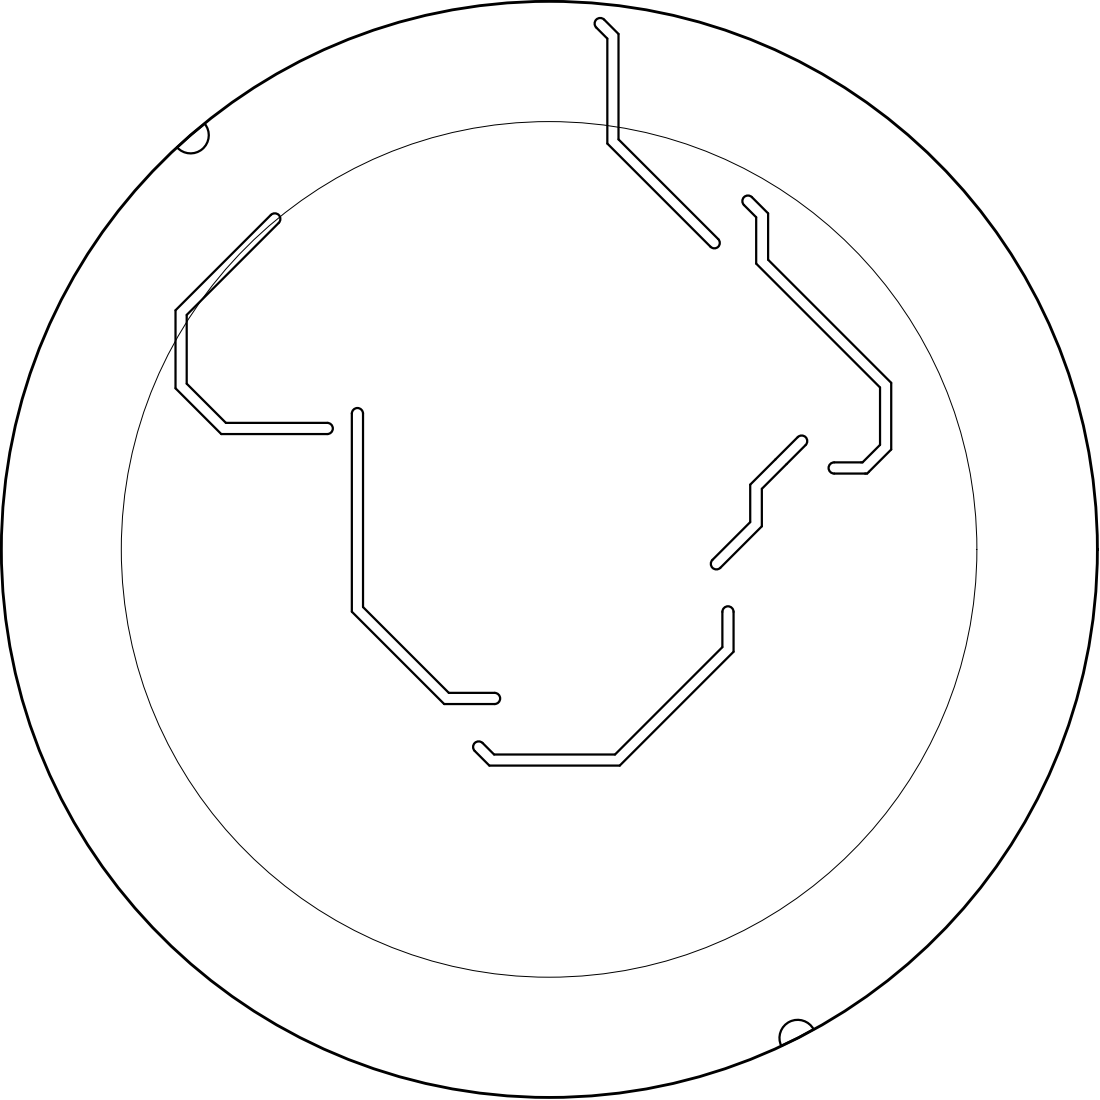
[picture p53: page 2]
