lbalucos/Wi4B_WiSN_5.0/WiSN v5.0.0/mft/pca/LibCheck wisn_v4.3.0.pdf

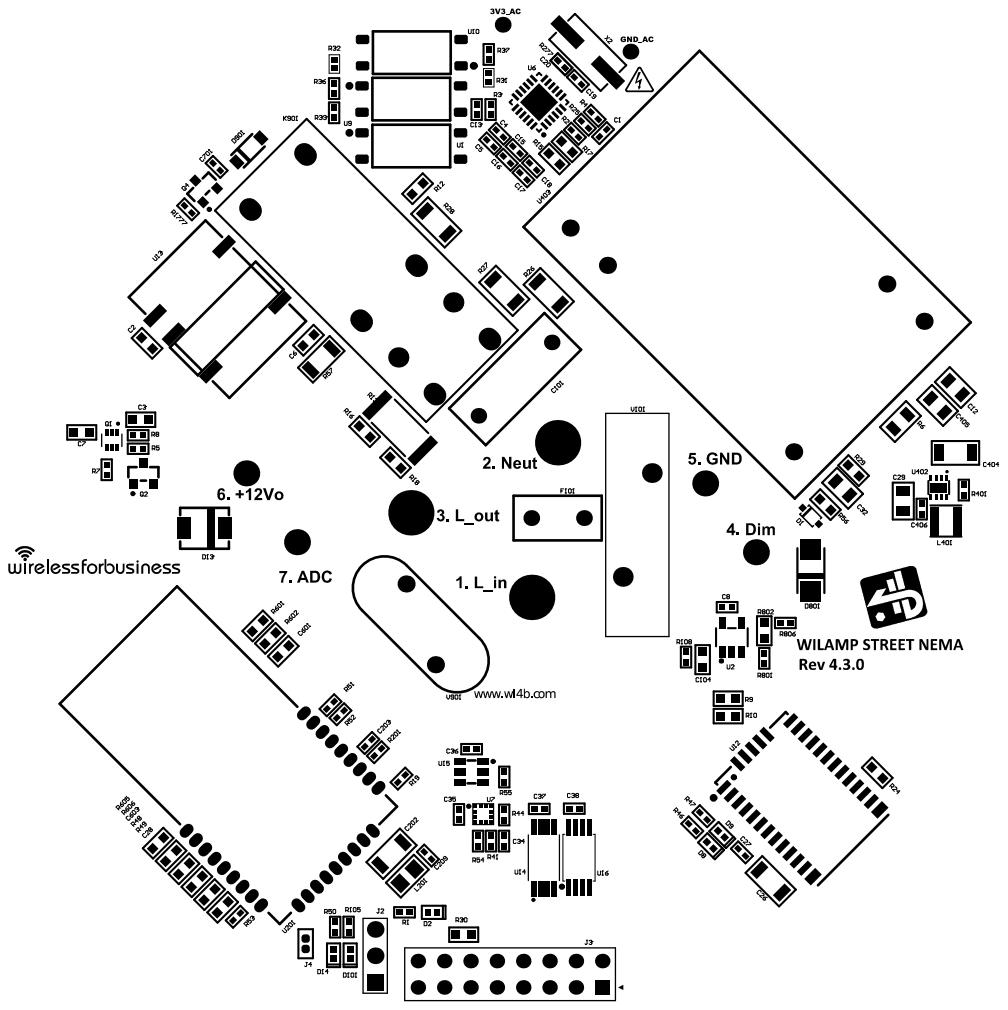
[picture p54: page 1]

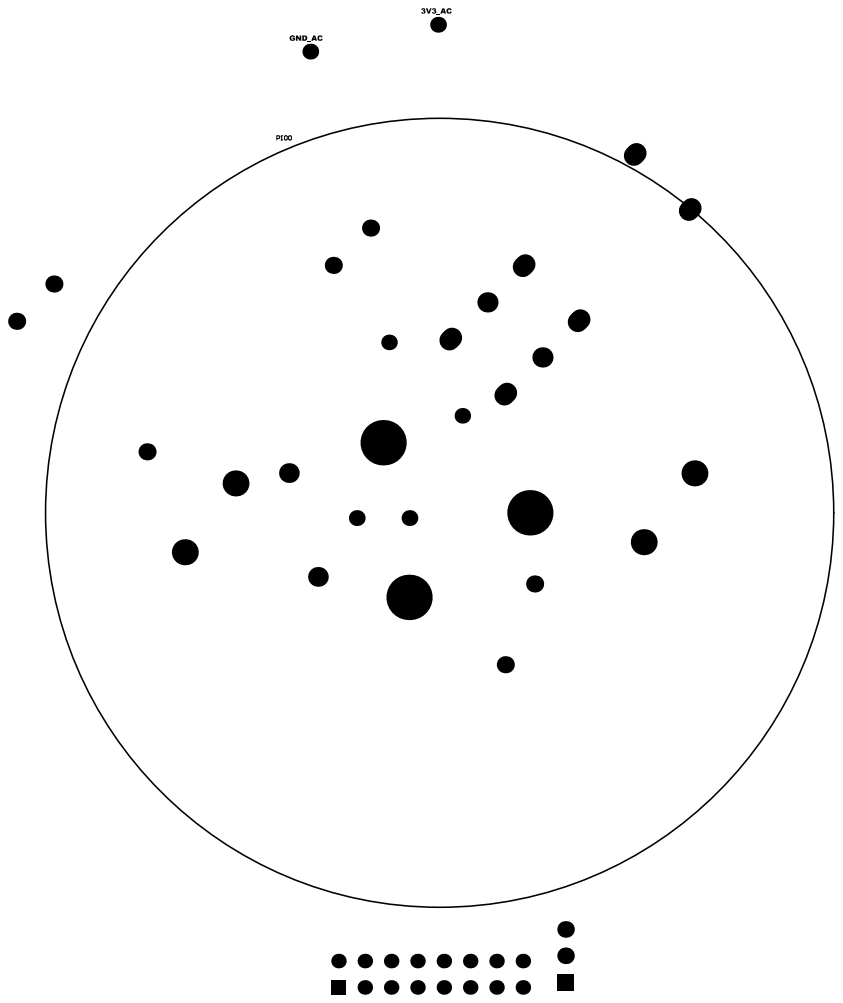
[picture p55: page 2]
