lbalucos/Wi4B_WiSN_5.0/WiSN v5.0.0/mft/pcb/Drill wisn_v4.3.0.pdf

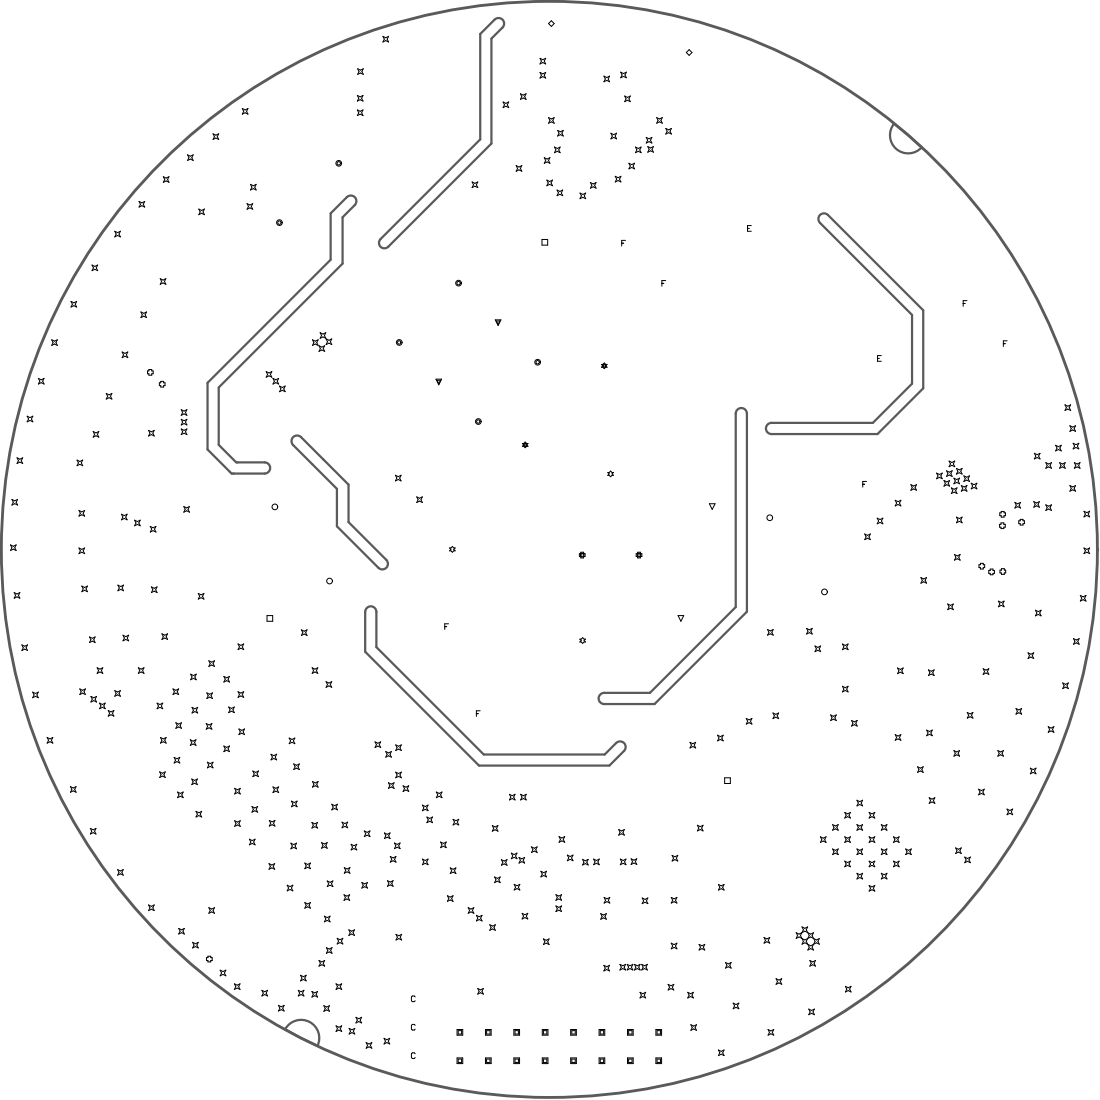
[picture p56: page 1]
