lbalucos/Wi4B_WiSN_5.0/WiCL v1.0_rls_20201028/WiCL v1.0/mft/pca/LibCheck wicl_v1.0.pdf

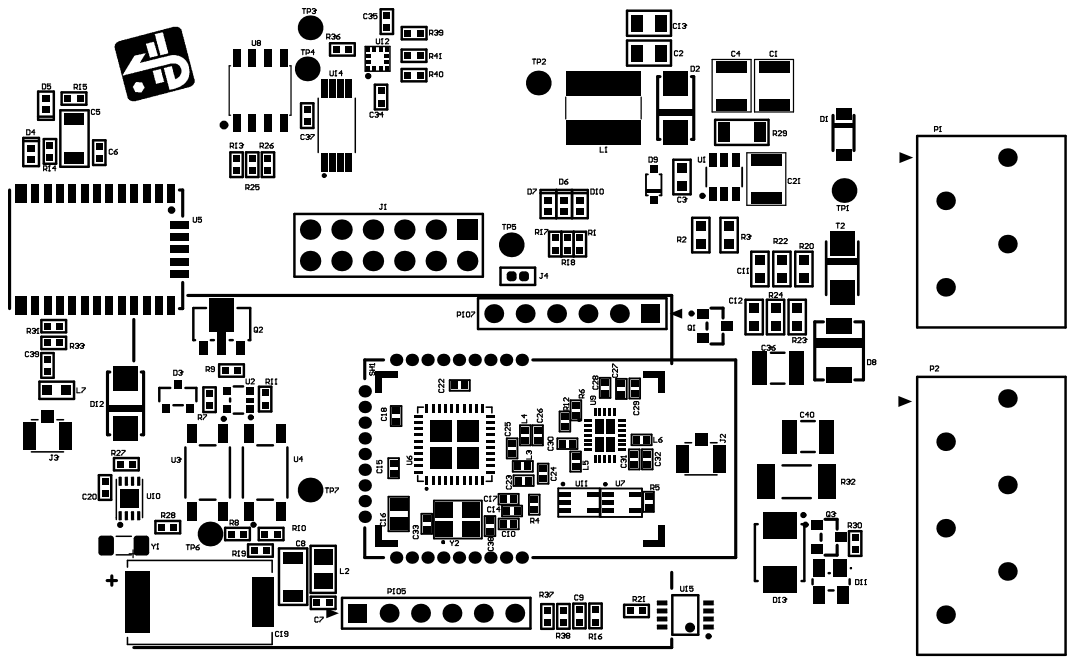
[picture p59: page 1]

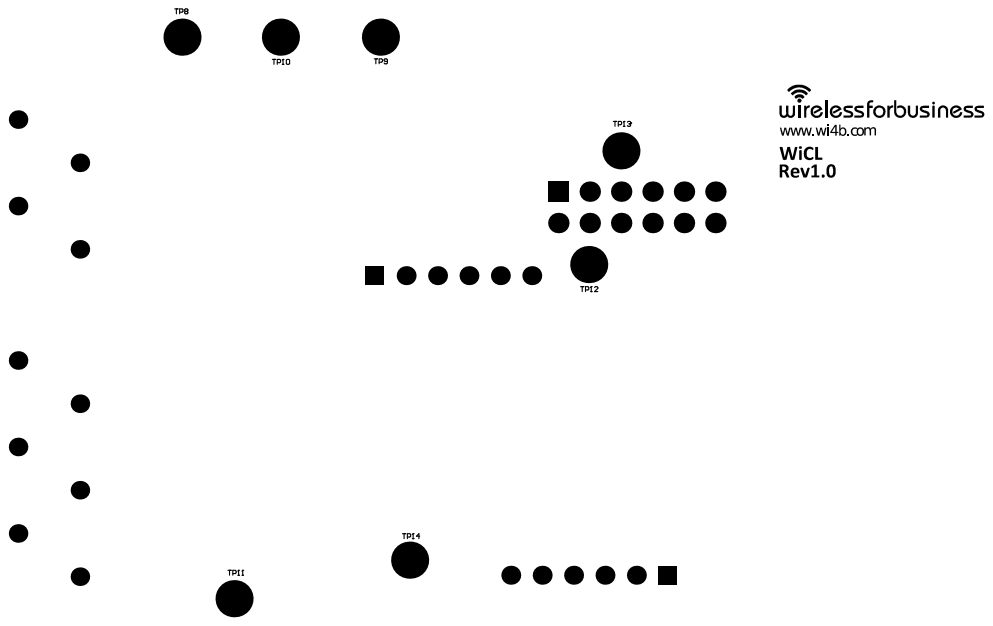
[picture p60: page 2]
