lbalucos/Wi4B_WiSN_5.0/WiCL v1.0_rls_20201028/WiCL v1.0/mft/pcb/Drill wicl_v1.0.pdf

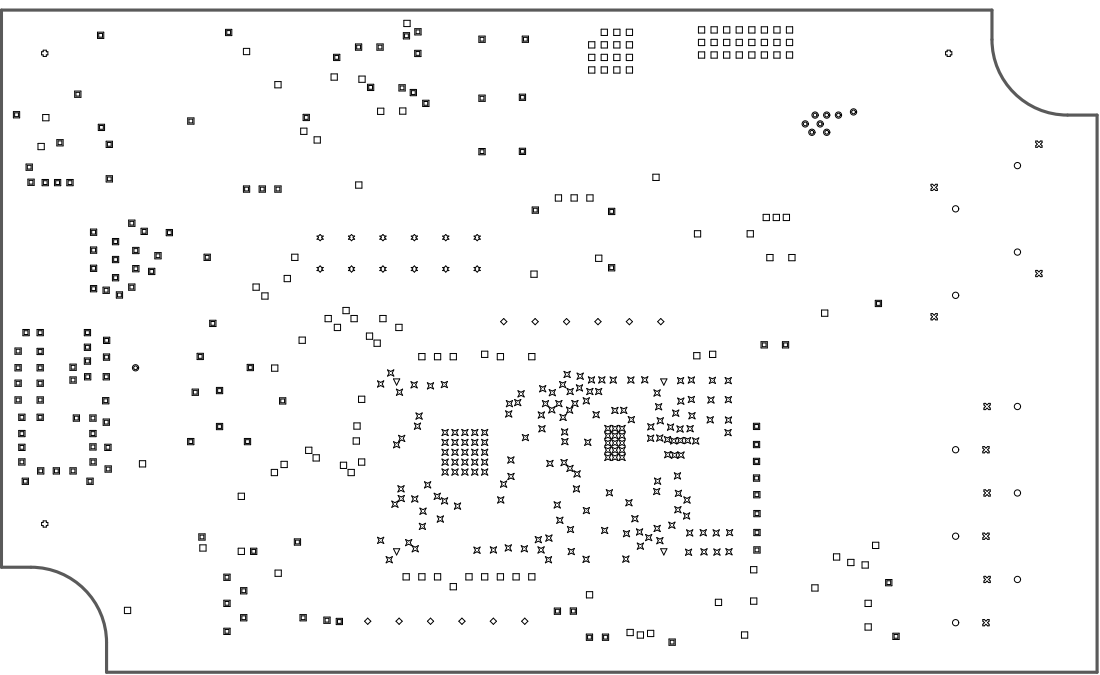
[picture p61: page 1]
