lbalucos/Wi4B_WiSN_5.0/WiCL v1.0_rls_20201028/WiCL v1.0/mft/pcb/WiCL v1.0 gerber.pdf

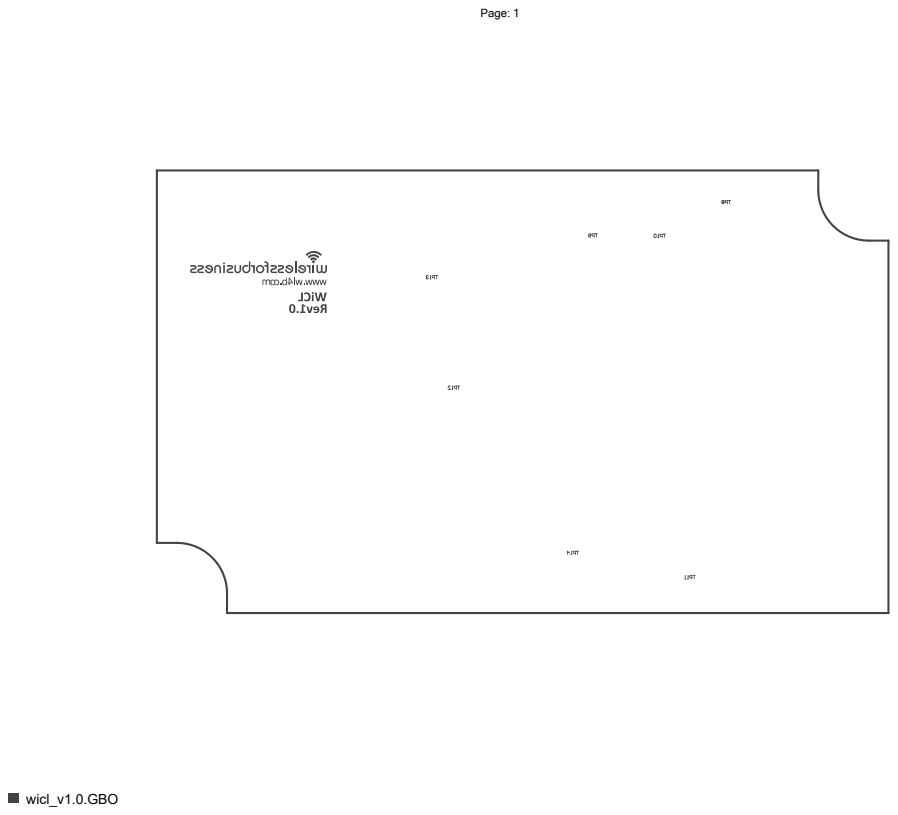
[picture p62: page 1]
wicl_v1.0.GBO

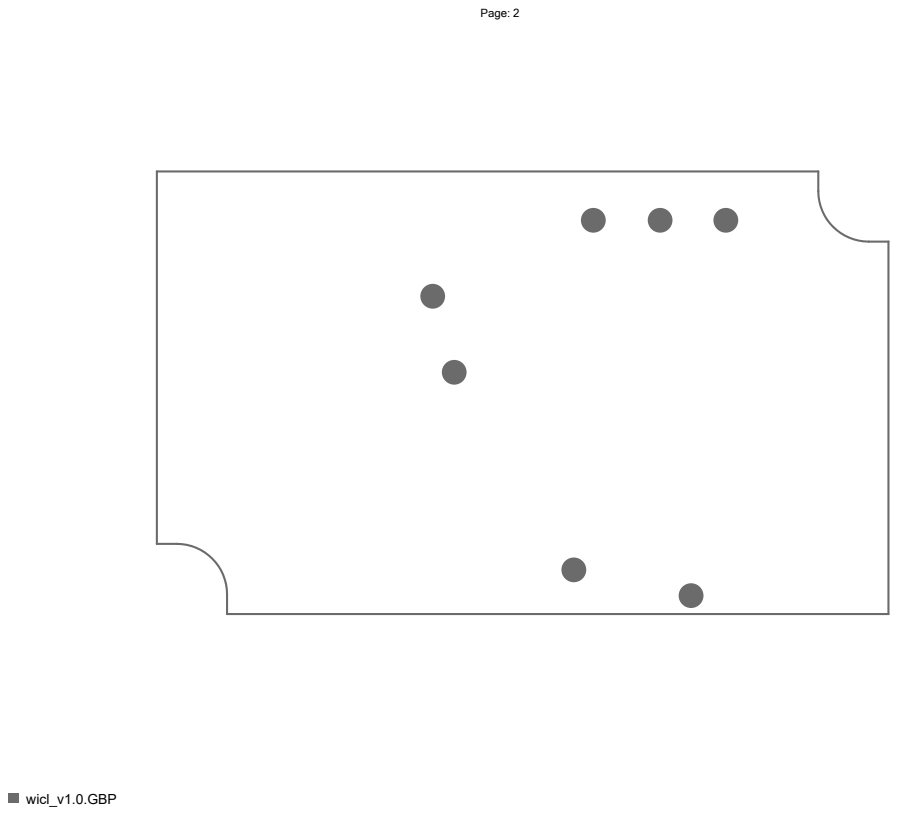
[picture p63: page 2]
wicl_v1.0.GBP

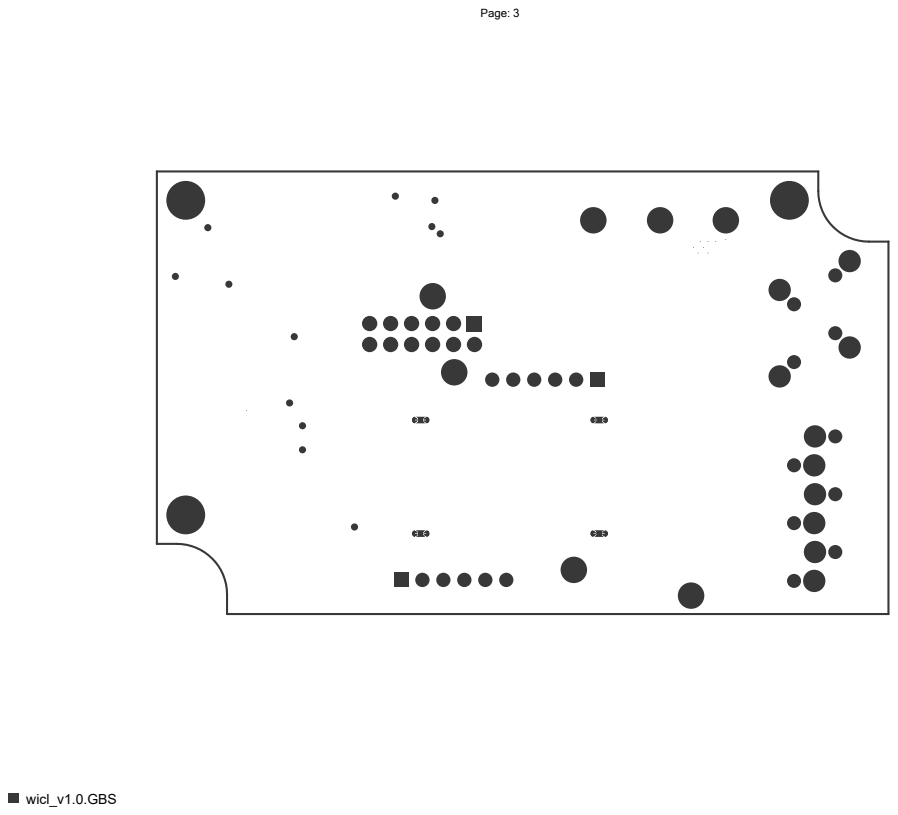
[picture p64: page 3]
wicl_v1.0.GBS

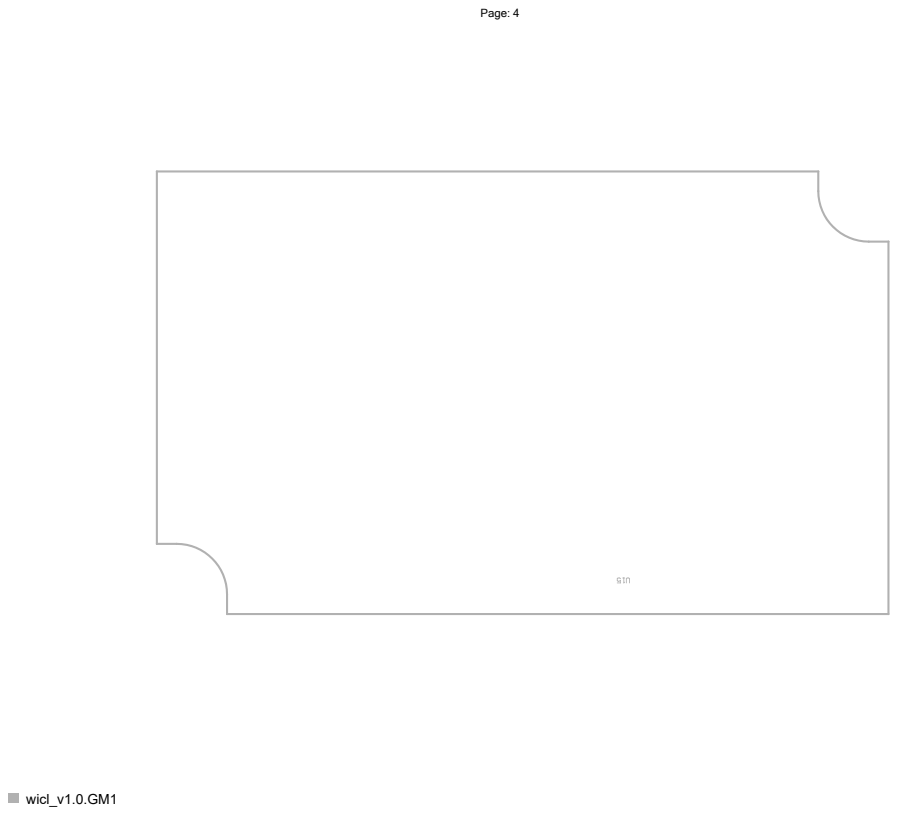
[picture p65: page 4]
wicl_v1.0.GM1

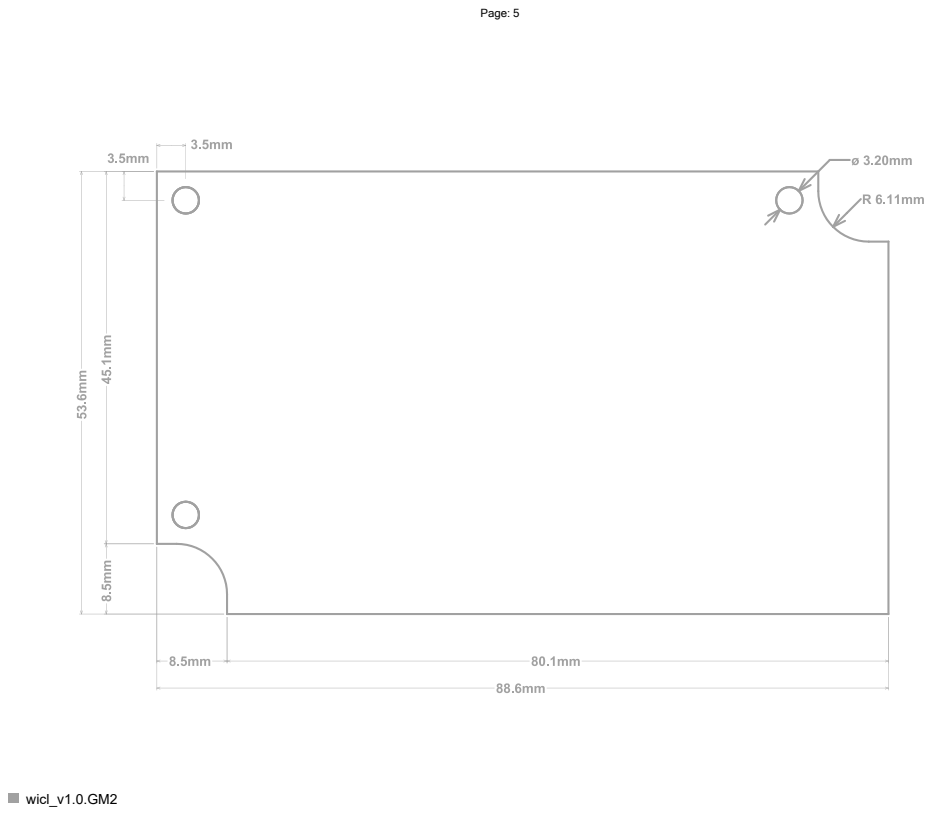
[picture p66: page 5]
wicl_v1.0.GM2

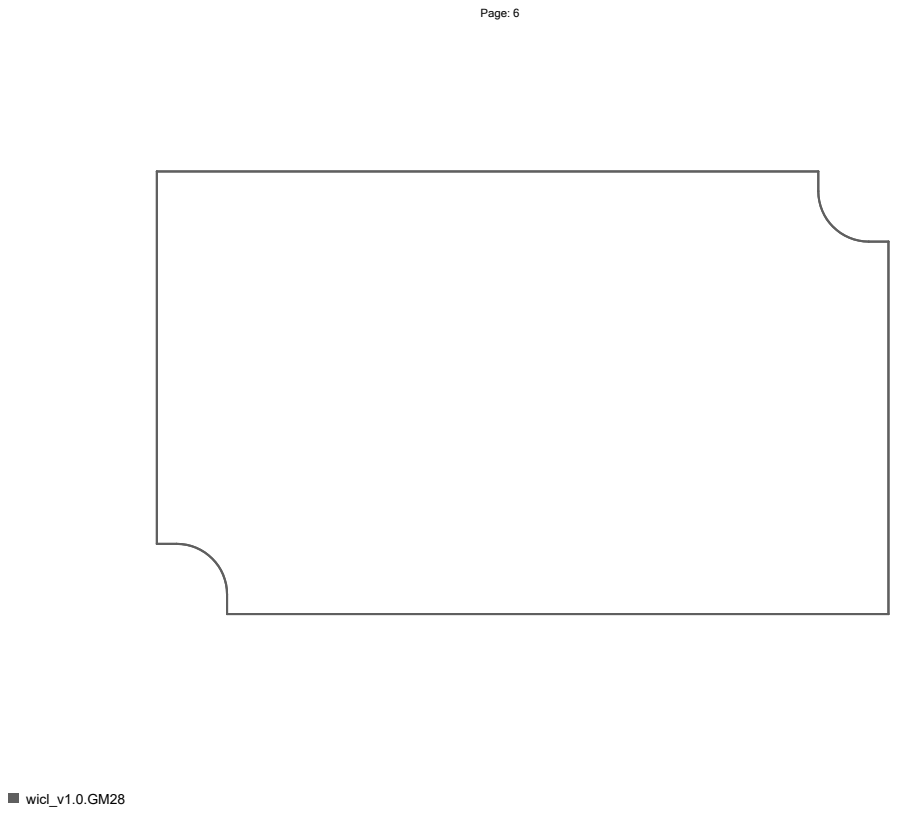
[picture p67: page 6]
wicl_v1.0.GM28

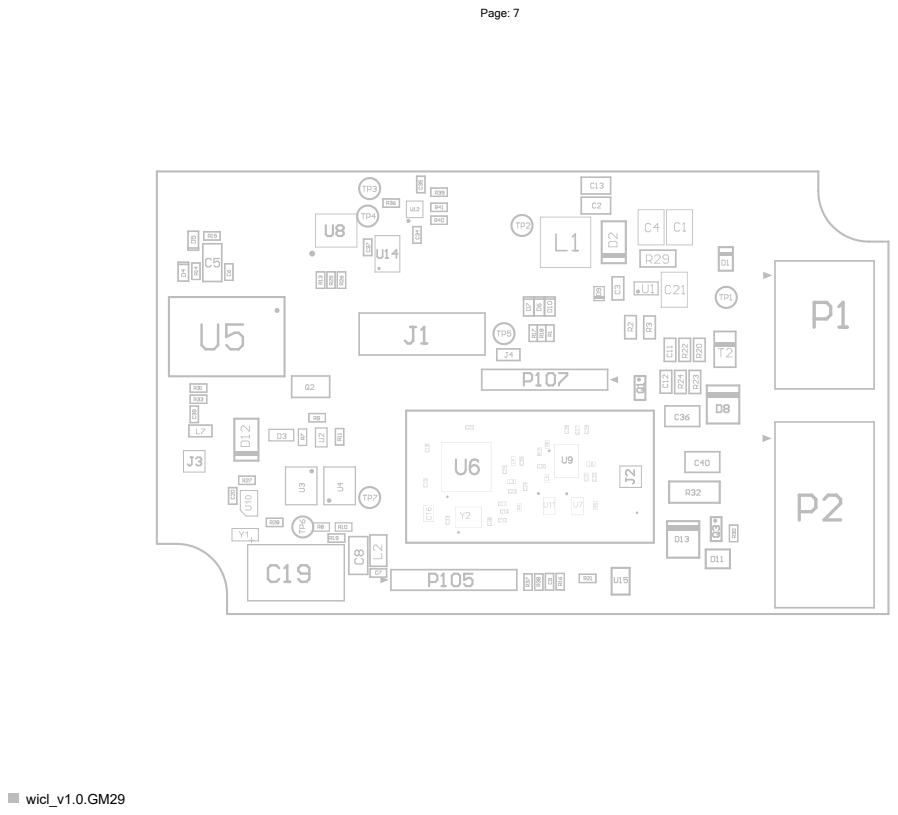
[picture p68: page 7]
wicl_v1.0.GM29

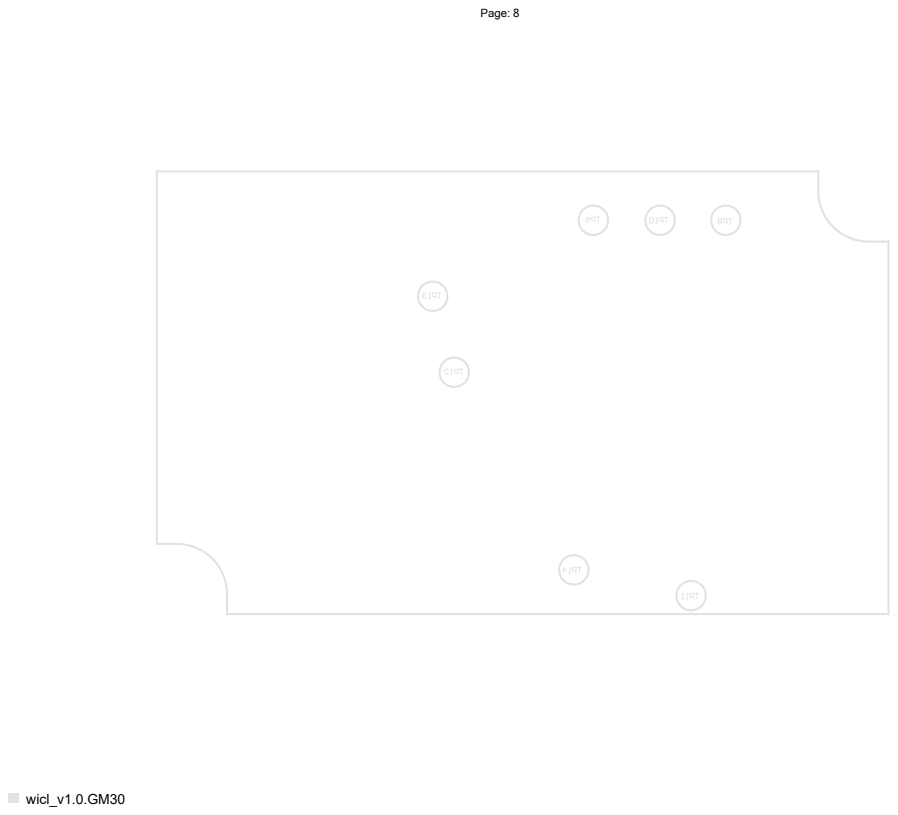
[picture p69: page 8]
wicl_v1.0.GM30

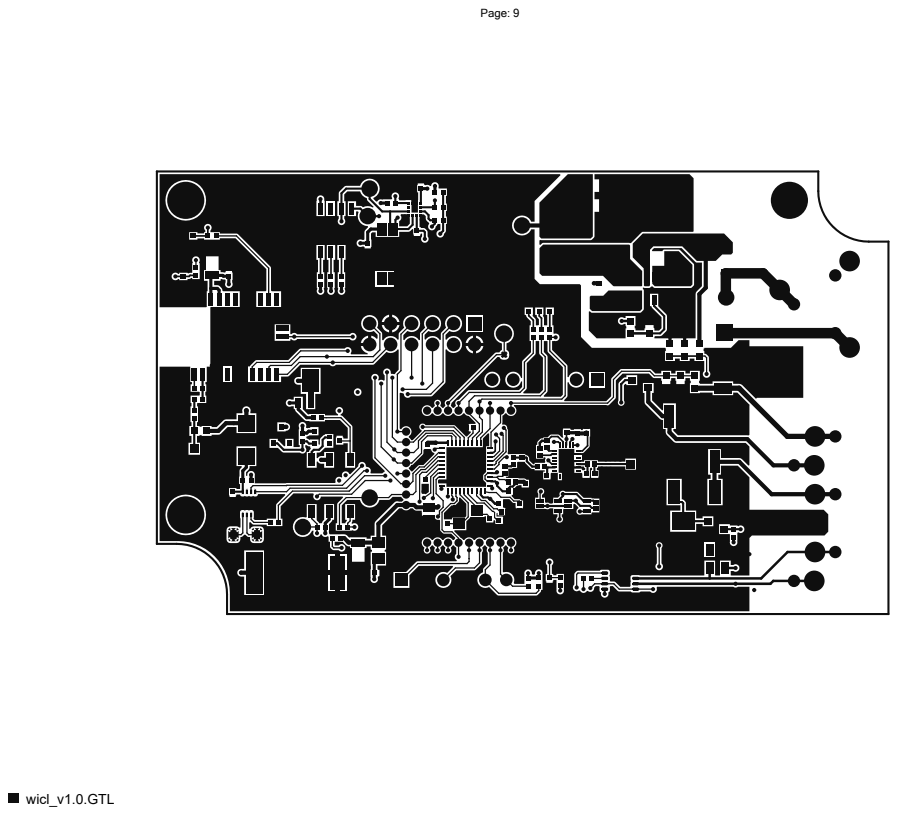
[picture p70: page 9]
wicl_v1.0.GTL

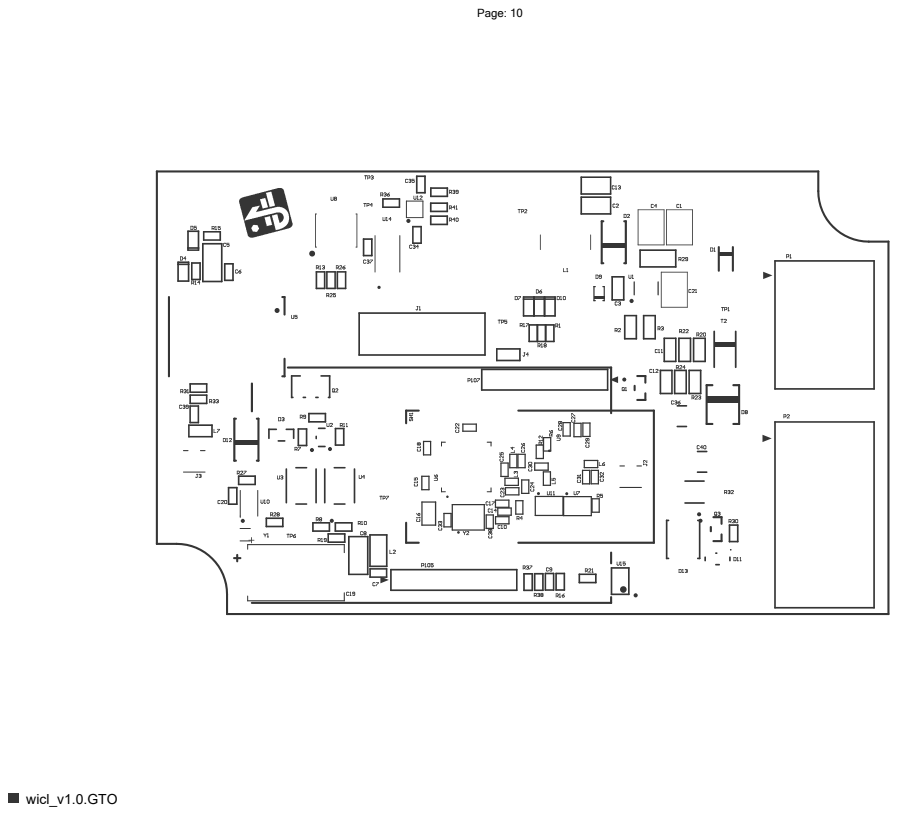
[picture p71: page 10]
wicl_v1.0.GTO

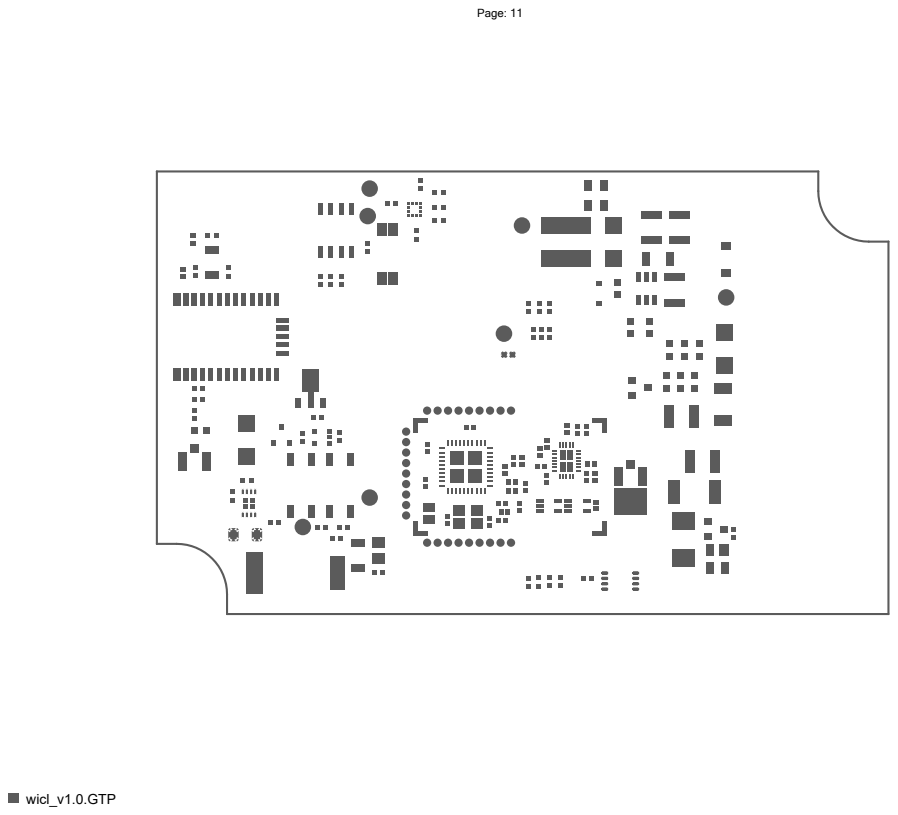
[picture p72: page 11]
wicl_v1.0.GTP

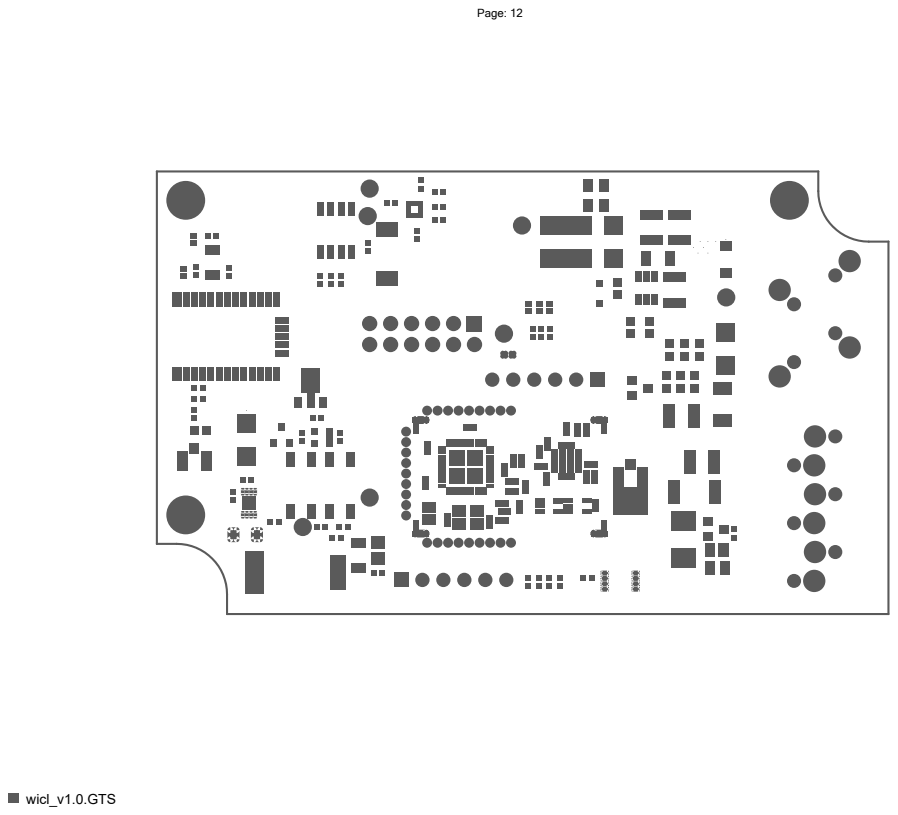
[picture p73: page 12]
wicl_v1.0.GTS

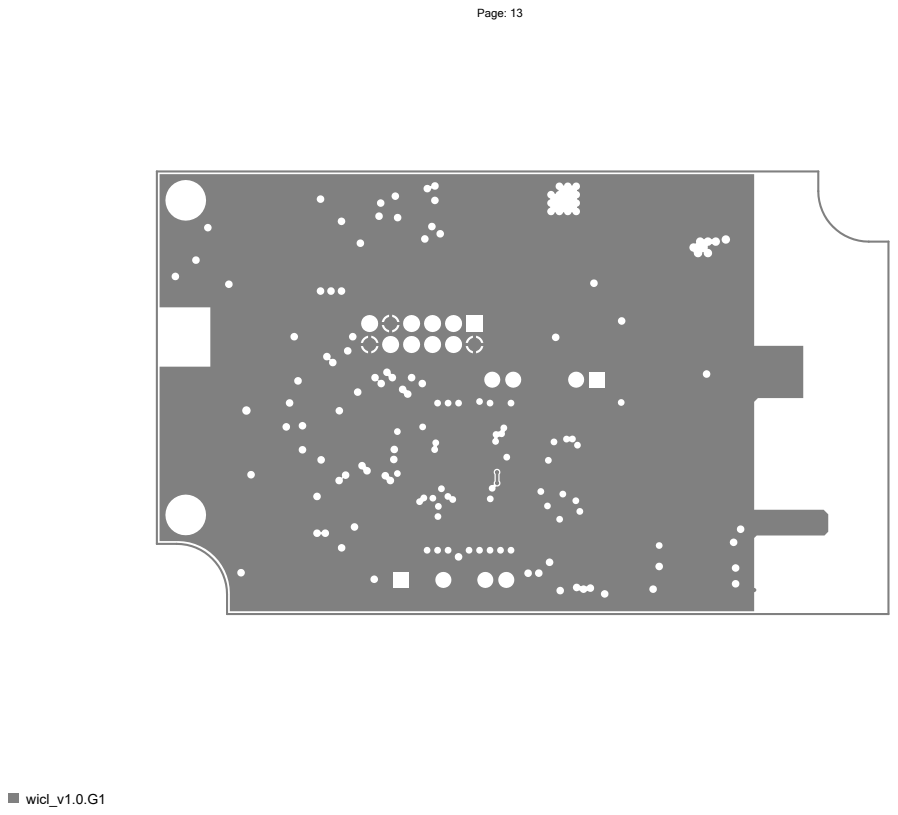
[picture p74: page 13]
wicl_v1.0.G1

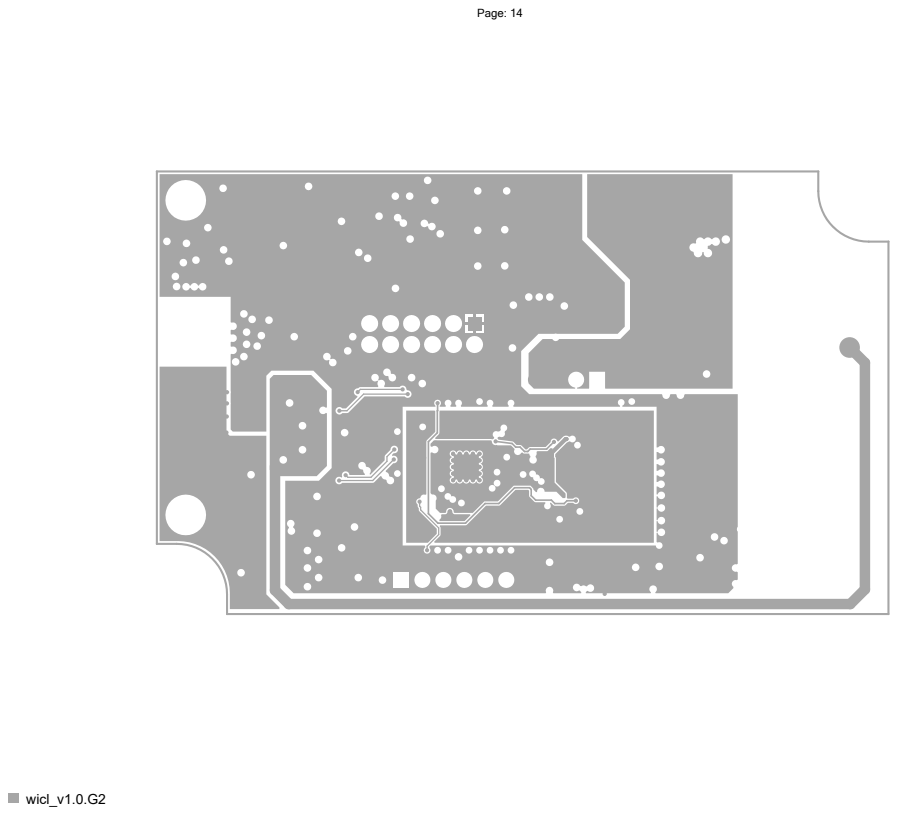
[picture p75: page 14]
wicl_v1.0.G2

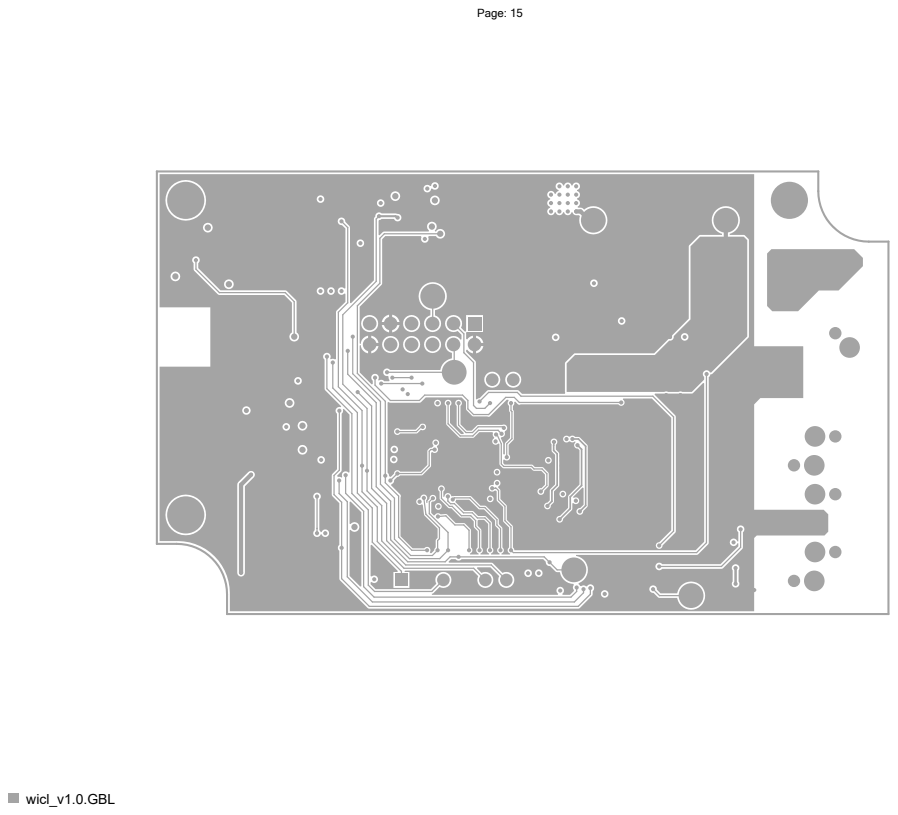
[picture p76: page 15]
wicl_v1.0.GBL

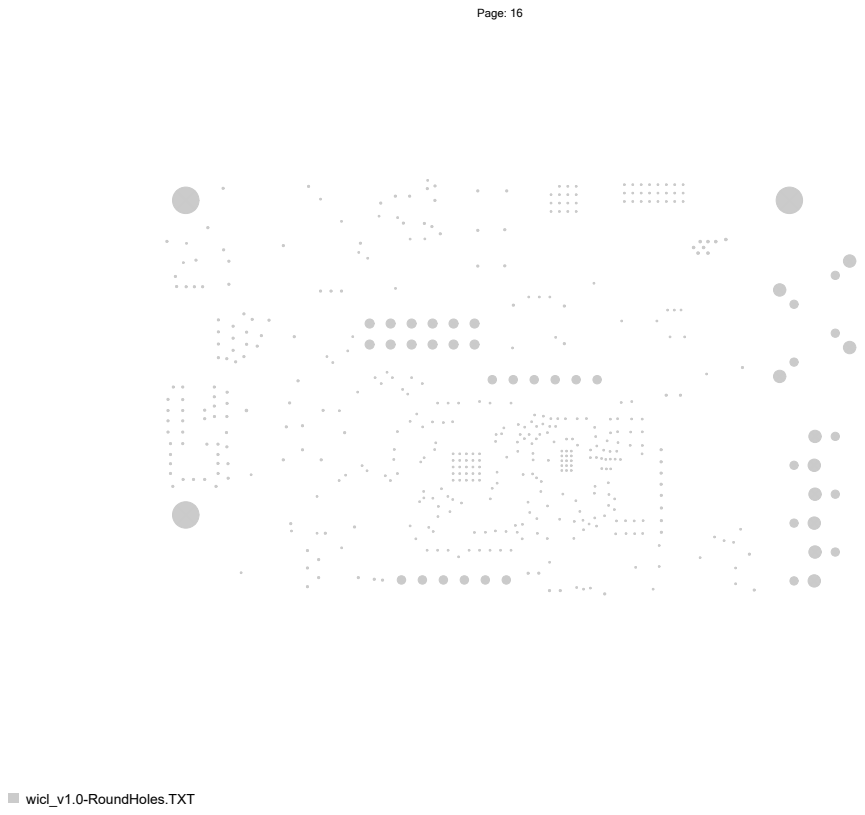
[picture p77: page 16]
wicl_v1.0-RoundHoles.TXT
