lbalucos/Wi4B_WiSN_5.0/(list of files, drawings)

Other design files:
WiCL v1.0_rls_20201028/WiCL v1.0/dsn/doc1_sch/a1_cover_page.SchDoc
WiCL v1.0_rls_20201028/WiCL v1.0/dsn/doc1_sch/a3_revision_history.SchDoc
WiCL v1.0_rls_20201028/WiCL v1.0/dsn/doc1_sch/a4_top_dsn.SchDoc
WiCL v1.0_rls_20201028/WiCL v1.0/dsn/doc1_sch/analog_outputs_blk.SchDoc
WiCL v1.0_rls_20201028/WiCL v1.0/dsn/doc1_sch/dali_phy_blk.SchDoc
WiCL v1.0_rls_20201028/WiCL v1.0/dsn/doc1_sch/DIO_blk.SchDoc
WiCL v1.0_rls_20201028/WiCL v1.0/dsn/doc1_sch/gps_blk.SchDoc
WiCL v1.0_rls_20201028/WiCL v1.0/dsn/doc1_sch/i2c_dev_blk.SchDoc
WiCL v1.0_rls_20201028/WiCL v1.0/dsn/doc1_sch/jn5168_blk.SchDoc
WiCL v1.0_rls_20201028/WiCL v1.0/dsn/doc1_sch/jn5169_blk.SchDoc
WiCL v1.0_rls_20201028/WiCL v1.0/dsn/doc1_sch/main_controller_blk.SchDoc
WiCL v1.0_rls_20201028/WiCL v1.0/dsn/doc1_sch/mcu_blk.SchDoc
WiCL v1.0_rls_20201028/WiCL v1.0/dsn/doc1_sch/Module_blk.SchDoc
WiCL v1.0_rls_20201028/WiCL v1.0/dsn/doc1_sch/power_supply_blk.SchDoc
WiCL v1.0_rls_20201028/WiCL v1.0/dsn/doc1_sch/rtc_blk - Copy.SchDoc
WiCL v1.0_rls_20201028/WiCL v1.0/dsn/doc1_sch/rtc_blk.SchDoc
WiCL v1.0_rls_20201028/WiCL v1.0/dsn/doc3_lib/OM15057-1_I-F2832-C_M06_PCB.PcbLib
WiCL v1.0_rls_20201028/WiCL v1.0/dsn/doc3_lib/Wilamp-st/Wilamp-st.PcbLib
WiCL v1.0_rls_20201028/WiCL v1.0/dsn/doc3_lib/Wilamp-st/Wilamp-st.SchLib
WiCL v1.0_rls_20201028/WiCL v1.0/dsn/doc3_lib/WiSZ/wilamp_st.SCHLIB
WiCL v1.0_rls_20201028/WiCL v1.0/dsn/WiCL.PrjPCB
WiSN v5.0.0/dsn/sch/analog_inputs_blk.SchDoc
WiSN v5.0.0/dsn/sch/analog_outputs_blk.SchDoc
WiSN v5.0.0/dsn/sch/cover_page.SchDoc
WiSN v5.0.0/dsn/sch/dali_dmx_ctrl_blk.SchDoc
WiSN v5.0.0/dsn/sch/dali_phy_blk.SchDoc
WiSN v5.0.0/dsn/sch/energy_meter_blk.SchDoc
WiSN v5.0.0/dsn/sch/gps_blk.SchDoc
WiSN v5.0.0/dsn/sch/i2c_dev_blk.SchDoc
WiSN v5.0.0/dsn/sch/jn5168_blk.SchDoc
WiSN v5.0.0/dsn/sch/power_supply_blk.SchDoc
WiSN v5.0.0/dsn/sch/pwm_output_blk.SchDoc
WiSN v5.0.0/dsn/sch/relay_blk.SchDoc
WiSN v5.0.0/dsn/sch/revision_history.SchDoc
WiSN v5.0.0/dsn/sch/switch_blk.SchDoc
WiSN v5.0.0/dsn/sch/top_dsn.SchDoc
WiSN v5.0.0/dsn/WiSN.PrjPCB
